junado/thermomix-tm31-power-board/datasheets/README.md

# Datasheets

Datasheets are mostly **linked, not mirrored**: they are copyrighted by their manufacturers. The exception is the
discontinued microcontroller, whose datasheet is **archived unmodified in [archive/](archive/NOTICE.md)** (with a
SHA-256 manifest) so the schematic stays usable if the last copies online disappear. Several links point to
distributor or datasheet-archive pages because the original manufacturer pages for these older parts have moved.
Links were collected in November 2026 (web searches; TI, ST and Nexperia links follow those manufacturers' standard
datasheet URLs). If one breaks, search for the part number.

| Ref | Part | Datasheet |
|---|---|---|
| IC1 | NEC/Renesas µPD78F0034(B), 78K0 8-bit MCU | **[Archived copy](archive/NEC_uPD78F0034_datasheet.pdf)** · [Elcodis (UPD78F0034A, same family)](https://elcodis.com/parts/5704542/UPD78F0034AGK-9ET.html). The pinout used here is from the NEC µPD78F0034 data sheet, p. 6 (64-pin QFP "GC"); port types from p. 11 |
| IC501, IC502 | Infineon (International Rectifier) IR2106S | [Findchips: IR2106S](https://www.findchips.com/detail/ir2106s/Infineon-Technologies-AG) |
| IC503 | 74HC123 / 74HCT123 dual retriggerable monostable | [Nexperia 74HC_HCT123](https://assets.nexperia.com/documents/data-sheet/74HC_HCT123.pdf) |
| IC610 | ST LM393 dual comparator | [ST LM393](https://www.st.com/resource/en/datasheet/lm393.pdf) |
| IC611, IC700 | TI TLC277 dual op-amp | [TI TLC277](https://www.ti.com/lit/ds/symlink/tlc277.pdf) |
| IC200 | TI TL431 shunt reference | [TI TL431](https://www.ti.com/lit/ds/symlink/tl431.pdf) |
| IC100 | Panasonic MIP2E3D (IPD flyback switcher) | [Panasonic MIP2E3DMTSCF](https://uploadcdn.oneyac.com/attachments/files/brand_pdf/panasonic/MIP2E3DMTSCF_E.pdf) (same die family; this board uses MIP2E3DMY) |
| CR700 | ST BTA24-600BW (replacement) / BTA12-600BW (230 V original) | [Findchips: BTA24-600BW](https://findchips.com/detail/BTA24-600BW/STMicroelectronics) · [BTA12-600BW at Conrad](https://www.conrad.fr/p/thyristor-scr-triac-stmicroelectronics-bta12-600bw-to-220ab-12-a-600-v-1-pcs-151539) |
| PC700 | MOC3063(M) zero-cross opto-triac | [onsemi MOC3063M (Octopart)](https://octopart.com/part/onsemi/MOC3063M) |
| PC501–PC503 | Lite-On LTV-816 | [RS: Lite-On LTV-816](https://uk.rs-online.com/web/p/optocoupler-ics/1689659) |
| Q500–Q505 | Infineon SGP04N60 (marking G04N60) | [SGP04N60 (Alldatasheet)](https://html.alldatasheet.com/html-pdf/93965/INFINEON/SGP04N60/2938/9/SGP04N60.html) |
| Small NPN / PNP | BC846 / BC856 family (SOT-23) | [Nexperia BC846 series](https://assets.nexperia.com/documents/data-sheet/BC846_SER.pdf) · [Nexperia BC856 series](https://assets.nexperia.com/documents/data-sheet/BC856_SER.pdf) |
| RY200, RY202 | TE/Schrack RTH34012WG (RT1 16 A, 12 V DC) | [RTH34012 specification](https://manualmachine.com/tyco/rth34012/27845218-specification) |
| RY201 | Song Chuan 899-1C-F-C 12 V DC | [899-1C-F-C-12VDC (Scribd)](https://www.scribd.com/document/621802395/899-1C-F-C-12VDC) · [Findchips: 899 series](https://findchips.com/detail/899-1c-f-s-12vdc/Song-Chuan-Precision-Company) |

Not found: HARTU 711078-51 current transformer, D1D8A flyback transformer (custom parts).
