junado/thermomix-tm31-power-board/docs/16-references.md

# 16 — References

## Repair forums (French, CommentReparer.com)

- [Réparer platine de puissance Thermomix TM31](https://www.commentreparer.com/19283/Robot-mixeur/reparer-platine-de-puissance-Thermomix-TM31):
  shorted BTA12-600BW triac → continuous heating / error 69; replacement procedure (drill the rivet, thermal paste,
  screw).
- [Thermomix TM 31 qui ne chauffe plus](https://www.commentreparer.com/84308/Robot-mixeur/Thermomix-TM-31-qui-ne-chauffe-plus):
  same no-heat, no-error symptom on a first-generation TM31; fixed by a used power board.
- [Thermomix Tm 31 qui ne chauffe plus](https://www.commentreparer.com/45891/Robot-mixeur/Thermomix-Tm-31-qui-ne-chauffe-plus)
- [Thermomix erreur 69 pas de chauffe](https://www.commentreparer.com/66512/Robot-mixeur/Thermomix-erreur-69-pas-de-chauffe):
  bowl pin numbering and the service-guide values.
- [Diagnostique Bol TM31 / valeurs résistance ?](https://www.commentreparer.com/53848/Robot-mixeur/Diagnostique-Bol-TM31-valeurs-resistance):
  includes a 120 V TM31 triac reading (~73 Ω in-circuit).
- [Thermomix TM31 (relay stuck / triac shorted)](https://www.commentreparer.com/37863/Robot-mixeur/Thermomix-TM31)
- [Thermomix TM31 ne fonctionne plus](https://www.commentreparer.com/33611/Robot-mixeur/Thermomix-TM31-ne-fonctionne-plus):
  MIP2E1DMY switcher, relays feeding the bulk capacitor (230 V board).
- [Panne TM31 plus aucune indication](https://www.commentreparer.com/80752/Robot-mixeur/Panne-TM31-plus-aucune-indication)
- [Comment réparer un thermomix tm 31](https://www.commentreparer.com/36592/Robot-mixeur/Comment-reparer-un-thermomix-tm-31):
  error 72 = power relay (Omron G5LA on that board).
- [Erreur 39 thermomix T31](https://www.commentreparer.com/48958/Robot-mixeur/Erreur-39-thermomix-T31)
- [Réparer un Thermomix TM31-1](https://www.commentreparer.com/85205/Robot-mixeur/Reparer-un-Thermomix-TM31-1)

## Service documentation

- [Procédure d'intervention technique sur le TM31 (PDF, French)](https://www.commentreparer.com/doc/21591/Doc-reparation-technique-pdf.pdf):
  common faults, bowl values, heating test, board revision compatibility table, error explanations.
- [Vorwerk support: TM31 system messages (error codes)](https://support-gb.vorwerk.com/hc/en-gb/articles/18202488537116-My-Thermomix-TM31-is-showing-a-system-message)
- [Vorwerk TM31 instruction manual (UK)](https://support.vorwerk.com/hc/article_attachments/360018291699/UK_Thermomix-tm31-user-manual.pdf)

## Other

- [netzwelt.de: end of TM31 support (German)](https://www.netzwelt.de/news/235081-achtung-diesen-thermomix-gibt-bald-keinen-support-mehr.html)
- [EmbDev.net: TM31 shuts off during start (power-board boot loop)](https://embdev.net/topic/570063)

Datasheets: see [../datasheets/README.md](../datasheets/README.md).
