junado/thermomix-tm31-power-board/datasheets/archive/MANIFEST.md

# Archive manifest

| File | Part | Document | Pages | Source | Added | SHA-256 |
|---|---|---|---|---|---|---|
| [NEC_uPD78F0034_datasheet.pdf](NEC_uPD78F0034_datasheet.pdf) | IC1, NEC µPD78F0034(B) 78K0 8-bit flash MCU | NEC data sheet, µPD78F0034 / 78F0034B (PDF created 2000-12-17) | 26 | Copy supplied by the board owner (public datasheet download) | 2026-11-03 | `30c4f615ae8eee96108fa626ede6035724c40eb1b846c4c8780f177ac3665092` |

Pages used in this project: p. 6 (64-pin QFP "GC" pinout) and p. 11 (port types; P30–P33 are N-channel open-drain).

Check a file with `sha256sum <file>` (Linux), `shasum -a 256 <file>` (macOS) or
`Get-FileHash <file>` (PowerShell).
