junado/thermomix-tm31-power-board/images/diagrams/block-diagram.png

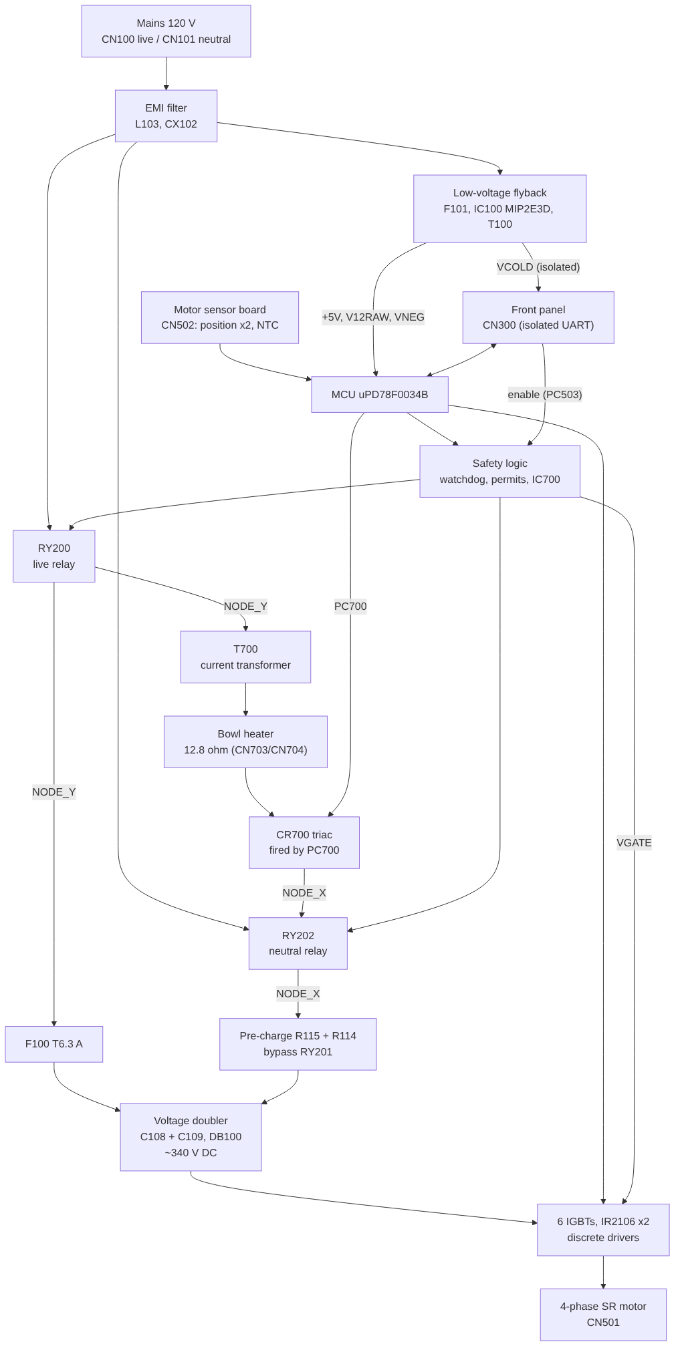
images/diagrams/block-diagram.png
