junado/thermomix-tm31-power-board/images/diagrams/safety-logic.png

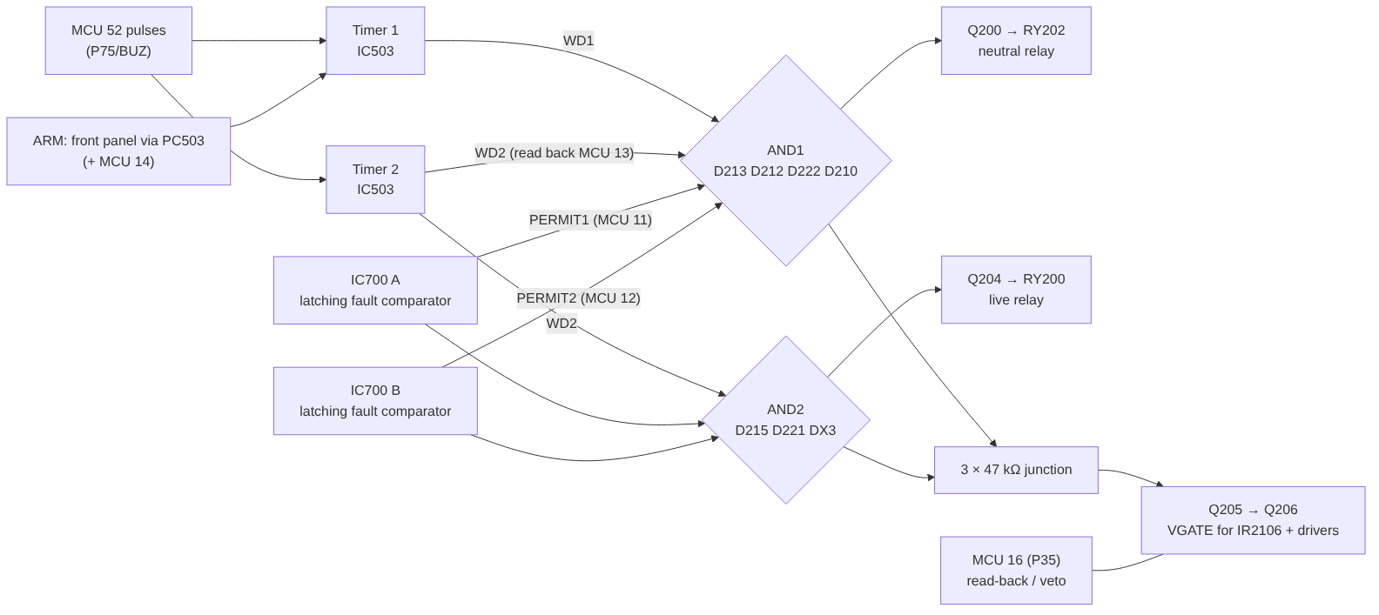
images/diagrams/safety-logic.png
