junado/thermomix-tm31-power-board/photos/01-in-machine/board-in-machine-wide.jpg

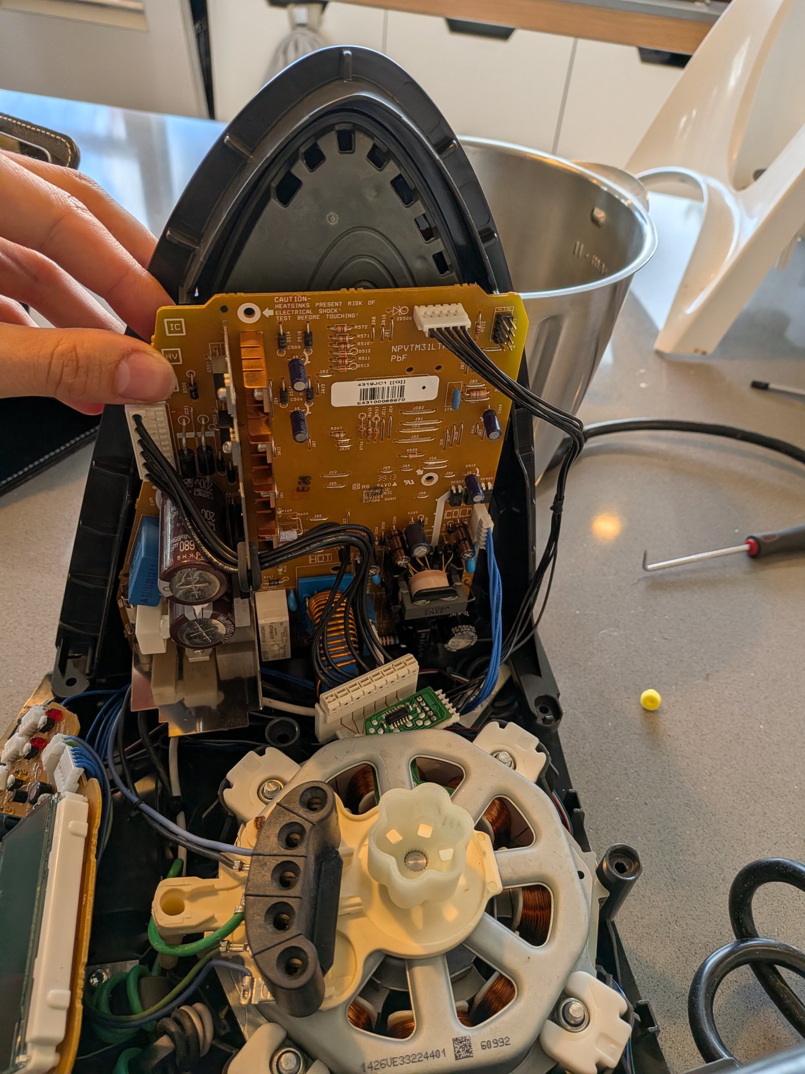
photos/01-in-machine/board-in-machine-wide.jpg
