junado/thermomix-tm31-power-board/photos/01-in-machine/board-top-edge-cn502-cn503.jpg

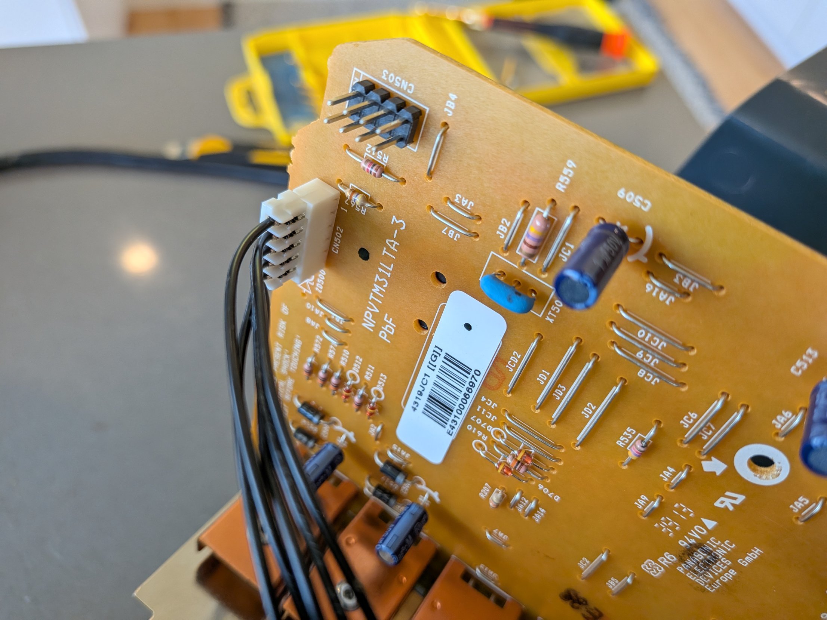
photos/01-in-machine/board-top-edge-cn502-cn503.jpg
