junado/thermomix-tm31-power-board/photos/02-triac/cr700-triac-marking-closeup.jpg

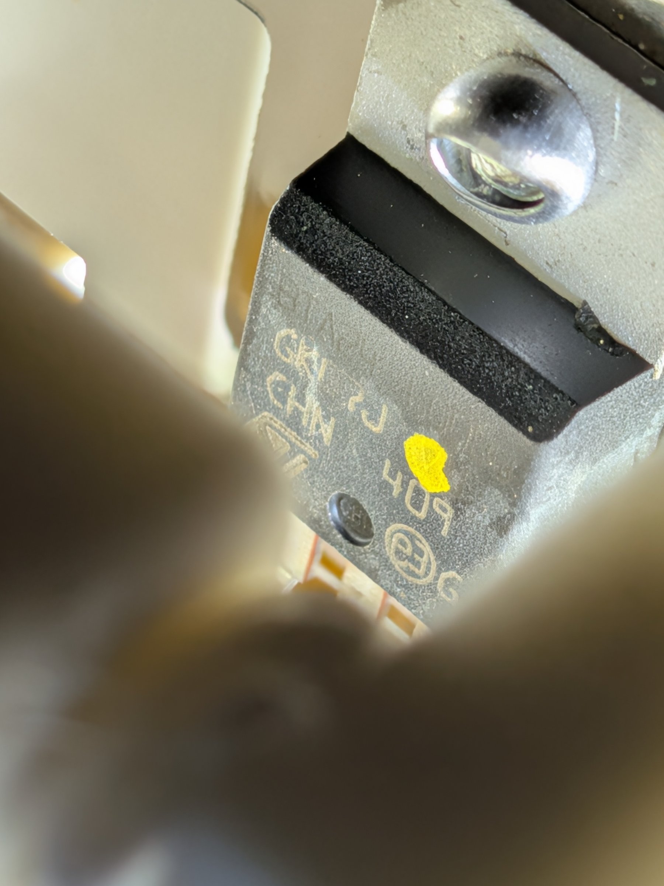
photos/02-triac/cr700-triac-marking-closeup.jpg
