junado/thermomix-tm31-power-board/photos/02-triac/cr700-triac-original-marking.jpg

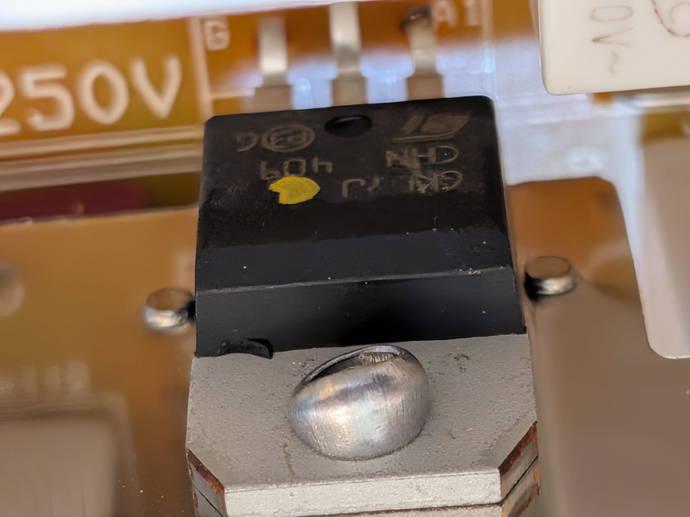
photos/02-triac/cr700-triac-original-marking.jpg
