junado/thermomix-tm31-power-board/photos/03-component-side/bulk-caps-and-heatsink.jpg

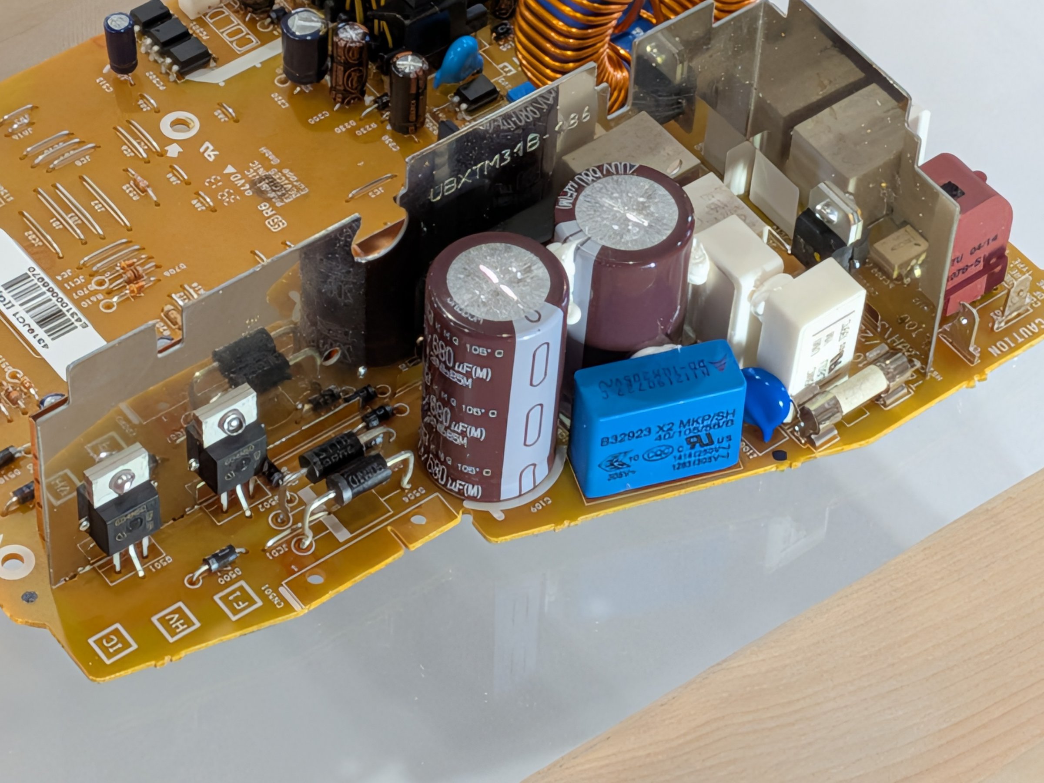
photos/03-component-side/bulk-caps-and-heatsink.jpg
