junado/thermomix-tm31-power-board/photos/03-component-side/component-side-backlit.jpg

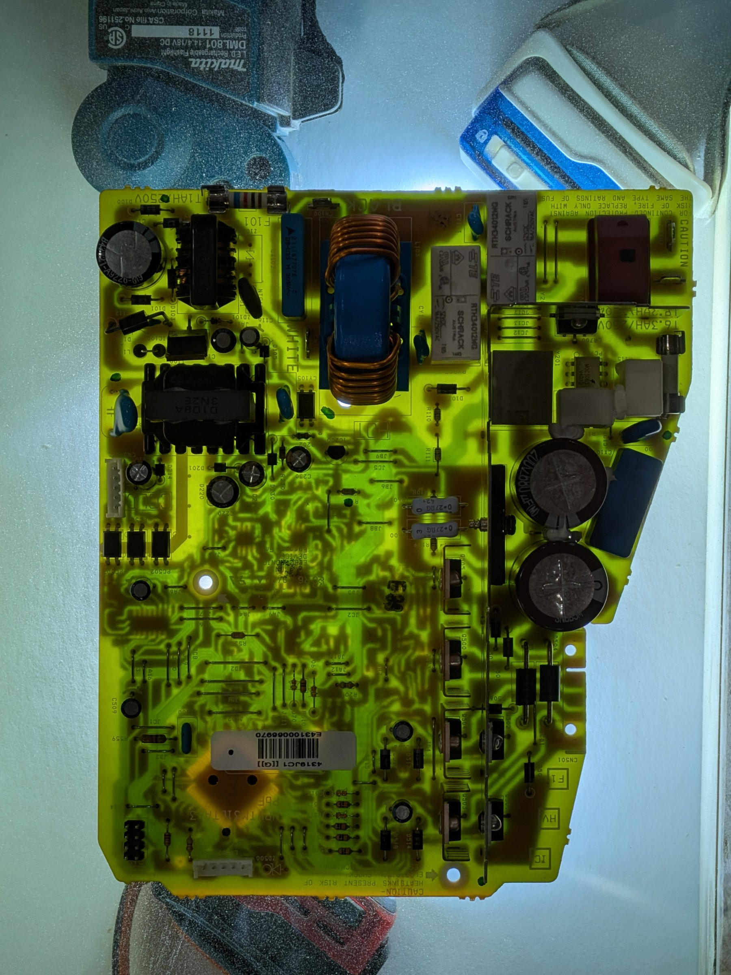
photos/03-component-side/component-side-backlit.jpg
