junado/thermomix-tm31-power-board/photos/03-component-side/component-side-full.jpg

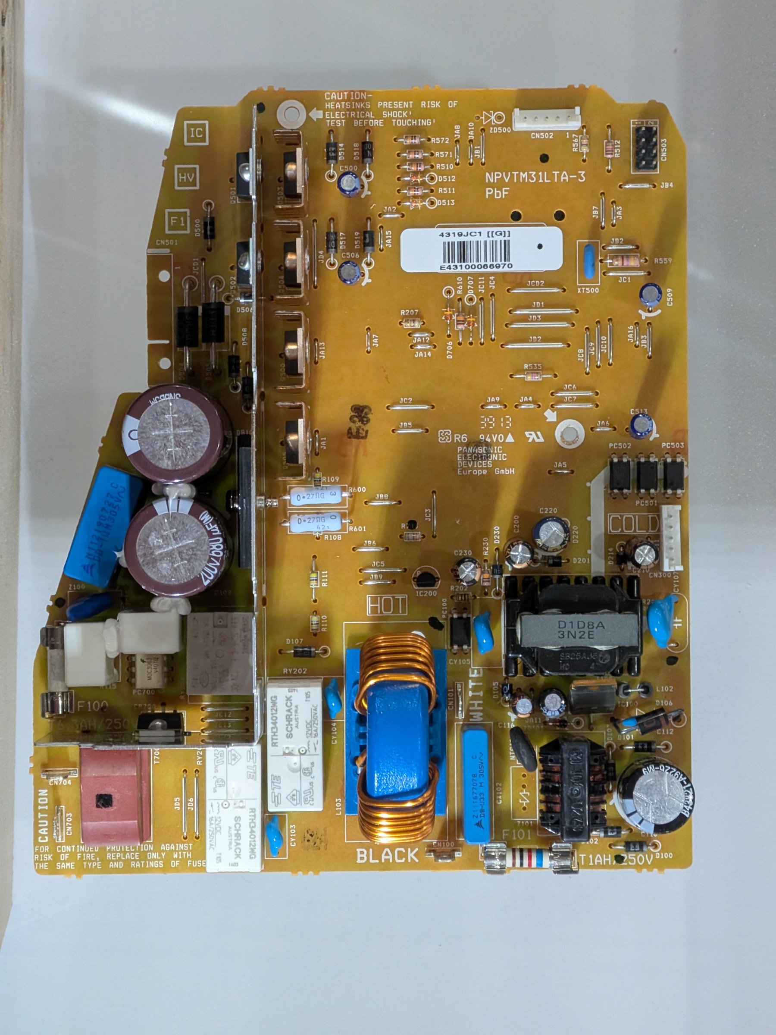
photos/03-component-side/component-side-full.jpg
