junado/thermomix-tm31-power-board/photos/03-component-side/relays-and-filter.jpg

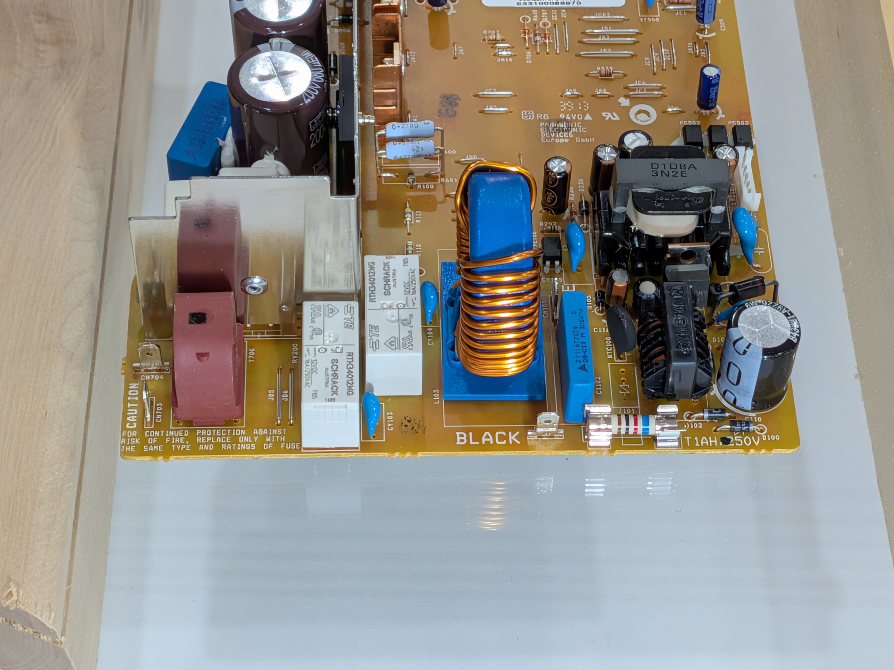
photos/03-component-side/relays-and-filter.jpg
