junado/thermomix-tm31-power-board/images/annotated/solder-side-quadrant-A-cold-side-and-supply.jpg

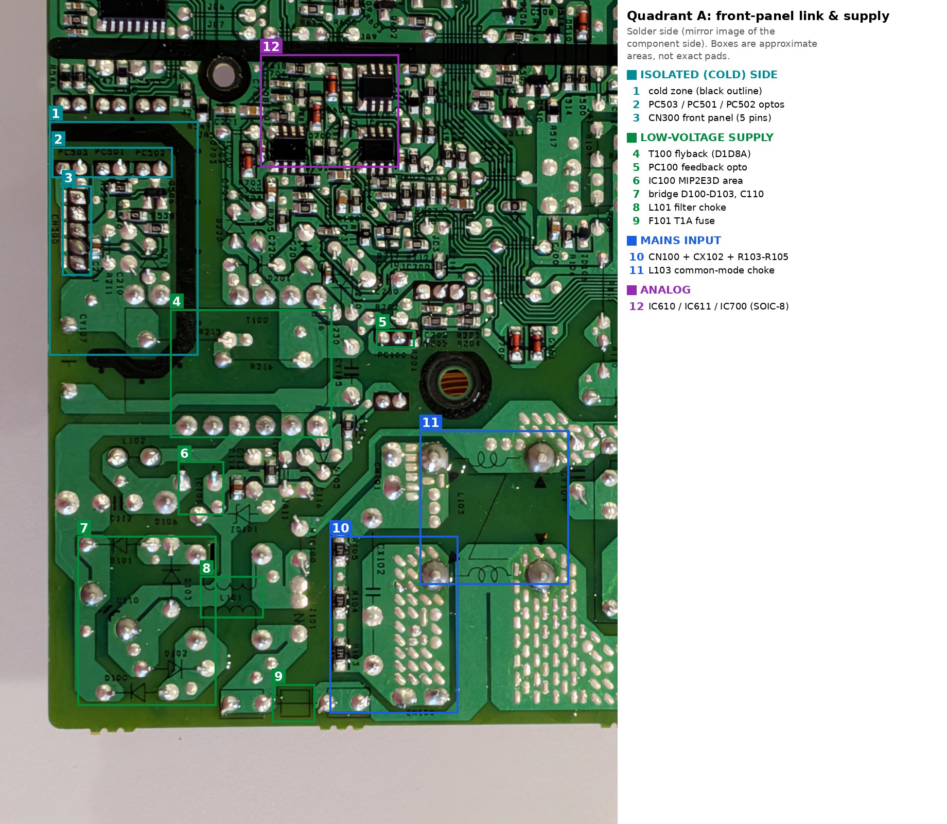
images/annotated/solder-side-quadrant-A-cold-side-and-supply.jpg
