junado/thermomix-tm31-power-board/images/annotated/solder-side-quadrant-B-mcu.jpg

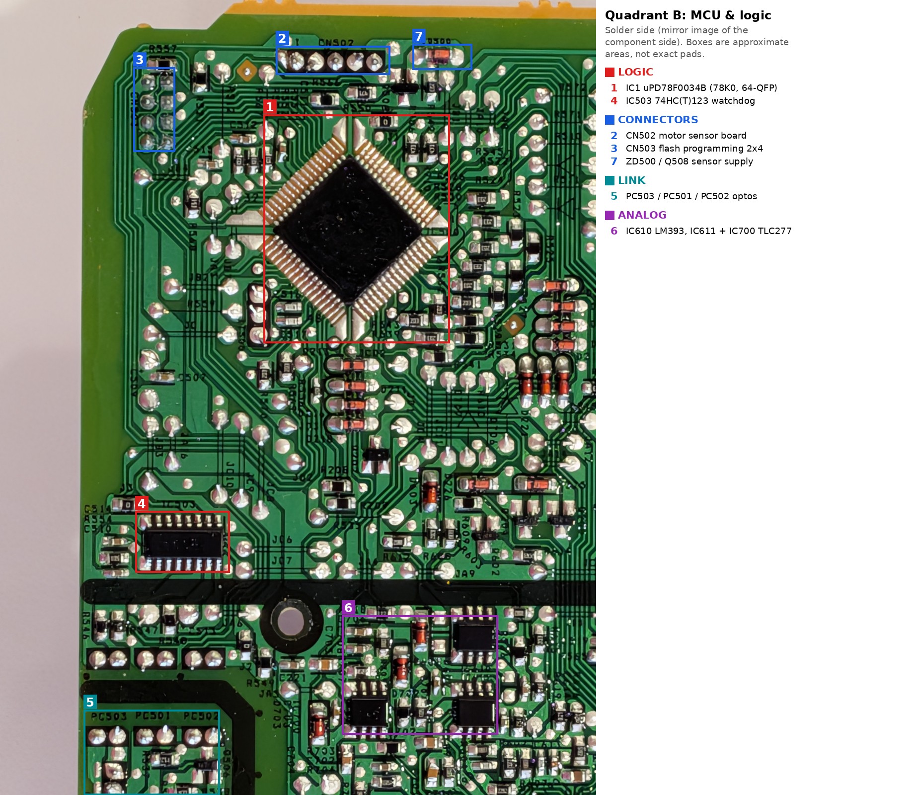
images/annotated/solder-side-quadrant-B-mcu.jpg
