junado/thermomix-tm31-power-board/images/annotated/solder-side-quadrant-C-motor-drive.jpg

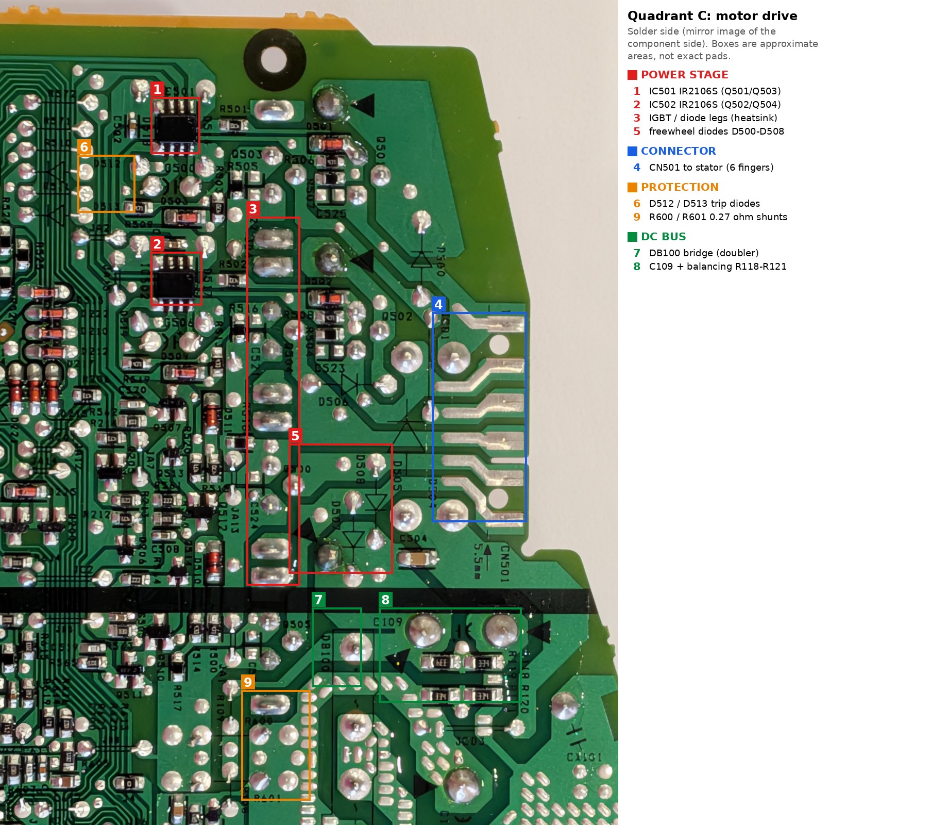
images/annotated/solder-side-quadrant-C-motor-drive.jpg
