junado/thermomix-tm31-power-board/images/annotated/solder-side-quadrant-D-heater-and-power.jpg

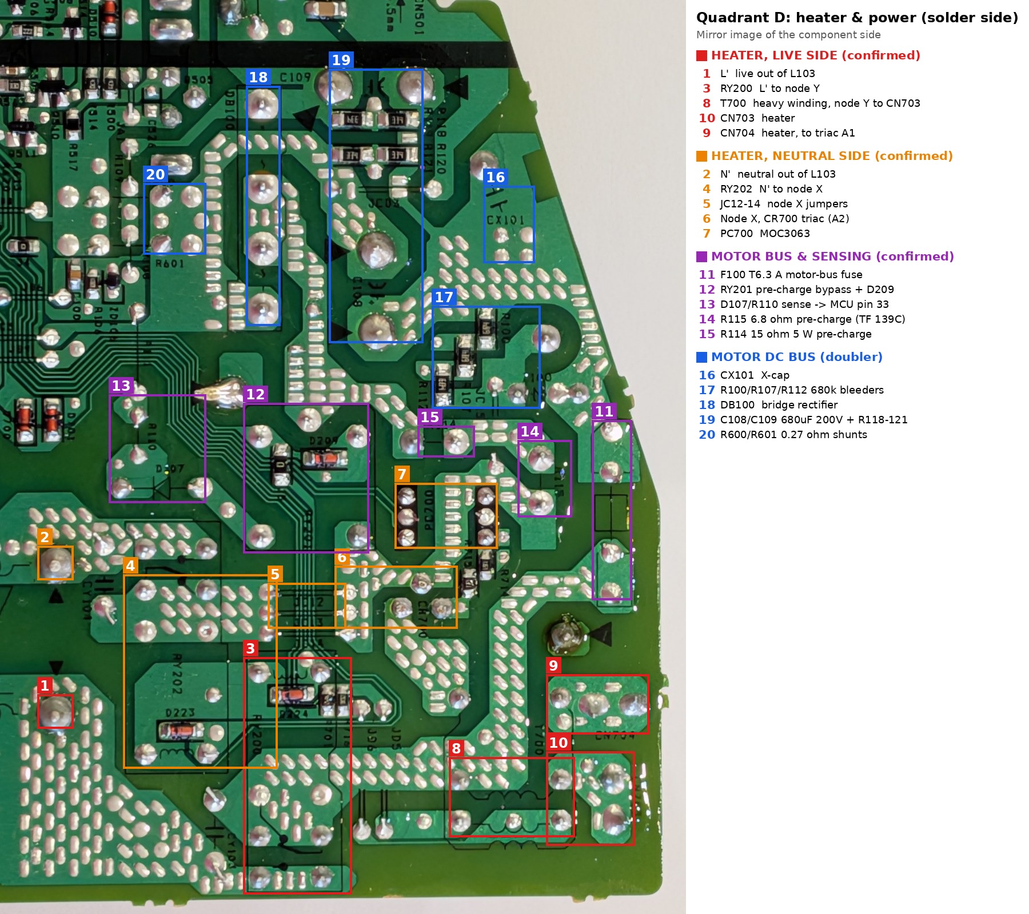
images/annotated/solder-side-quadrant-D-heater-and-power.jpg
