junado/thermomix-tm31-power-board/images/diagrams/machine-wiring.png

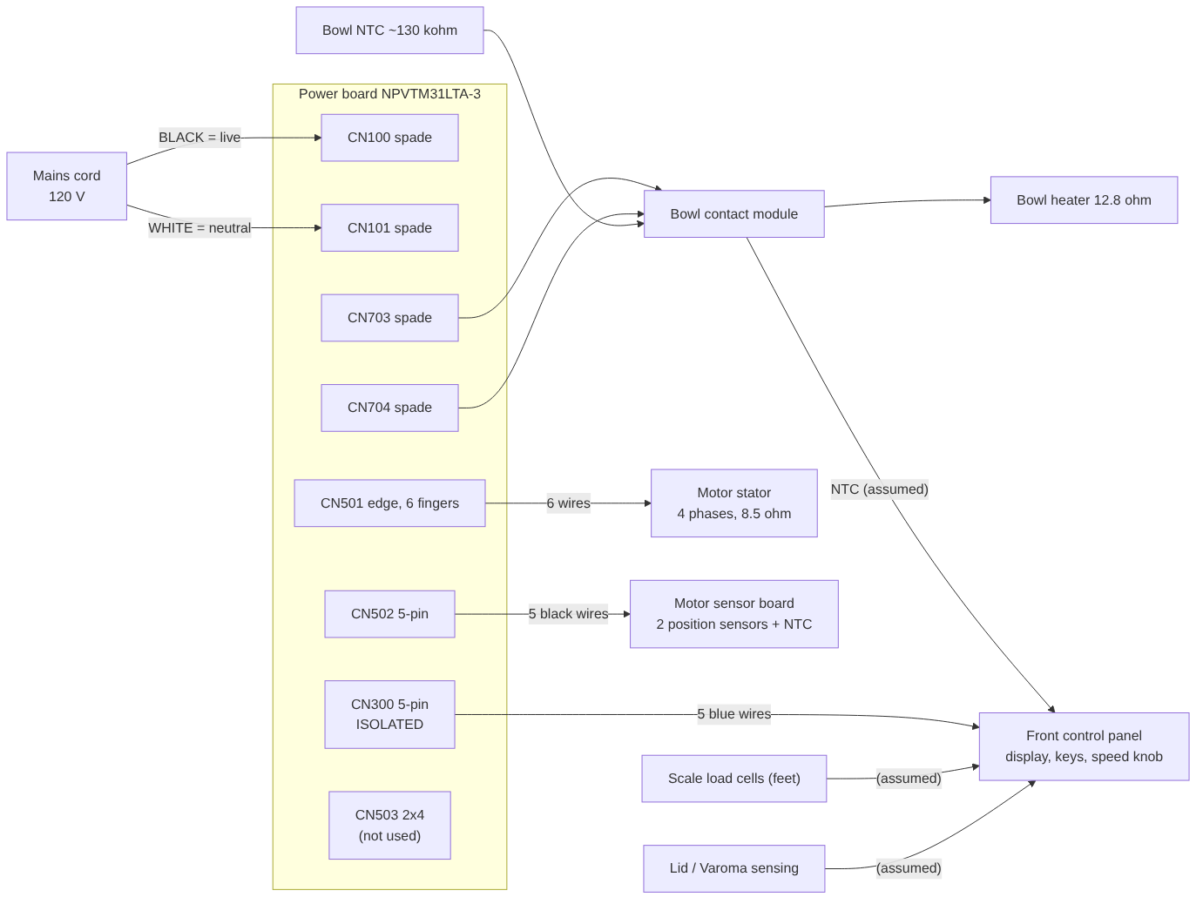
images/diagrams/machine-wiring.png
