junado/thermomix-tm31-power-board/photos/04-solder-side/mcu-closeup.jpg

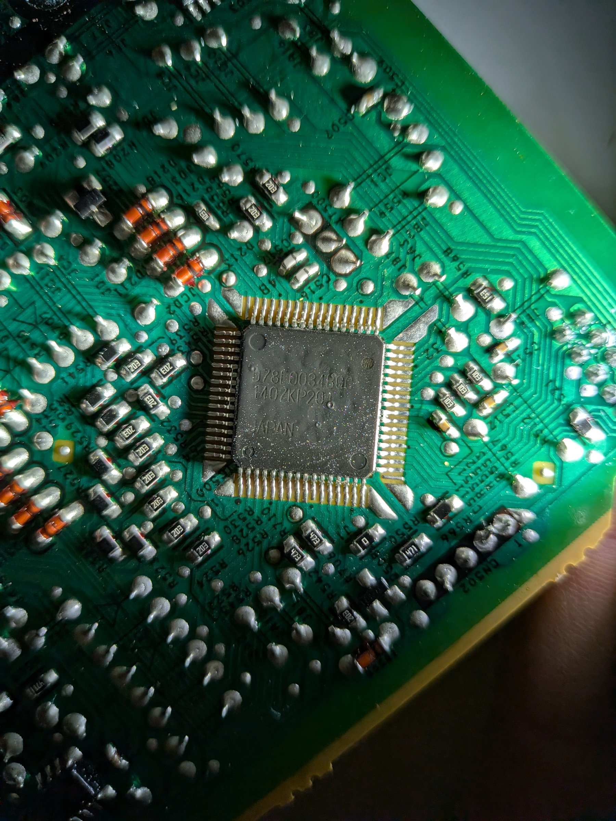
photos/04-solder-side/mcu-closeup.jpg
