junado/thermomix-tm31-power-board/photos/04-solder-side/quadrant-A-cold-side-and-supply.jpg

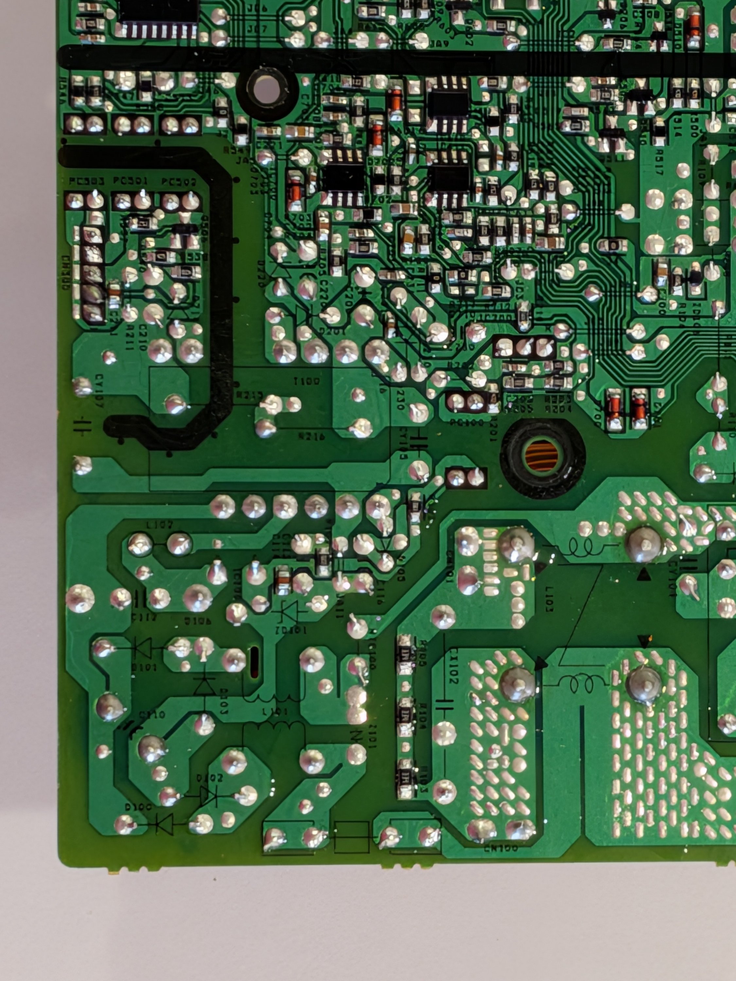
photos/04-solder-side/quadrant-A-cold-side-and-supply.jpg
