junado/thermomix-tm31-power-board/photos/04-solder-side/quadrant-B-mcu.jpg

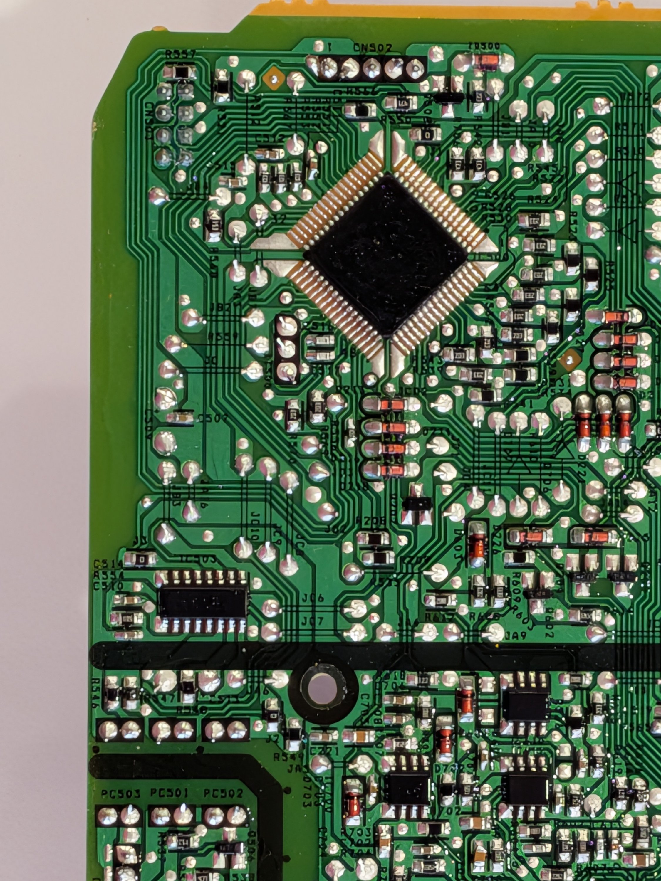
photos/04-solder-side/quadrant-B-mcu.jpg
