junado/thermomix-tm31-power-board/photos/04-solder-side/quadrant-C-motor-drive.jpg

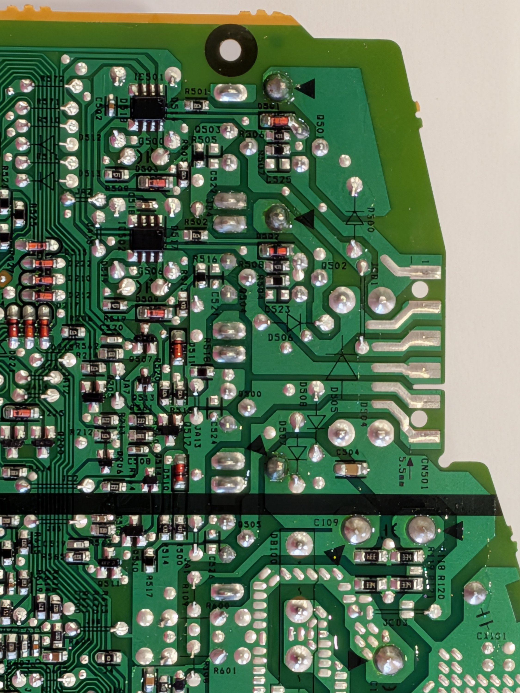
photos/04-solder-side/quadrant-C-motor-drive.jpg
