junado/thermomix-tm31-power-board/photos/04-solder-side/quadrant-D-heater-and-power.jpg

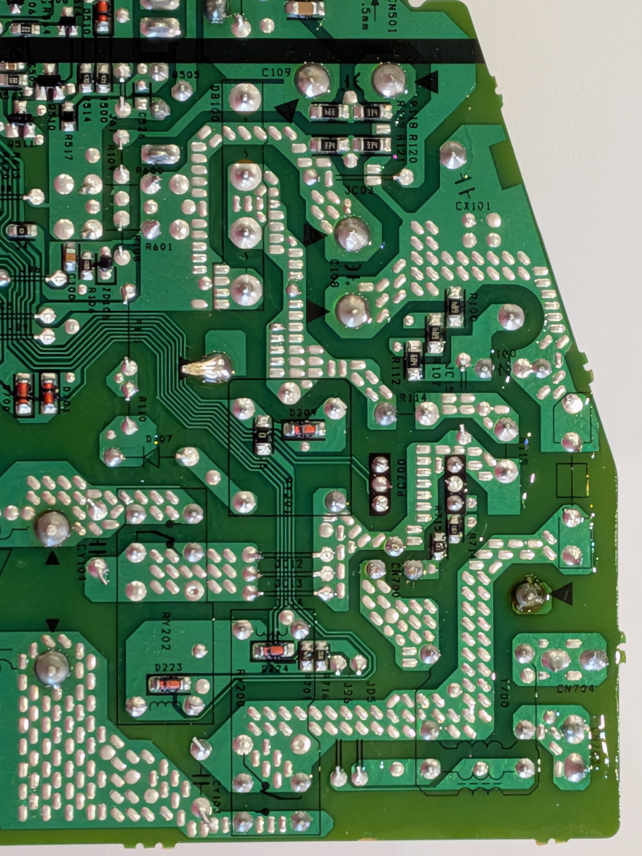
photos/04-solder-side/quadrant-D-heater-and-power.jpg
