junado/thermomix-tm31-power-board/photos/04-solder-side/solder-side-full.jpg

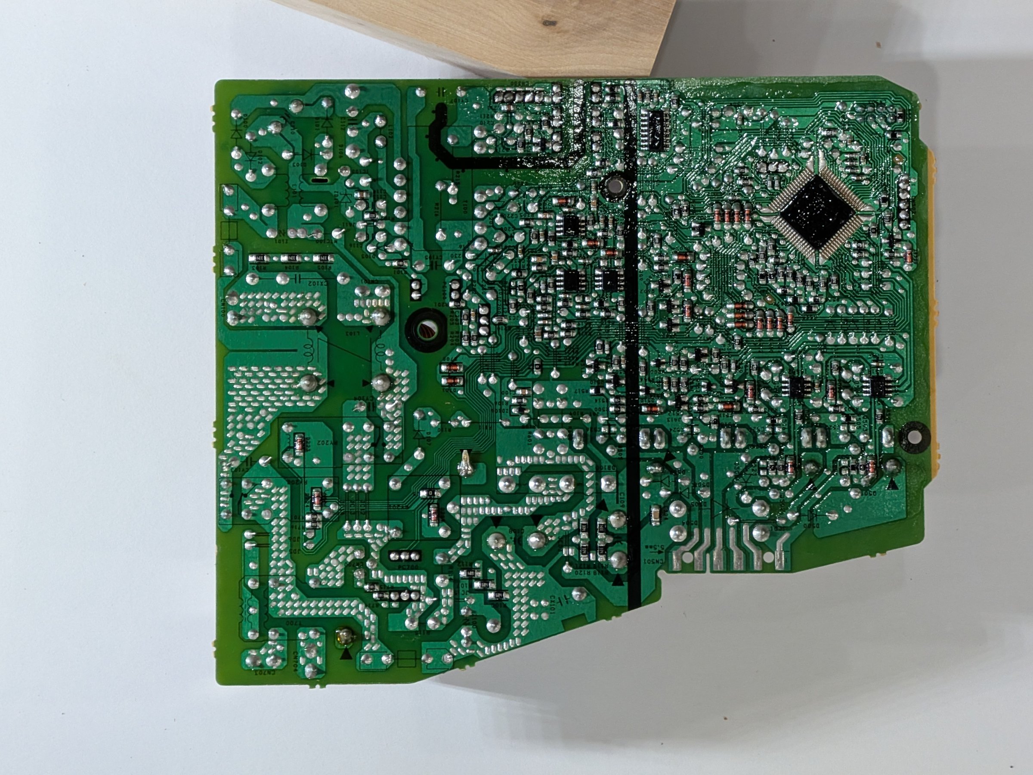
photos/04-solder-side/solder-side-full.jpg
