junado/thermomix-tm31-power-board/hardware/TM31_power_board_schematic.pdf

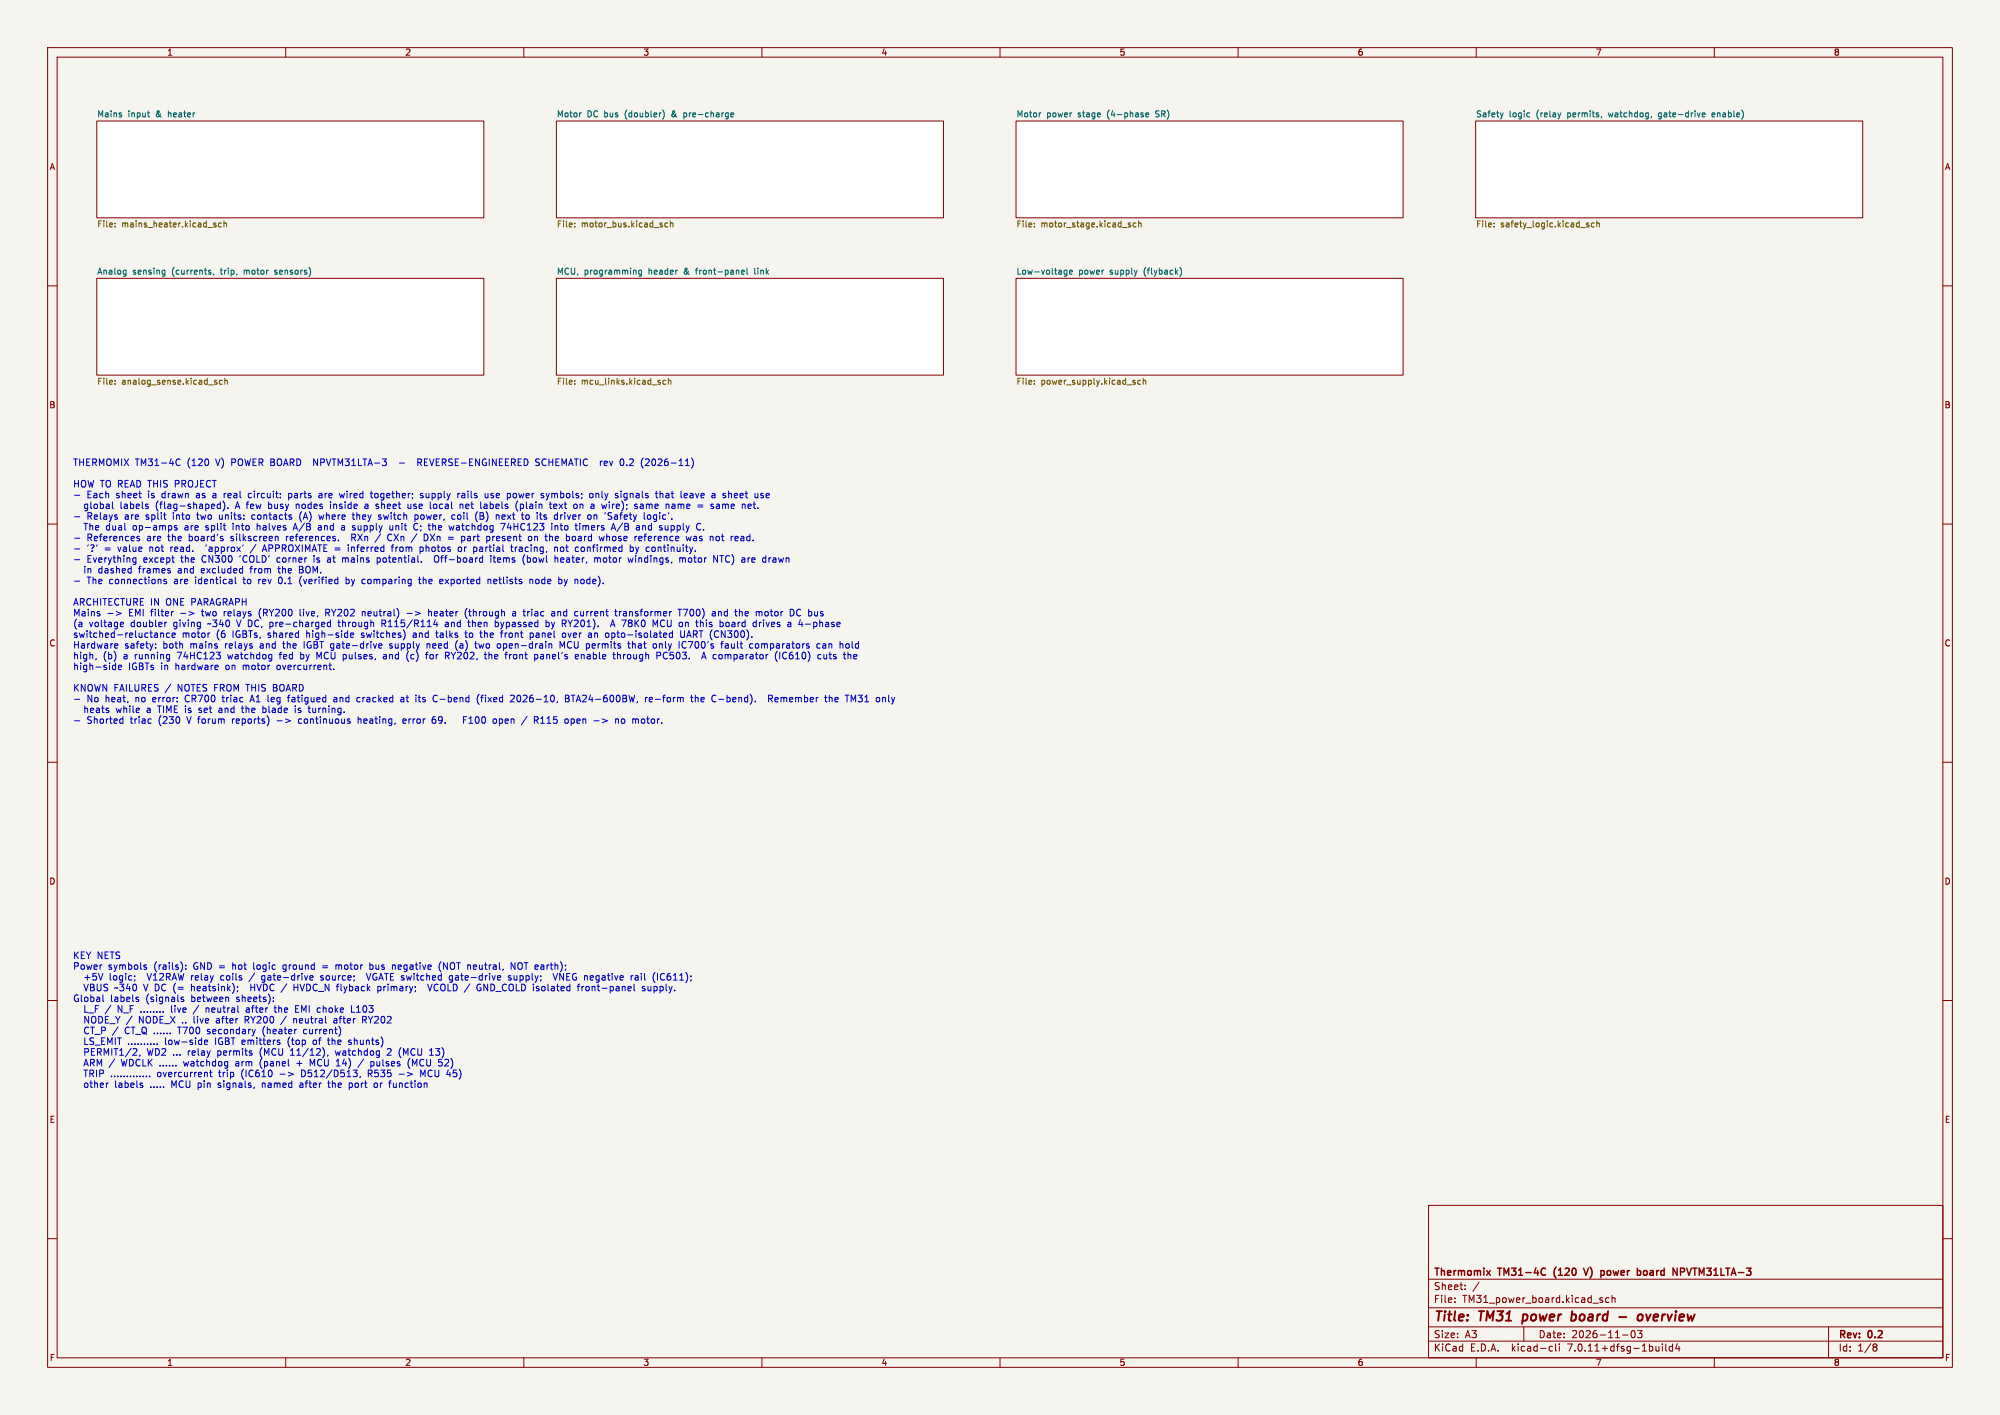
[picture p24: page 1]

Id: 1/8 Title: TM31 power board - overview

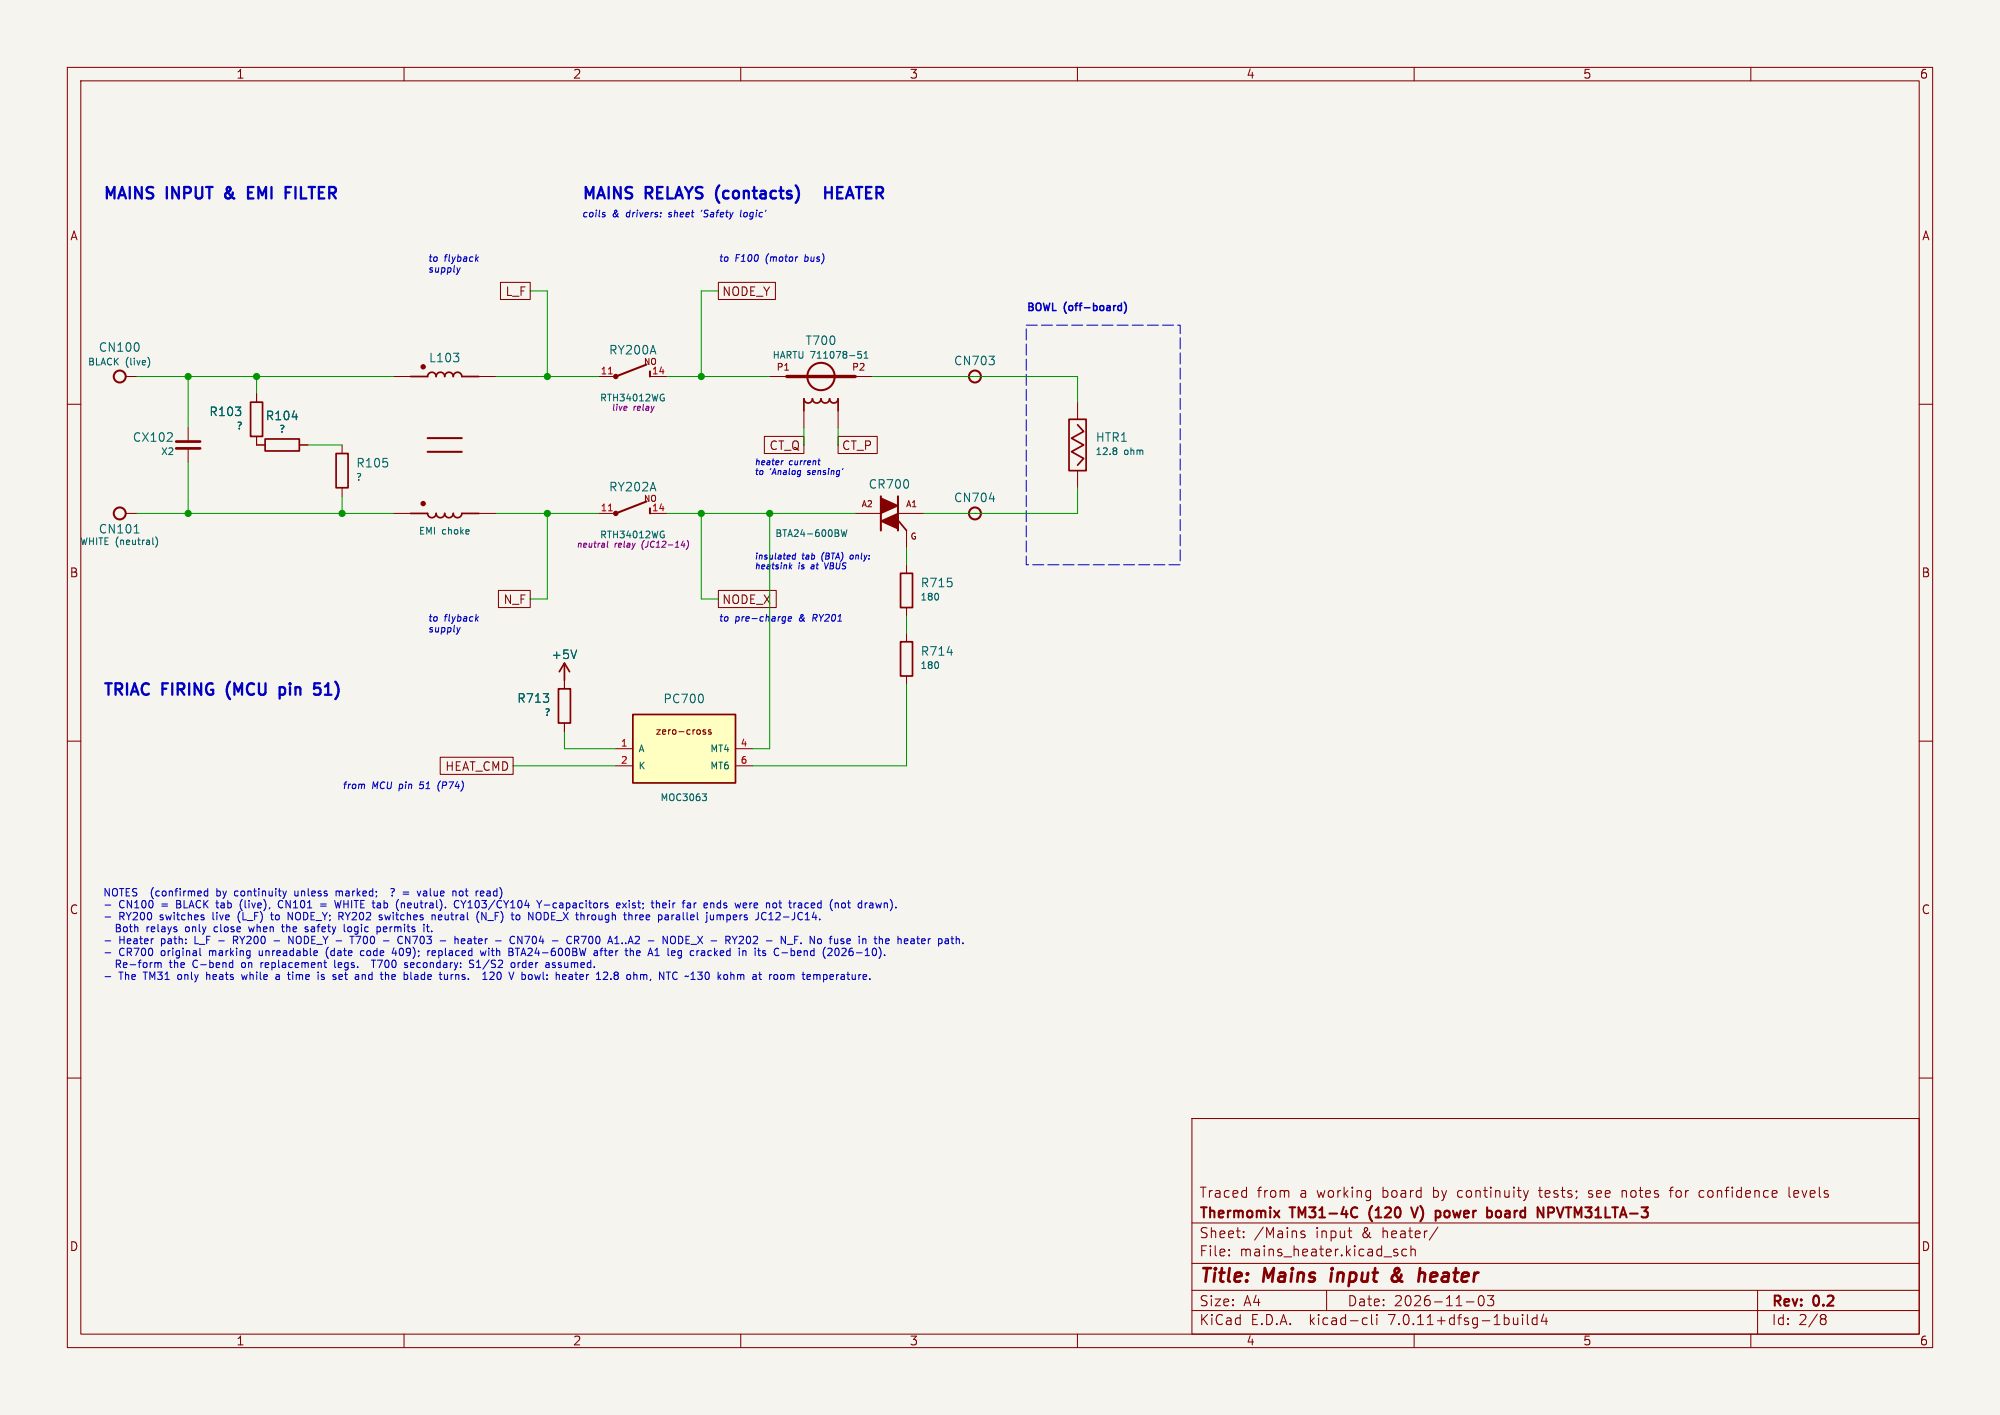
[picture p25: page 2]

MAINS INPUT & EMI FILTER

to 'Analog sensing' MAINS RELAYS (contacts)

to F100 (motor bus) TRIAC FIRING (MCU pin 51)

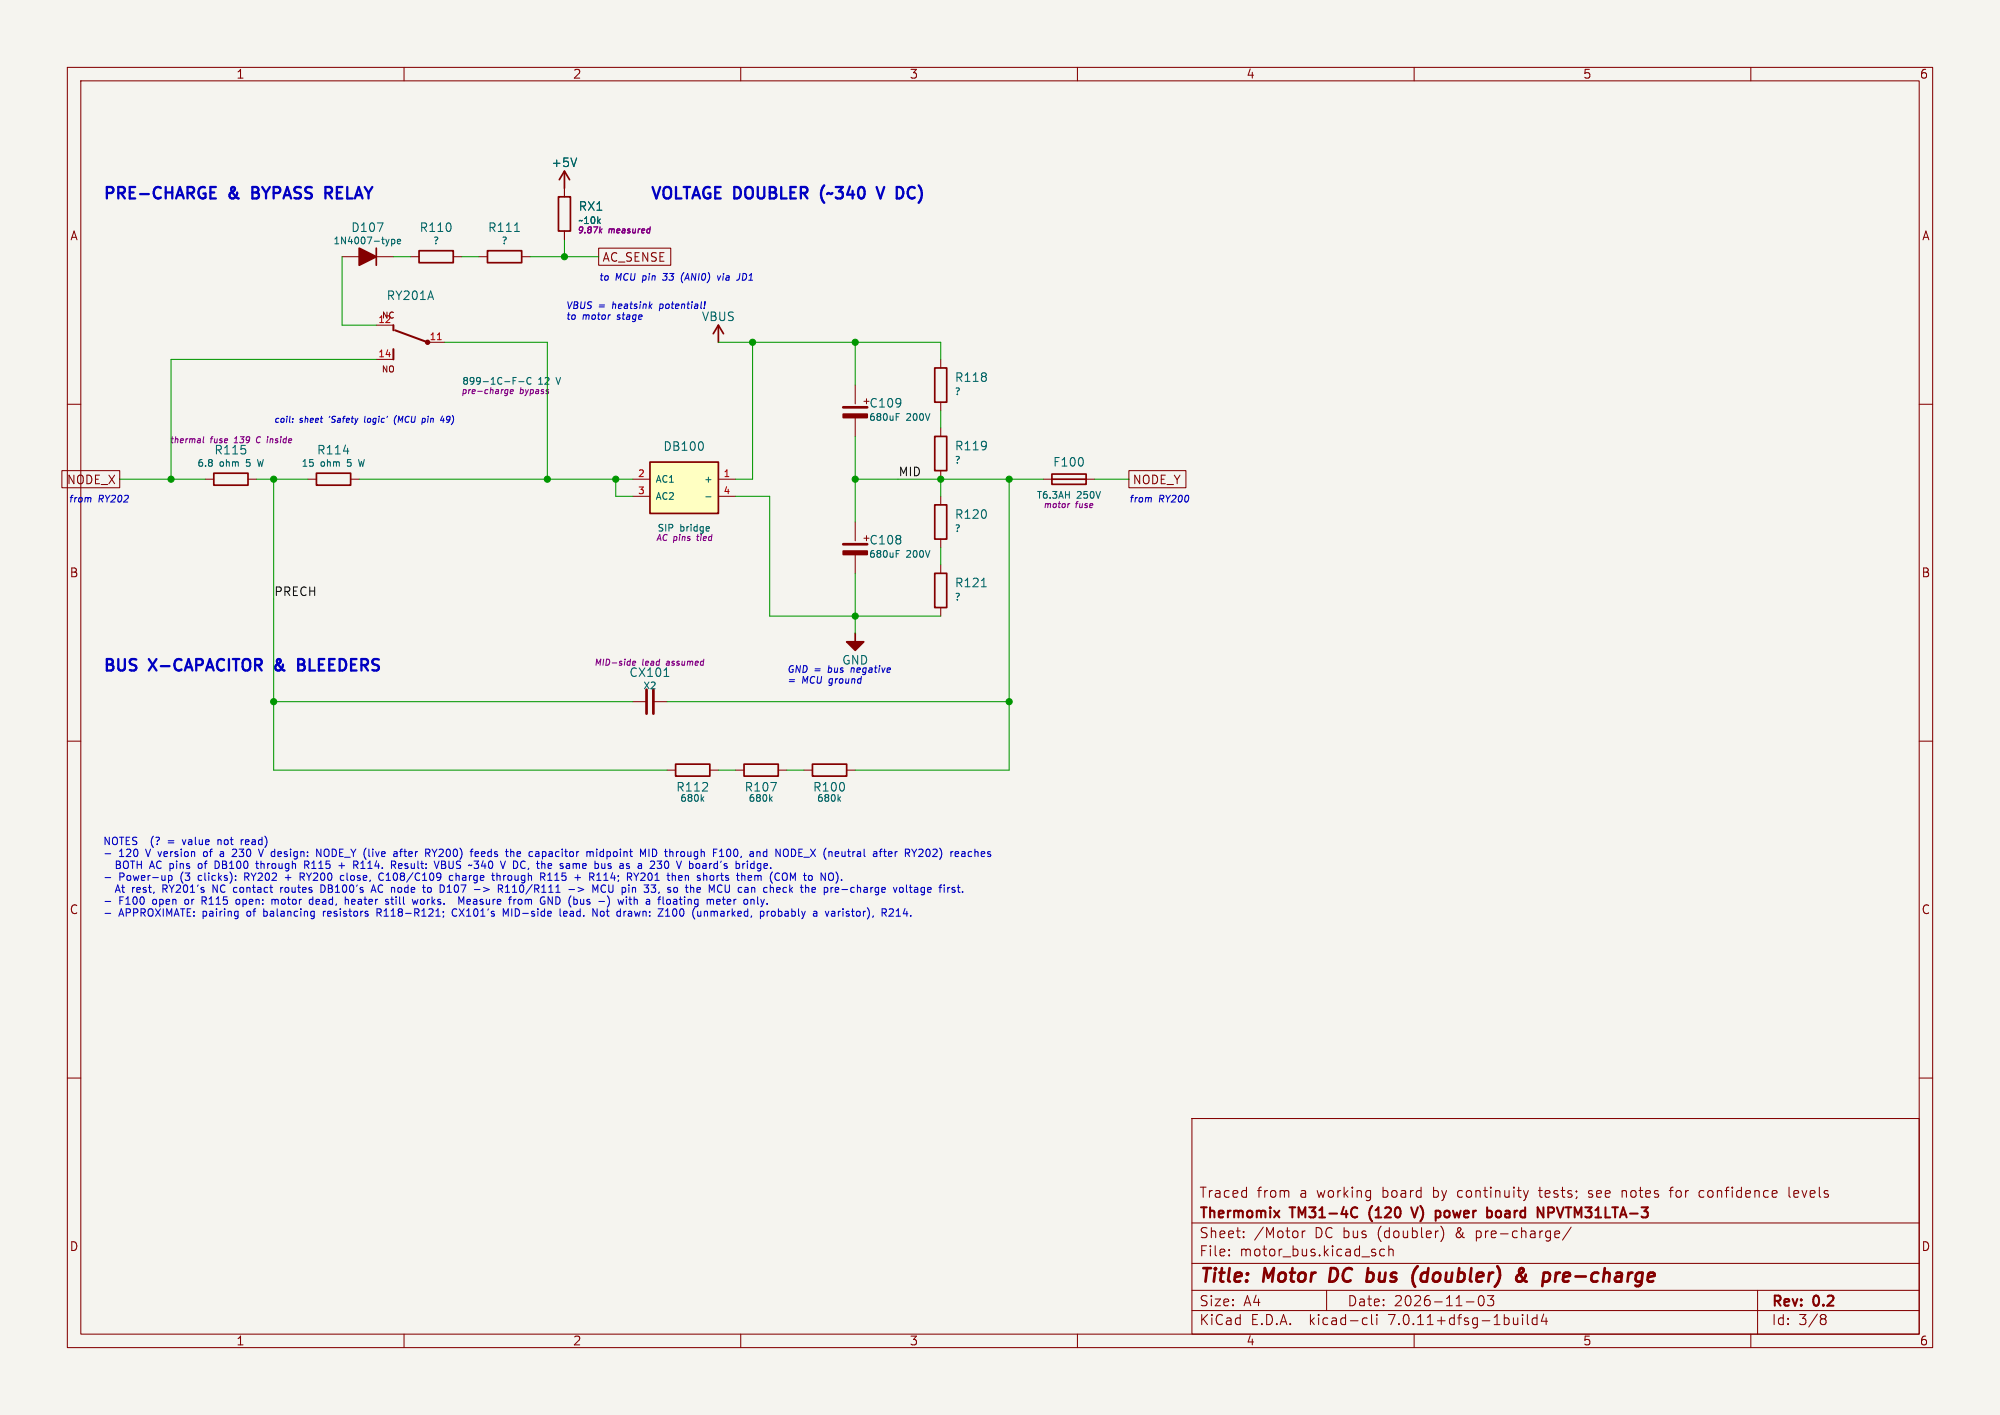
[picture p26: page 3]

from RY200 GND = bus negative = MCU ground PRE-CHARGE & BYPASS RELAY

coil: sheet 'Safety logic' (MCU pin 49)

from RY202 NOTES (? = value not read)

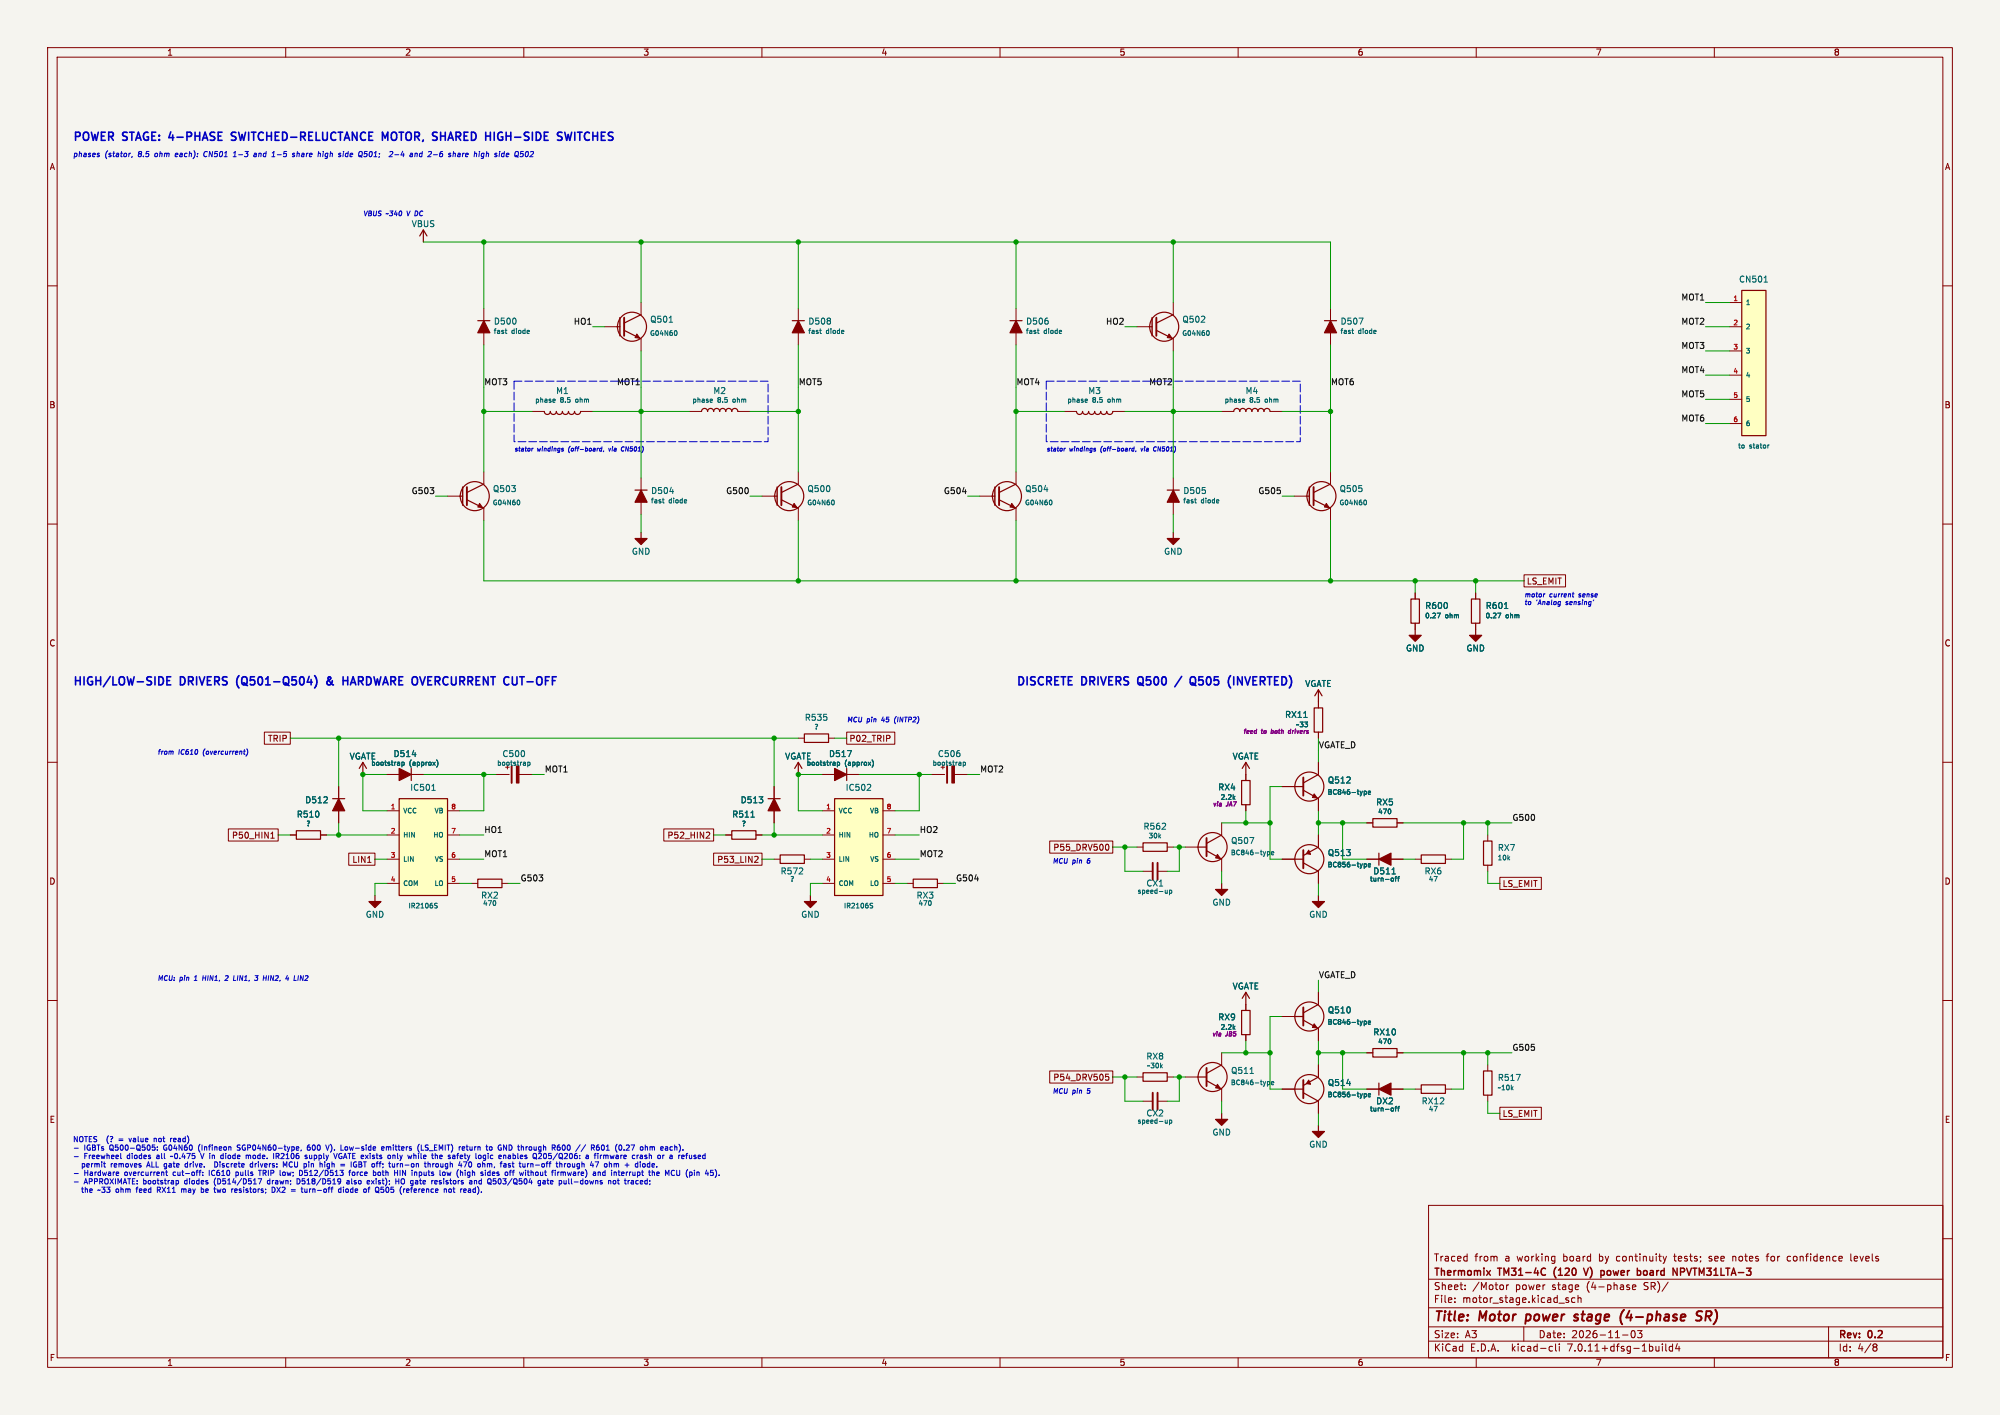
[picture p27: page 4]

feed to both drivers D505

NOTES (? = value not read)

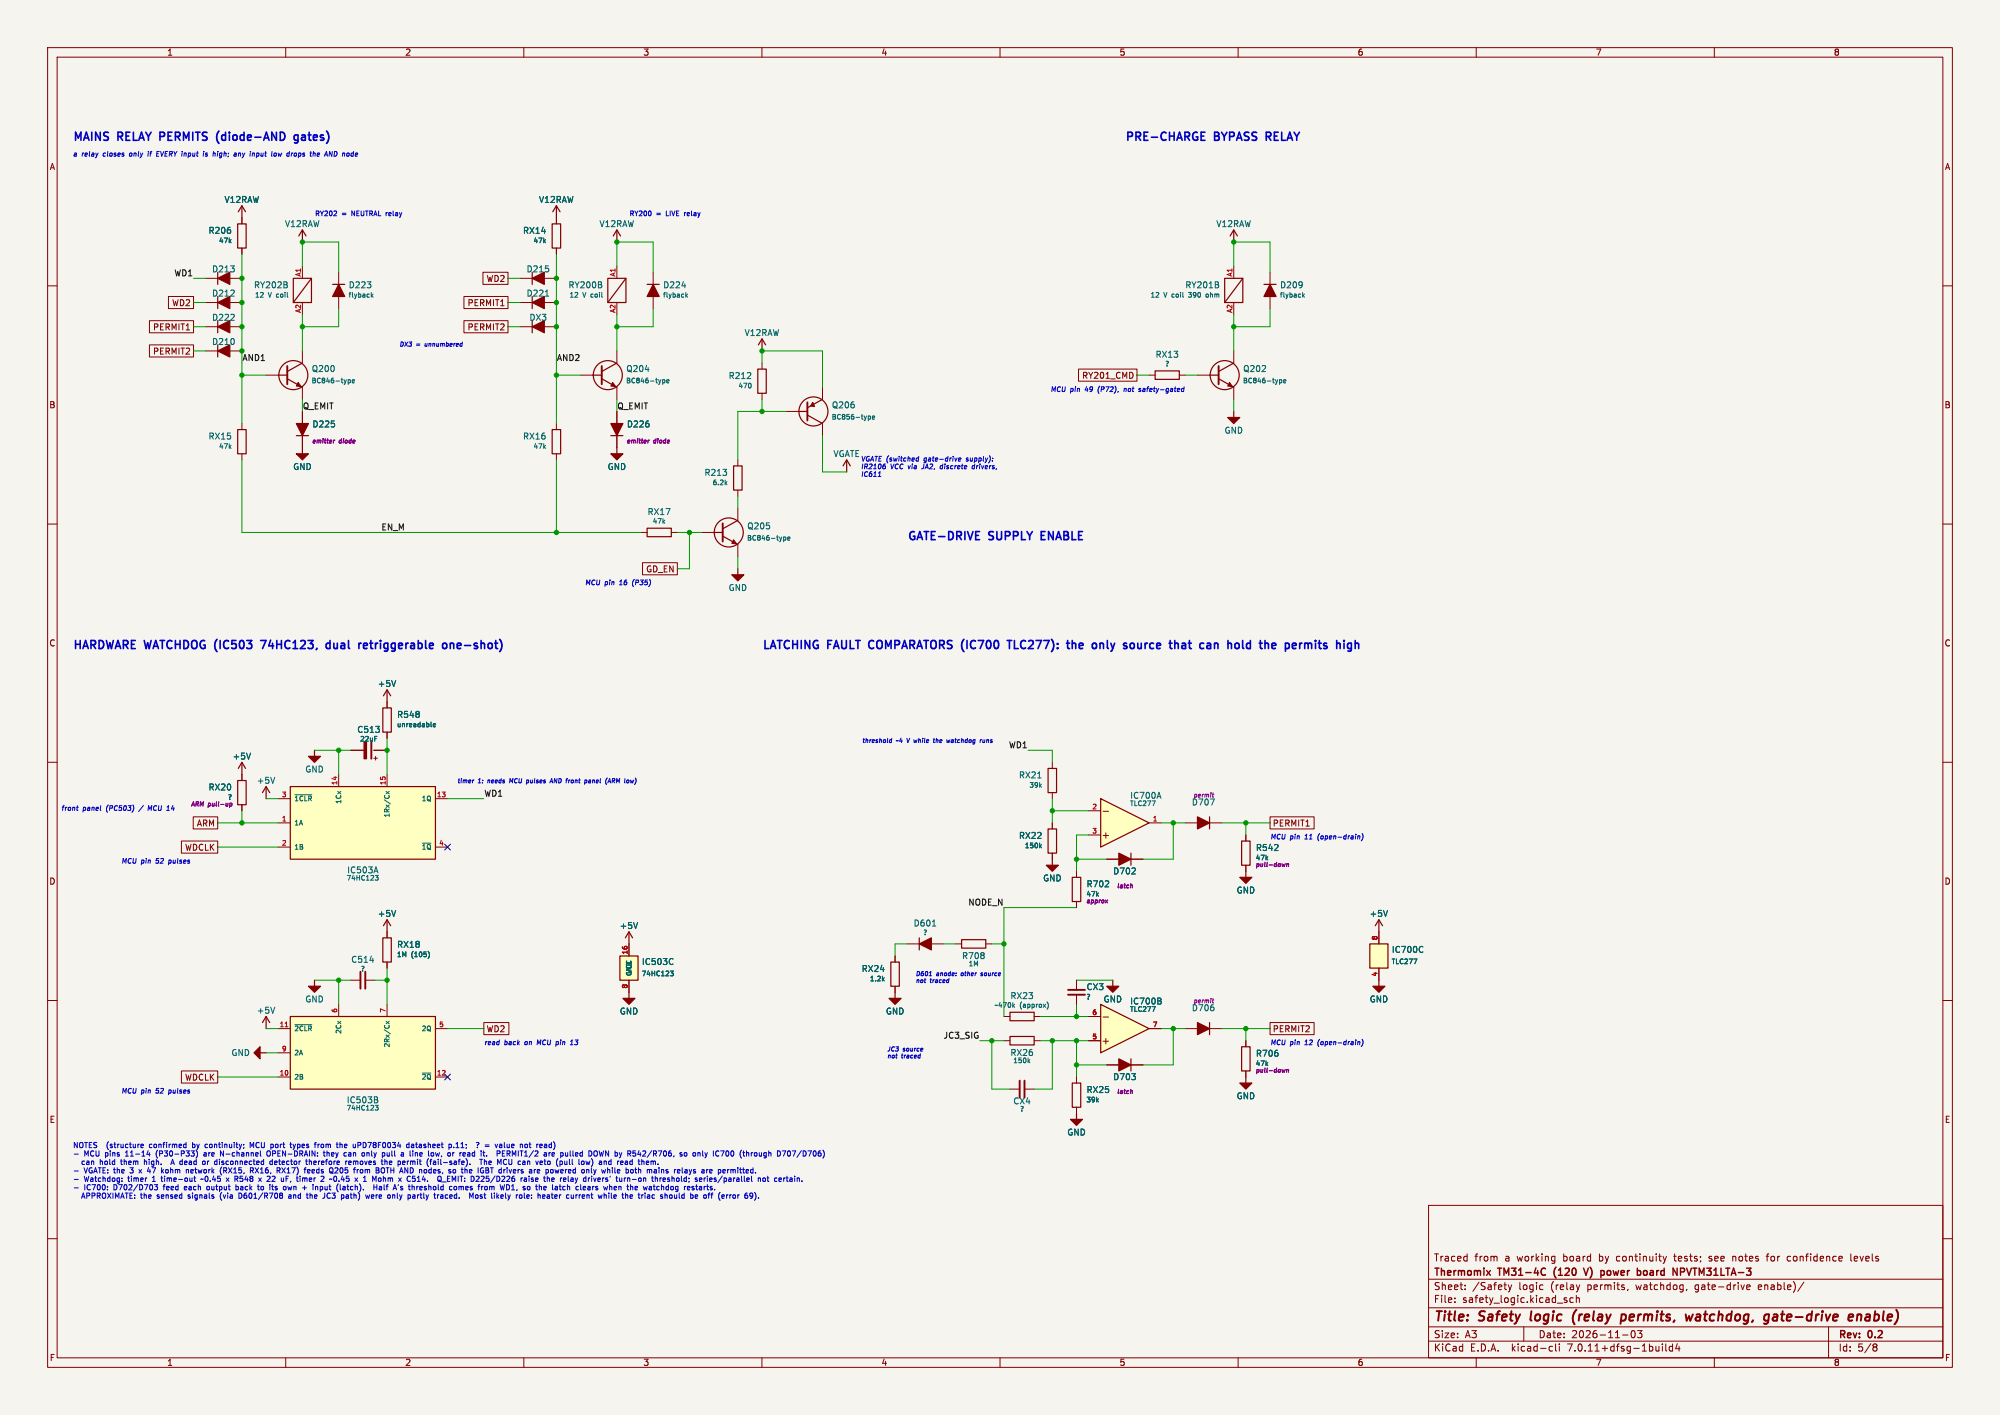
[picture p28: page 5]

a relay closes only if EVERY input is high; any input low drops the AND node

V12RAW
BC846-type GND GND
MCU pin 49 (P72), not safety-gated

not traced GATE-DRIVE SUPPLY ENABLE

timer 1: needs MCU pulses AND front panel (ARM low)

not tracedD601 anode: other source
1.2k GND

read back on MCU pin 13

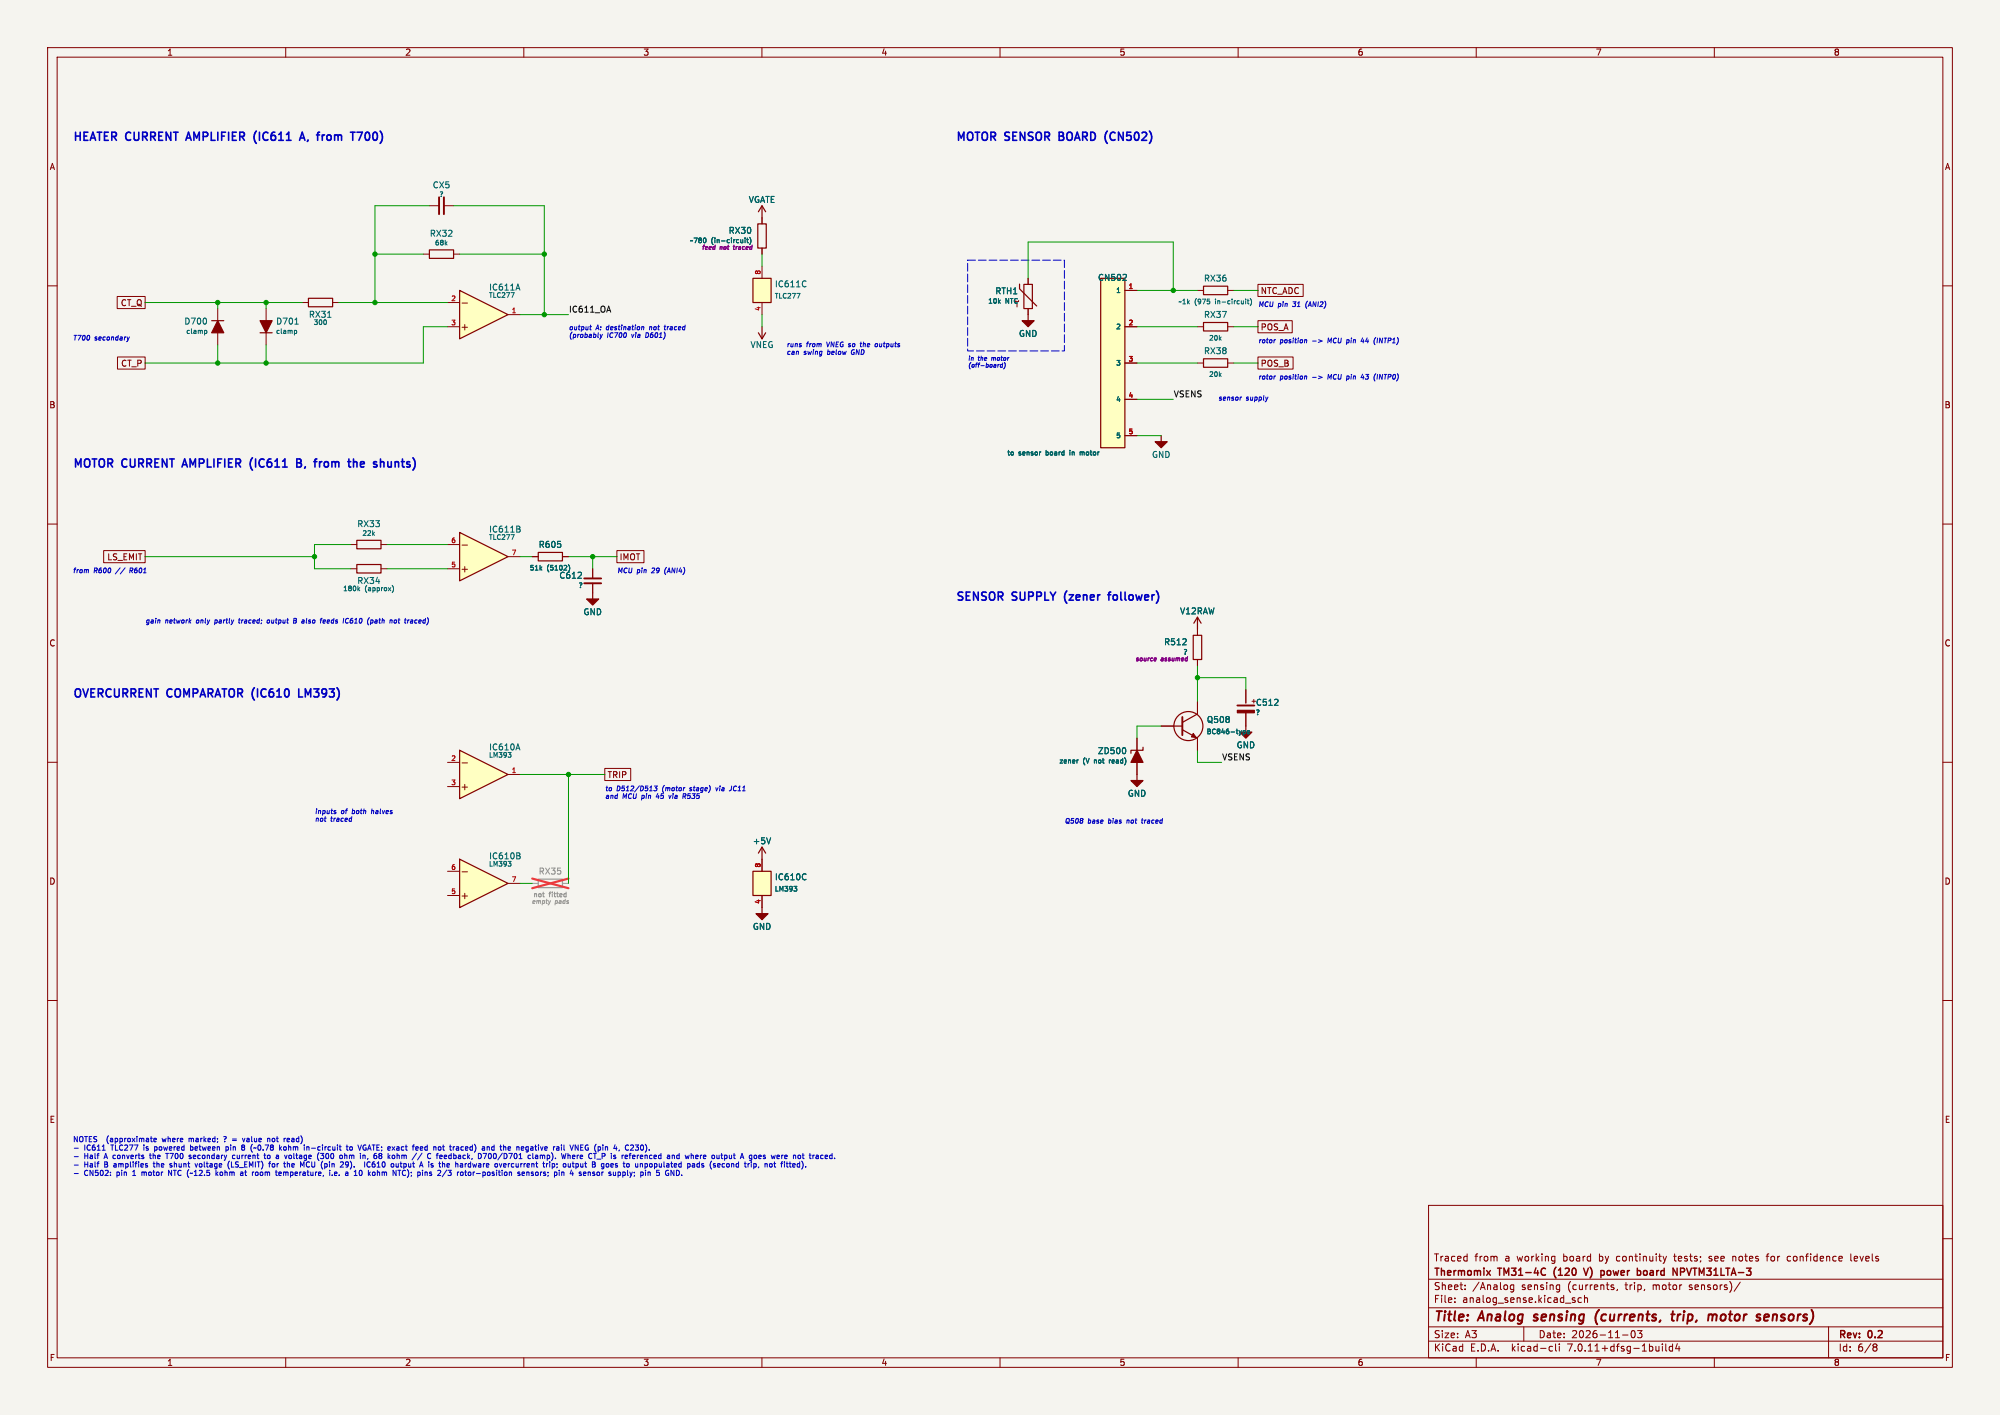
[picture p29: page 6]

MCU pin 31 (ANI2) Q508 base bias not traced

SENSOR SUPPLY (zener follower) T700 secondary

runs from VNEG so the outputs
can swing below GND

to sensor board in motor GND

MOTOR CURRENT AMPLIFIER (IC611 B, from the shunts)

zener (V not read)GND

and MCU pin 45 via R535

inputs of both halves not traced

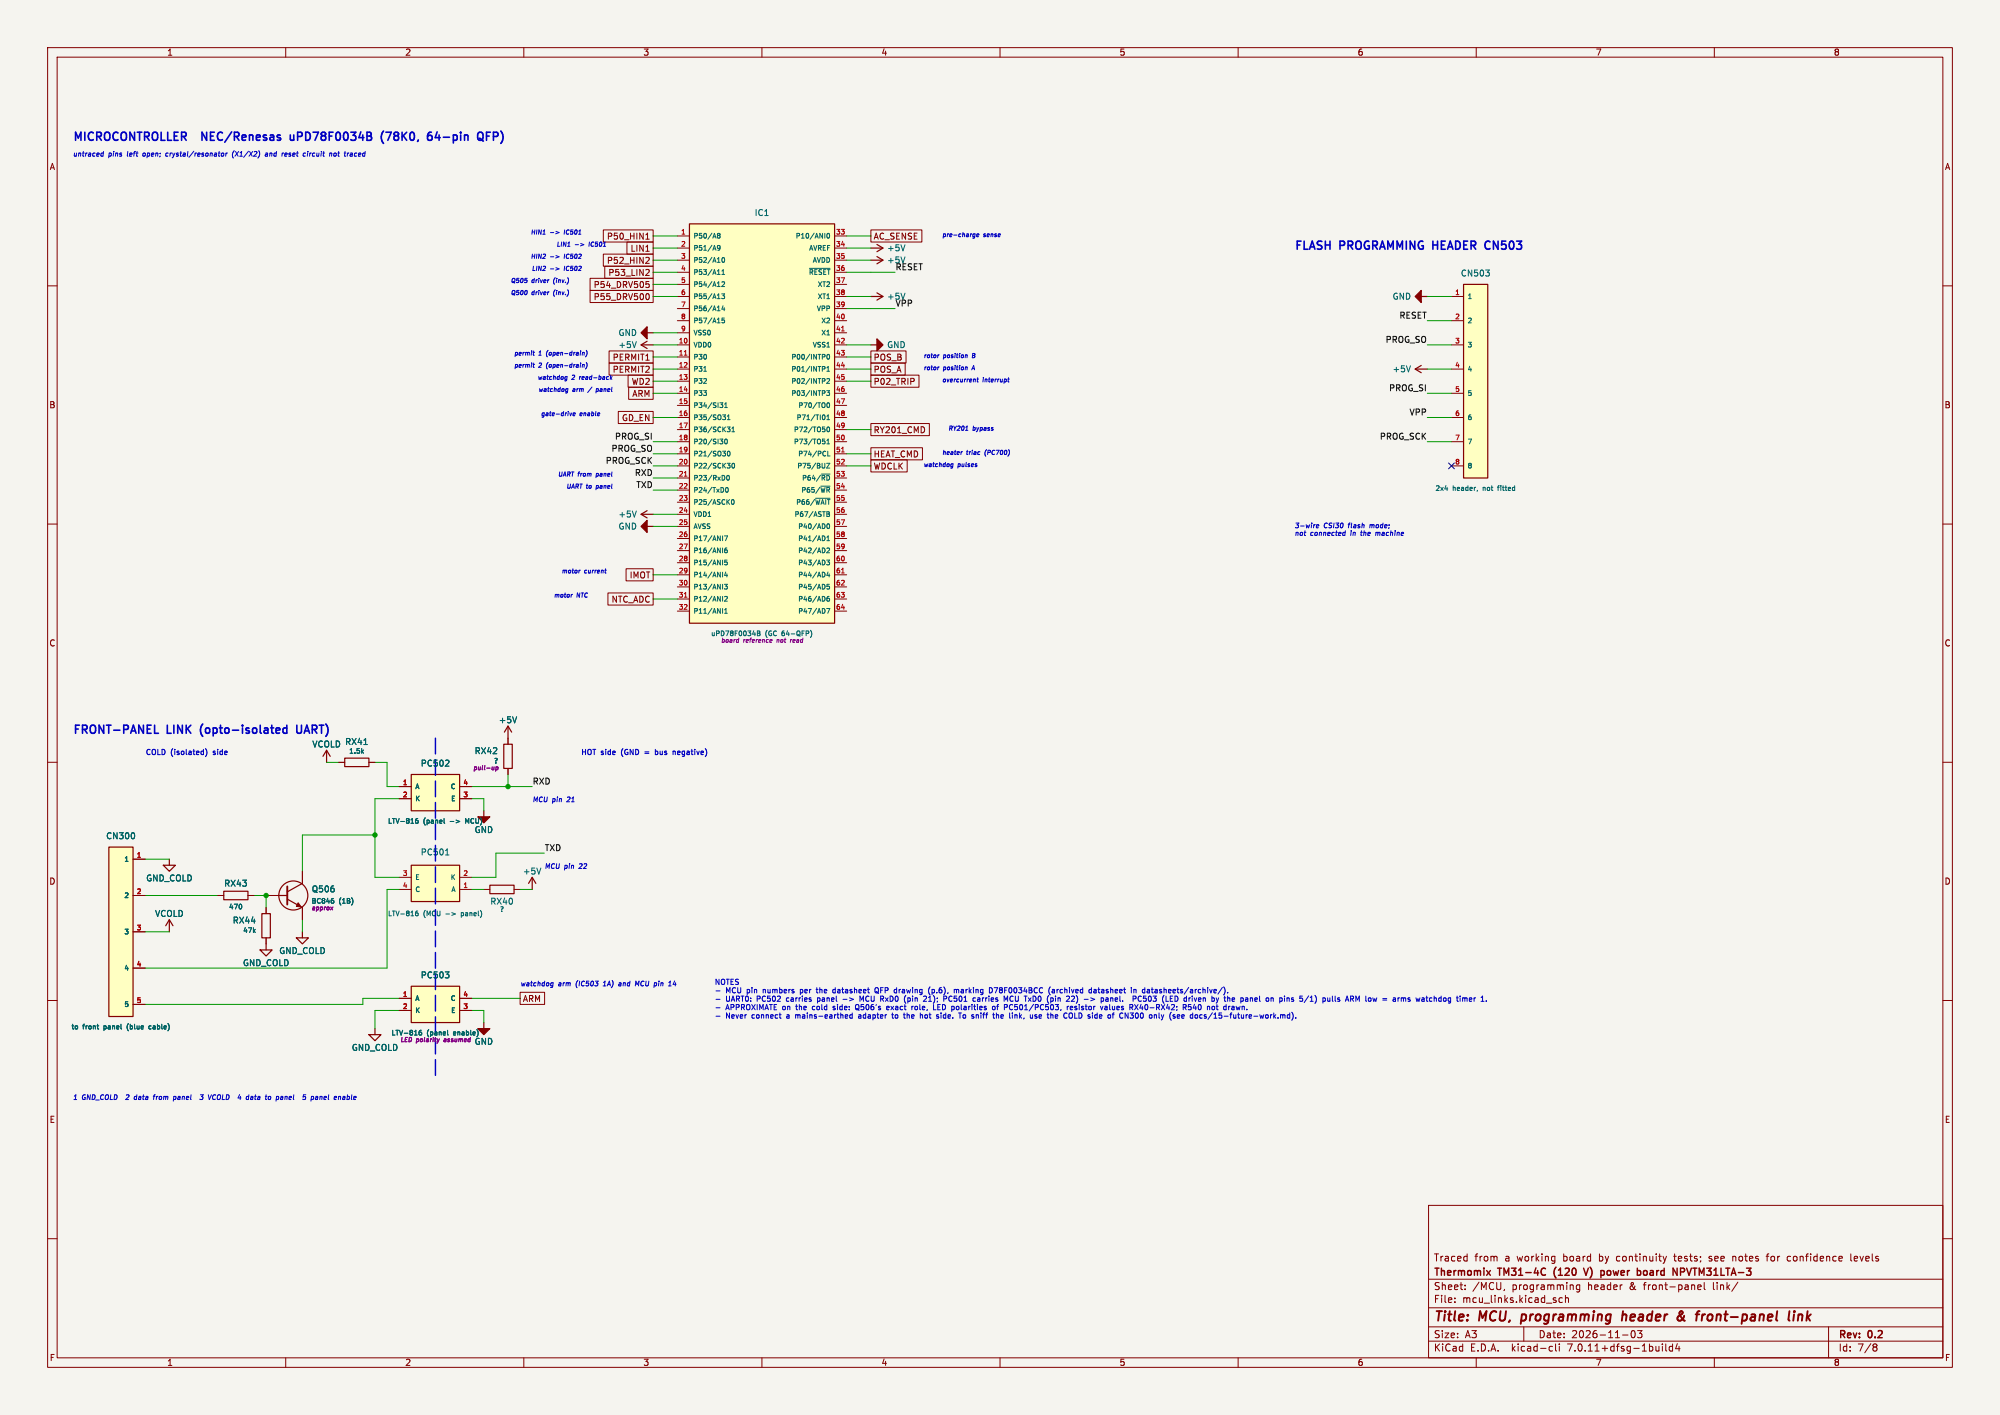
[picture p30: page 7]

RY201 bypass heater triac (PC700) Q500 driver (inv.) RX41

MCU pin 21 HOT side (GND = bus negative)

to front panel (blue cable) 1

to front panel (blue cable) GND_COLD

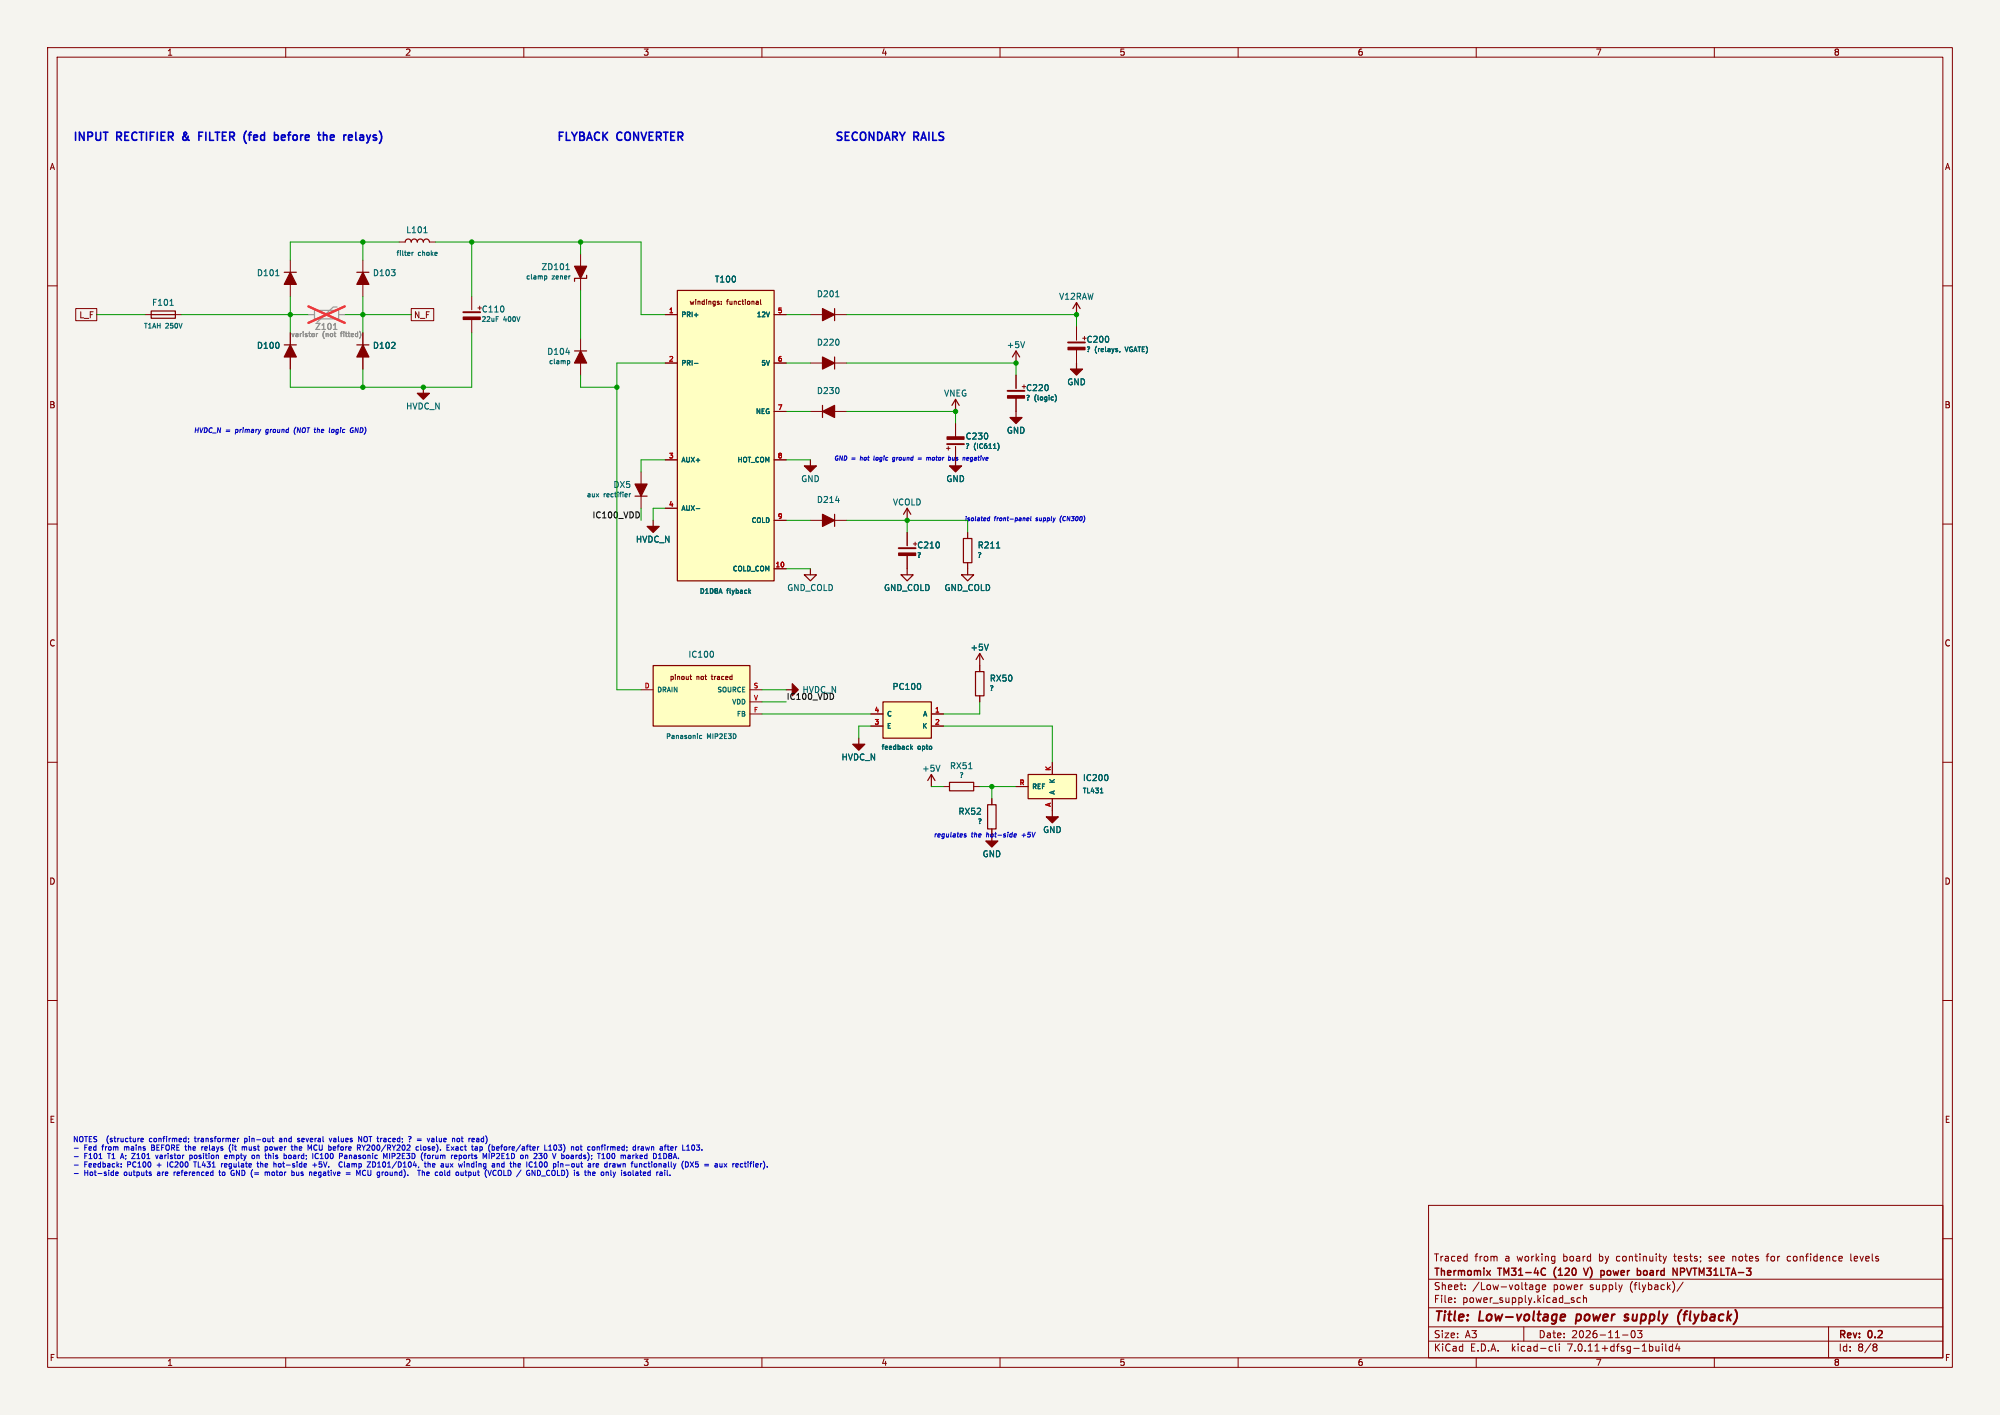
[picture p31: page 8]

HVDC_N = primary ground (NOT the logic GND)

GND = hot logic ground = motor bus negative

pinout not traced DRAIN D
