junado/thermomix-tm31-power-board/hardware/kicad/analog_sense.kicad_sch

## KiCad design hardware/kicad/analog_sense.kicad_sch (2026-11-04)

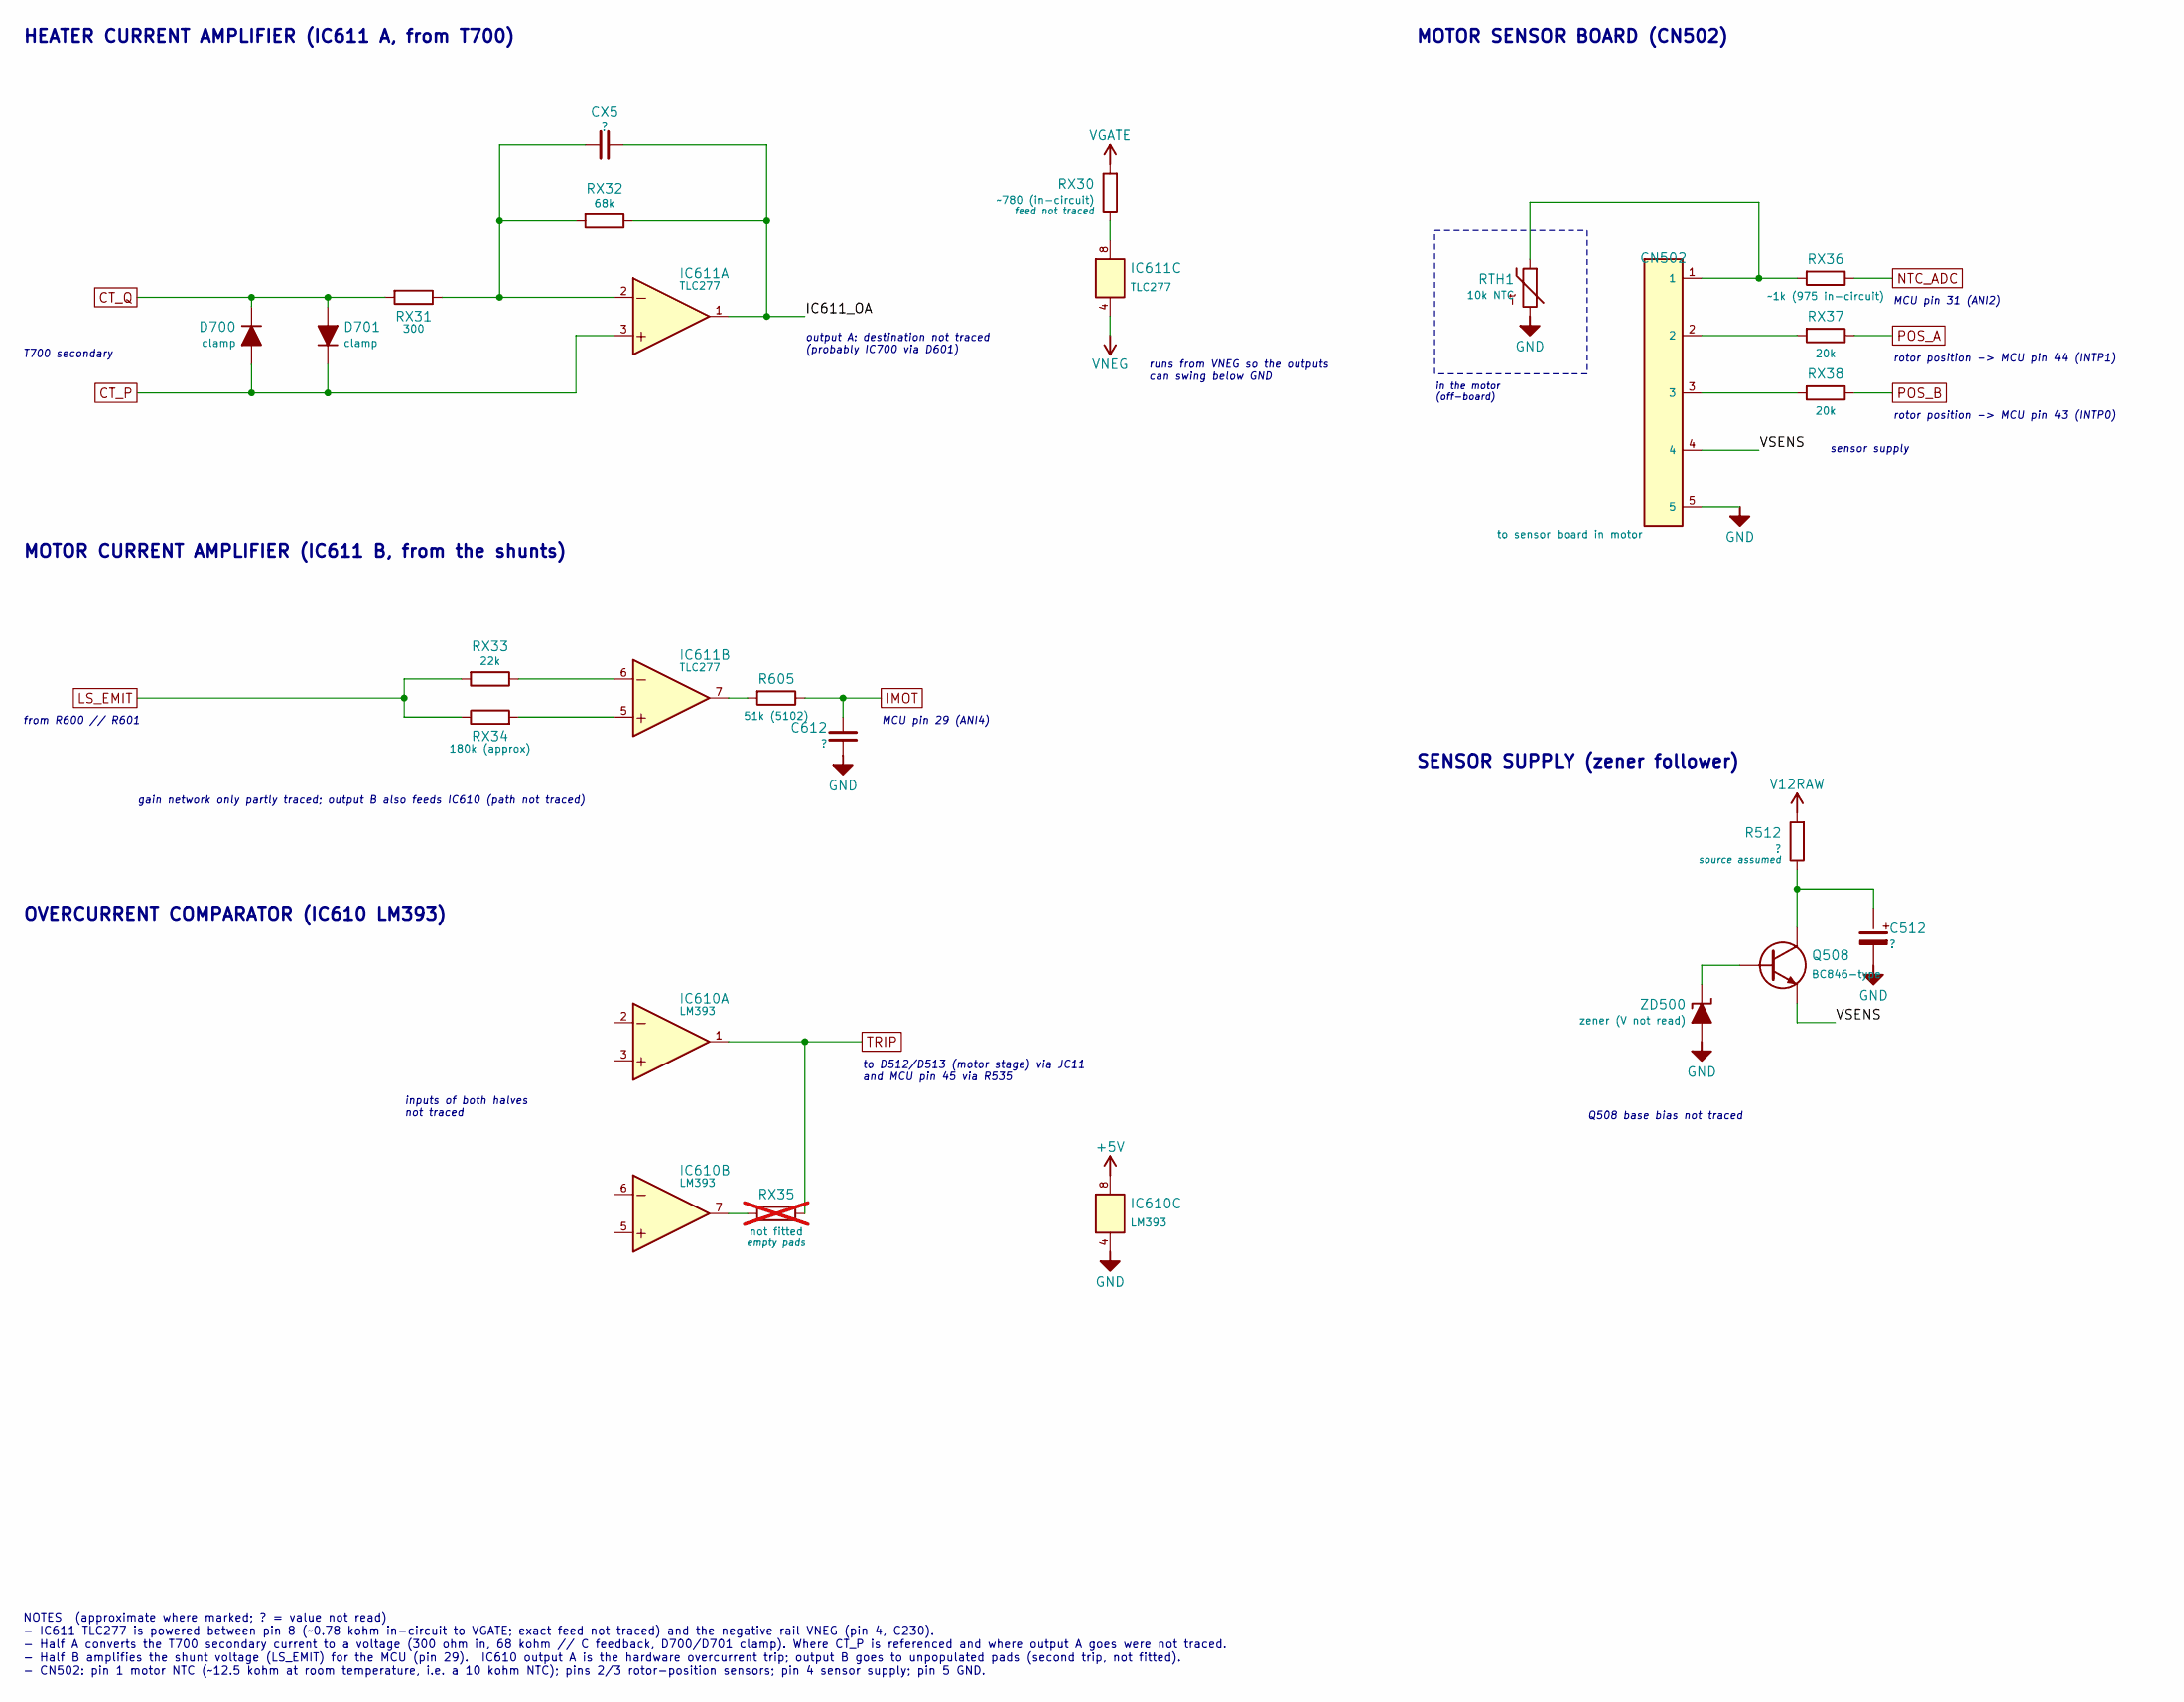
[picture p32: schematic analog_sense.kicad_sch]

Parts:
C512, C612: ?
CN502: to sensor board in motor
CX5: ?
D700, D701: clamp
IC610: LM393
IC611: TLC277
Q508: BC846-type
R512: ?
R605: 51k (5102)
RTH1: 10k NTC
RX30: ~780 (in-circuit)
RX31: 300
RX32: 68k
RX33: 22k
RX34: 180k (approx)
RX35: not fitted; not fitted
RX36: ~1k (975 in-circuit)
RX37, RX38: 20k
ZD500: zener (V not read)

Connections:
+5V: IC610.8 (V+)
CT_P: D700.2 (A), D701.1 (K), IC611.3 (+)
CT_Q: D700.1 (K), D701.2 (A), RX31.1
GND: C512.2 (-), C612.2, CN502.5, IC610.4 (V-), RTH1.2, ZD500.2 (A)
IC611_OA: CX5.2, IC611.1, RX32.2
IMOT: C612.1, R605.2
LS_EMIT: RX33.1, RX34.2
NTC_ADC: RX36.2
unnamed: C512.1 (+), Q508.3 (C), R512.2
unnamed: CN502.1, RTH1.1, RX36.1
unnamed: CN502.2, RX37.1
unnamed: CN502.3, RX38.1
unnamed: CX5.1, IC611.2 (-), RX31.2, RX32.1
unnamed: IC610.7, RX35.1
unnamed: IC611.5 (+), RX34.1
unnamed: IC611.6 (-), RX33.2
unnamed: IC611.7, R605.1
unnamed: IC611.8 (V+), RX30.2
unnamed: Q508.1 (B), ZD500.1 (K)
POS_A: RX37.2
POS_B: RX38.2
TRIP: IC610.1, RX35.2
V12RAW: R512.1
VGATE: RX30.1
VNEG: IC611.4 (V-)
VSENS: CN502.4, Q508.2 (E)

Notes on the sheet:
HEATER CURRENT AMPLIFIER (IC611 A, from T700)
T700 secondary
output A: destination not traced (probably IC700 via D601)
runs from VNEG so the outputs can swing below GND
MOTOR CURRENT AMPLIFIER (IC611 B, from the shunts)
from R600 // R601
MCU pin 29 (ANI4)
gain network only partly traced; output B also feeds IC610 (path not traced)
OVERCURRENT COMPARATOR (IC610 LM393)
to D512/D513 (motor stage) via JC11 and MCU pin 45 via R535
inputs of both halves not traced
MOTOR SENSOR BOARD (CN502)
MCU pin 31 (ANI2)
in the motor (off-board)
rotor position -> MCU pin 44 (INTP1)
rotor position -> MCU pin 43 (INTP0)
sensor supply
SENSOR SUPPLY (zener follower)
Q508 base bias not traced
NOTES (approximate where marked; ? = value not read) - IC611 TLC277 is powered between pin 8 (~0.78 kohm in-circuit to VGATE; exact feed not traced) and the negative rail VNEG (pin 4, C230). - Half A converts the T700 secondary current to a voltage (300 ohm in, 68 kohm // C feedback, D700/D701 clam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
