junado/thermomix-tm31-power-board/hardware/kicad/mains_heater.kicad_sch

## KiCad design hardware/kicad/mains_heater.kicad_sch (2026-11-04)

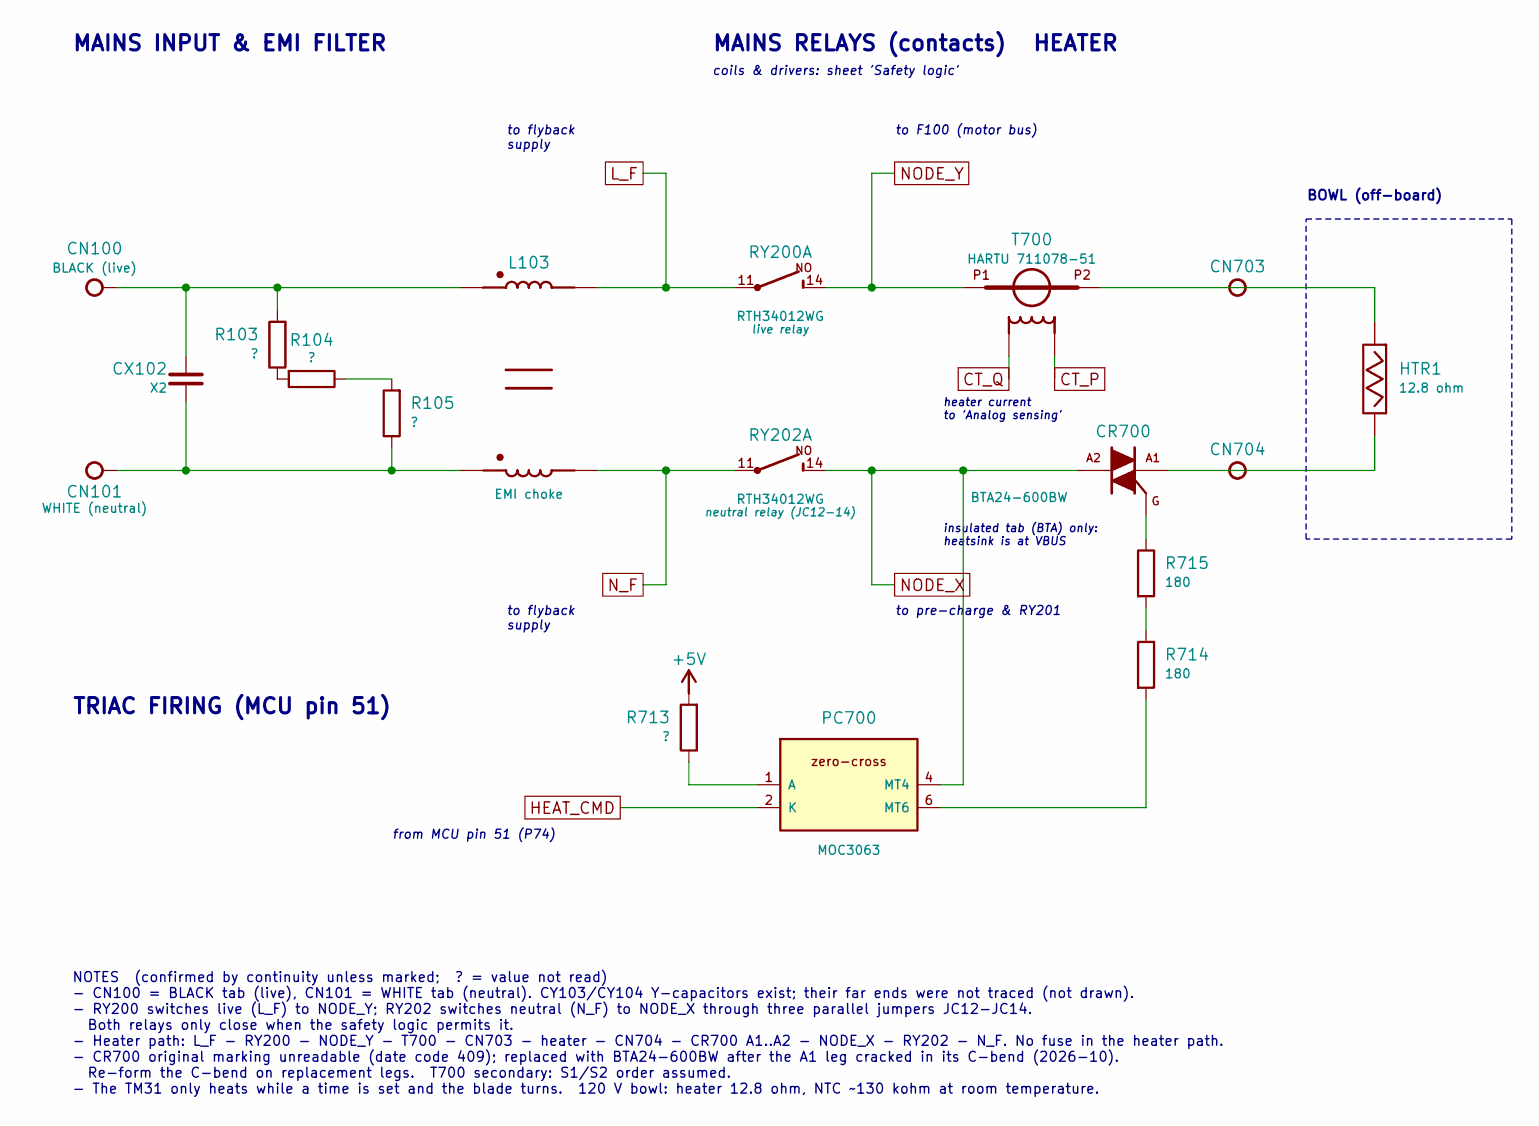
[picture p33: schematic mains_heater.kicad_sch]

Parts:
CN100: BLACK (live)
CN101: WHITE (neutral)
CN703, CN704: (no value)
CR700: BTA24-600BW
CX102: X2
HTR1: 12.8 ohm
L103: EMI choke
PC700: MOC3063
R103, R104, R105, R713: ?
R714, R715: 180
RY200, RY202: RTH34012WG
T700: HARTU 711078-51

Connections:
+5V: R713.1
CT_P: T700.4 (S2)
CT_Q: T700.3 (S1)
HEAT_CMD: PC700.2 (K)
L_F: L103.2 (L_OUT), RY200.11 (COM)
NODE_X: CR700.2 (A2), PC700.4 (MT4), RY202.14 (NO)
NODE_Y: RY200.14 (NO), T700.1
N_F: L103.4 (N_OUT), RY202.11 (COM)
unnamed: CN100.1, CX102.1, L103.1 (L_IN), R103.1
unnamed: CN101.1, CX102.2, L103.3 (N_IN), R105.2
unnamed: CN703.1, HTR1.1, T700.2
unnamed: CN704.1, CR700.1 (A1), HTR1.2
unnamed: CR700.3 (G), R715.2
unnamed: PC700.1 (A), R713.2
unnamed: PC700.6 (MT6), R714.1
unnamed: R103.2, R104.1
unnamed: R104.2, R105.1
unnamed: R714.2, R715.1

Notes on the sheet:
MAINS INPUT & EMI FILTER
MAINS RELAYS (contacts)
coils & drivers: sheet 'Safety logic'
HEATER
to flyback supply
to F100 (motor bus)
heater current to 'Analog sensing'
BOWL (off-board)
insulated tab (BTA) only: heatsink is at VBUS
to pre-charge & RY201
TRIAC FIRING (MCU pin 51)
from MCU pin 51 (P74)
NOTES (confirmed by continuity unless marked; ? = value not read) - CN100 = BLACK tab (live), CN101 = WHITE tab (neutral). CY103/CY104 Y-capacitors exist; their far ends were not traced (not drawn). - RY200 switches live (L_F) to NODE_Y; RY202 switches neutral (N_F) to NODE_X through three parallel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
