junado/thermomix-tm31-power-board/hardware/kicad/mcu_links.kicad_sch

## KiCad design hardware/kicad/mcu_links.kicad_sch (2026-11-04)

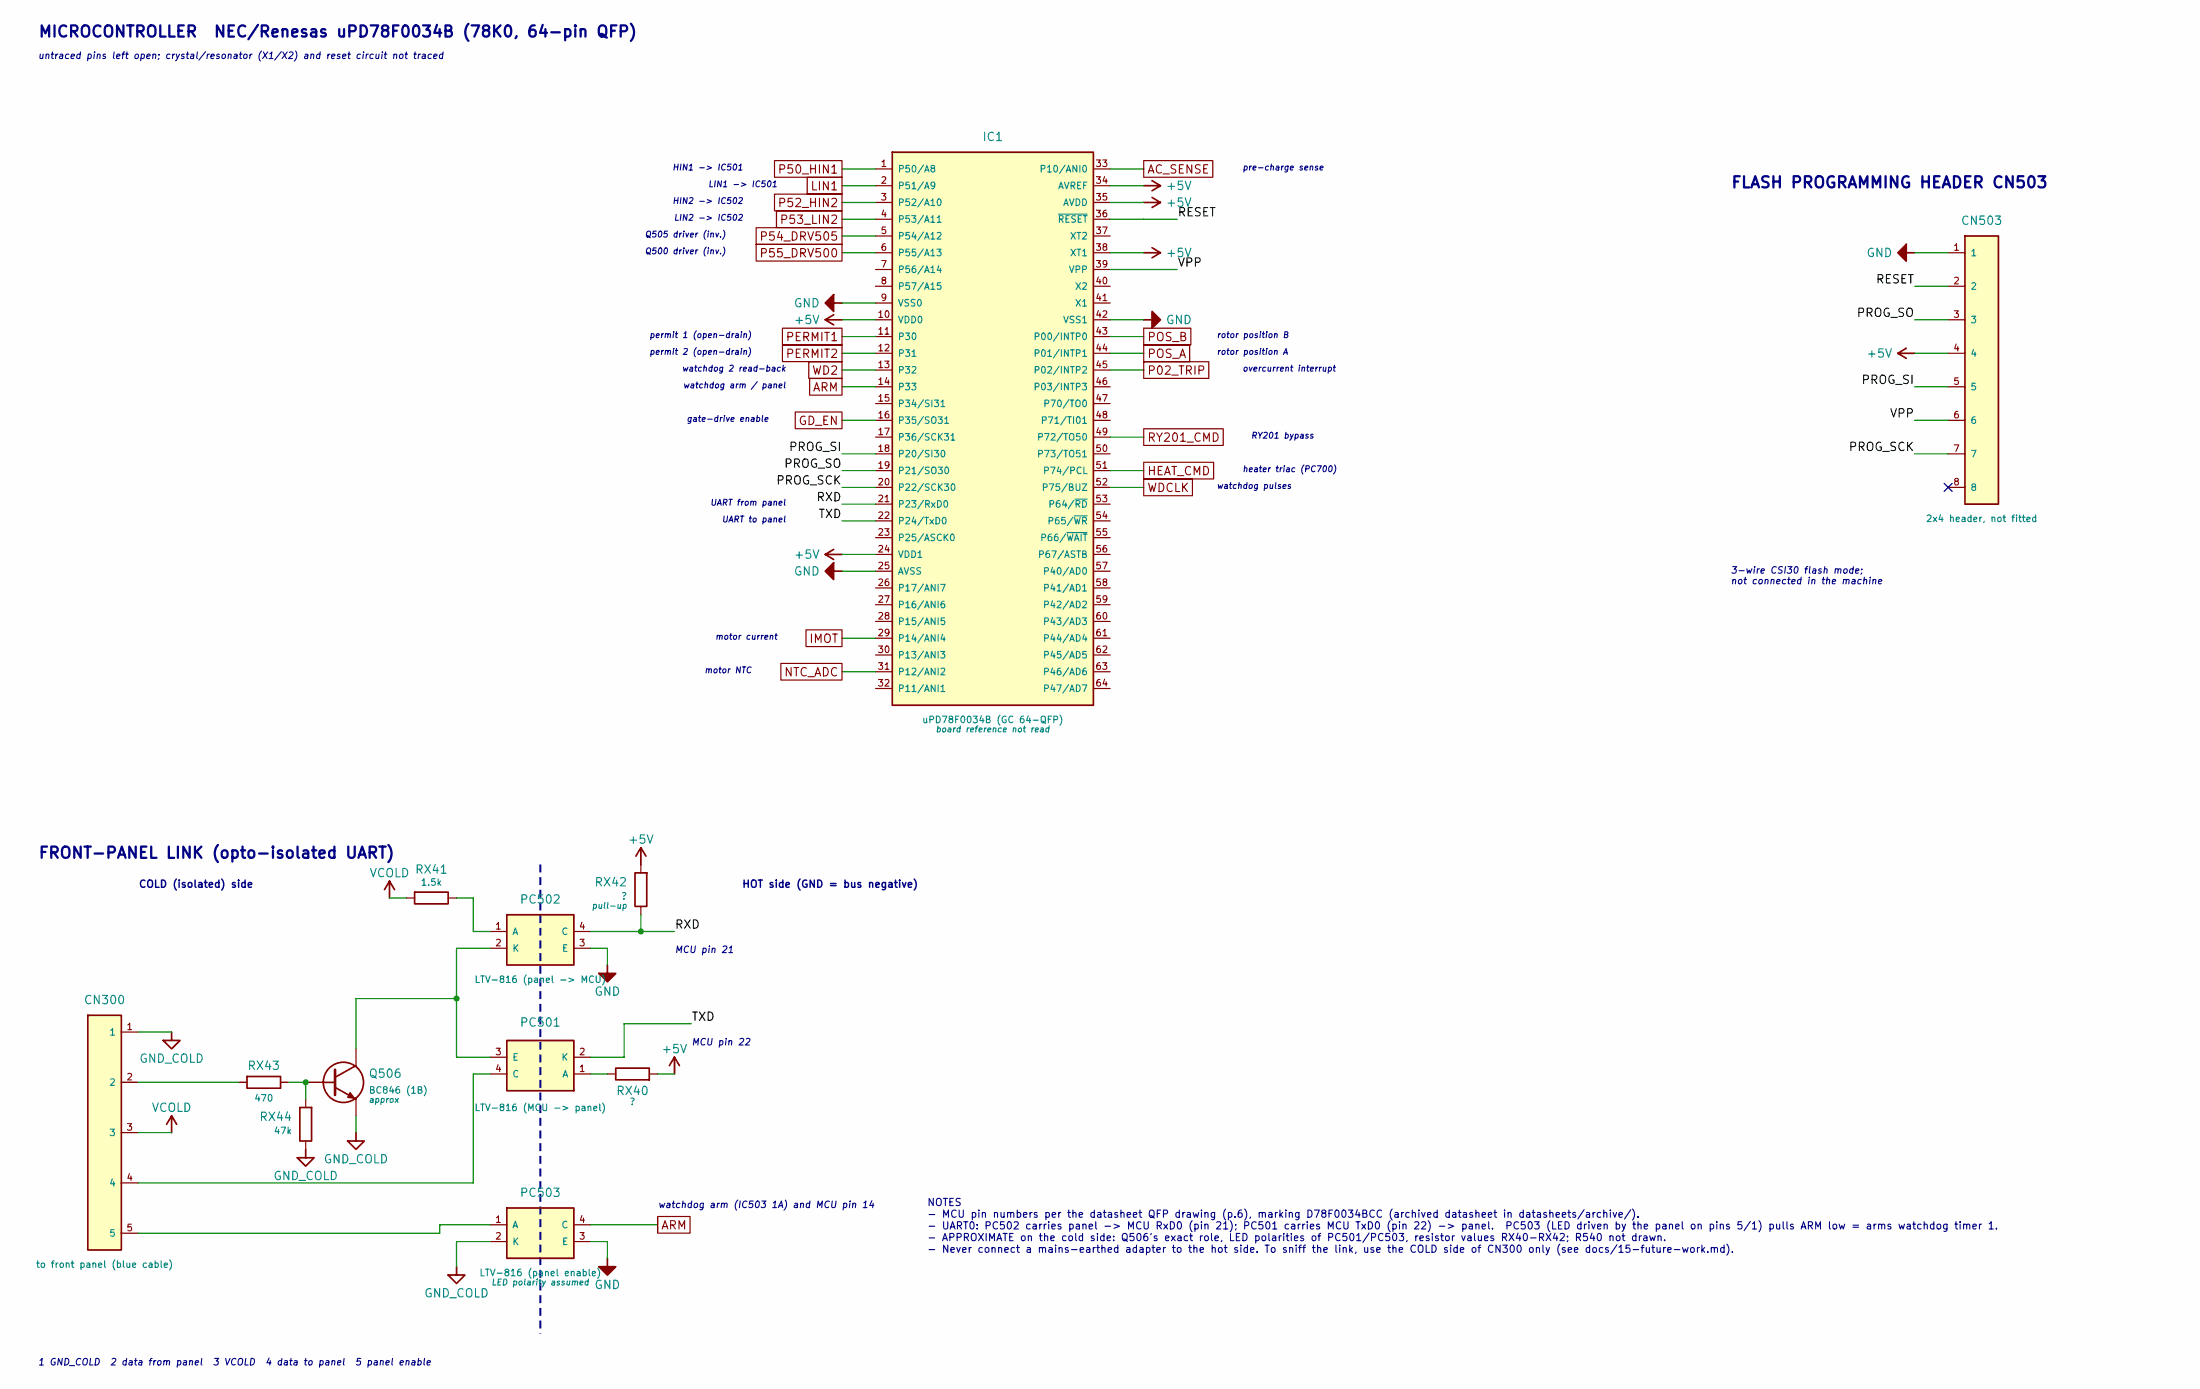
[picture p34: schematic mcu_links.kicad_sch]

Parts:
CN300: to front panel (blue cable)
CN503: 2x4 header, not fitted
IC1: uPD78F0034B (GC 64-QFP)
PC501: LTV-816 (MCU -> panel)
PC502: LTV-816 (panel -> MCU)
PC503: LTV-816 (panel enable)
Q506: BC846 (1B)
RX40, RX42: ?
RX41: 1.5k
RX43: 470
RX44: 47k

Connections:
+5V: CN503.4, IC1.10 (VDD0), IC1.24 (VDD1), IC1.34 (AVREF), IC1.35 (AVDD), IC1.38 (XT1), RX40.1, RX42.1
AC_SENSE: IC1.33 (P10/ANI0)
ARM: IC1.14 (P33), PC503.4 (C)
GD_EN: IC1.16 (P35/SO31)
GND: CN503.1, IC1.9 (VSS0), IC1.25 (AVSS), IC1.42 (VSS1), PC502.3 (E), PC503.3 (E)
GND_COLD: CN300.1, PC503.2 (K), Q506.2 (E), RX44.2
HEAT_CMD: IC1.51 (P74/PCL)
IMOT: IC1.29 (P14/ANI4)
LIN1: IC1.2 (P51/A9)
NTC_ADC: IC1.31 (P12/ANI2)
unnamed: CN300.2, RX43.1
unnamed: CN300.4, PC501.4 (C)
unnamed: CN300.5, PC503.1 (A)
unnamed: PC501.1 (A), RX40.2
unnamed: PC501.3 (E), PC502.2 (K), Q506.3 (C)
unnamed: PC502.1 (A), RX41.2
unnamed: Q506.1 (B), RX43.2, RX44.1
P02_TRIP: IC1.45 (P02/INTP2)
P50_HIN1: IC1.1 (P50/A8)
P52_HIN2: IC1.3 (P52/A10)
P53_LIN2: IC1.4 (P53/A11)
P54_DRV505: IC1.5 (P54/A12)
P55_DRV500: IC1.6 (P55/A13)
PERMIT1: IC1.11 (P30)
PERMIT2: IC1.12 (P31)
POS_A: IC1.44 (P01/INTP1)
POS_B: IC1.43 (P00/INTP0)
PROG_SCK: CN503.7, IC1.20 (P22/SCK30)
PROG_SI: CN503.5, IC1.18 (P20/SI30)
PROG_SO: CN503.3, IC1.19 (P21/SO30)
RESET: CN503.2, IC1.36 (~RESET)
RXD: IC1.21 (P23/RxD0), PC502.4 (C), RX42.2
RY201_CMD: IC1.49 (P72/TO50)
TXD: IC1.22 (P24/TxD0), PC501.2 (K)
VCOLD: CN300.3, RX41.1
VPP: CN503.6, IC1.39 (VPP)
WD2: IC1.13 (P32)
WDCLK: IC1.52 (P75/BUZ)

Notes on the sheet:
MICROCONTROLLER NEC/Renesas uPD78F0034B (78K0, 64-pin QFP)
HIN1 -> IC501
LIN1 -> IC501
HIN2 -> IC502
LIN2 -> IC502
Q505 driver (inv.)
Q500 driver (inv.)
permit 1 (open-drain)
permit 2 (open-drain)
watchdog 2 read-back
watchdog arm / panel
gate-drive enable
UART from panel
UART to panel
motor current
motor NTC
pre-charge sense
rotor position B
rotor position A
overcurrent interrupt
RY201 bypass
heater triac (PC700)
watchdog pulses
untraced pins left open; crystal/resonator (X1/X2) and reset circuit not traced
FLASH PROGRAMMING HEADER CN503
3-wire CSI30 flash mode; not connected in the machine
FRONT-PANEL LINK (opto-isolated UART)
COLD (isolated) side
HOT side (GND = bus negative)
1 GND_COLD 2 data from panel 3 VCOLD 4 data to panel 5 panel enable
MCU pin 21
MCU pin 22
watchdog arm (IC503 1A) and MCU pin 14
NOTES - MCU pin numbers per the datasheet QFP drawing (p.6), marking D78F0034BCC (archived datasheet in datasheets/archive/). - UART0: PC502 carries panel -> MCU RxD0 (pin 21); PC501 carries MCU TxD0 (pin 22) -> panel. PC503 (LED driven by the panel on pins 5/1) pulls ARM low = arms watchdog timer 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
