junado/thermomix-tm31-power-board/hardware/kicad/motor_bus.kicad_sch

## KiCad design hardware/kicad/motor_bus.kicad_sch (2026-11-04)

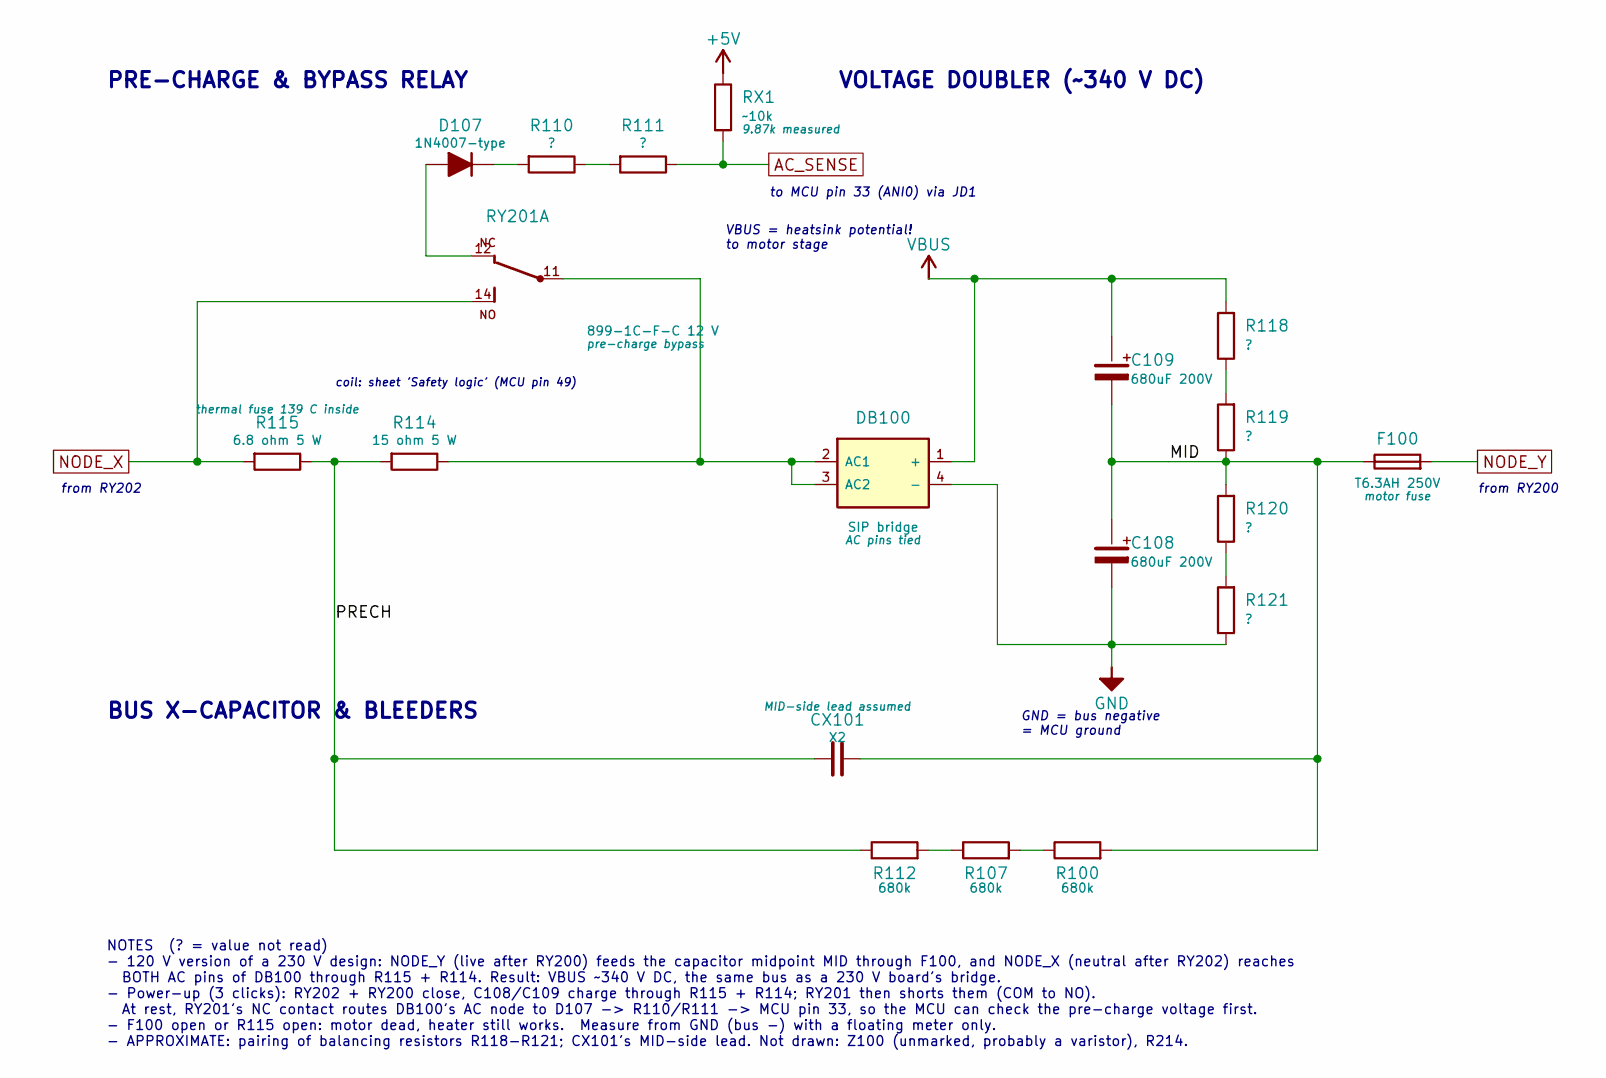
[picture p35: schematic motor_bus.kicad_sch]

Parts:
C108, C109: 680uF 200V
CX101: X2
D107: 1N4007-type
DB100: SIP bridge
F100: T6.3AH 250V
R100, R107, R112: 680k
R110, R111, R118, R119, R120, R121: ?
R114: 15 ohm 5 W
R115: 6.8 ohm 5 W
RX1: ~10k
RY201: 899-1C-F-C 12 V

Connections:
+5V: RX1.2
AC_SENSE: R111.2, RX1.1
GND: C108.2 (-), DB100.4 (-), R121.2
MID: C108.1 (+), C109.2 (-), CX101.1, F100.2, R100.1, R119.2, R120.1
NODE_X: R115.1, RY201.14 (NO)
NODE_Y: F100.1
unnamed: D107.1 (K), R110.1
unnamed: D107.2 (A), RY201.12 (NC)
unnamed: DB100.2 (AC1), DB100.3 (AC2), R114.2, RY201.11 (COM)
unnamed: R100.2, R107.1
unnamed: R107.2, R112.1
unnamed: R110.2, R111.1
unnamed: R118.2, R119.1
unnamed: R120.2, R121.1
PRECH: CX101.2, R112.2, R114.1, R115.2
VBUS: C109.1 (+), DB100.1 (+), R118.1

Notes on the sheet:
PRE-CHARGE & BYPASS RELAY
VOLTAGE DOUBLER (~340 V DC)
from RY202
coil: sheet 'Safety logic' (MCU pin 49)
to MCU pin 33 (ANI0) via JD1
VBUS = heatsink potential! to motor stage
GND = bus negative = MCU ground
from RY200
BUS X-CAPACITOR & BLEEDERS
NOTES (? = value not read) - 120 V version of a 230 V design: NODE_Y (live after RY200) feeds the capacitor midpoint MID through F100, and NODE_X (neutral after RY202) reaches BOTH AC pins of DB100 through R115 + R114. Result: VBUS ~340 V DC, the same bus as a 230 V board's bridge. - Power-up (3 cl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
