junado/thermomix-tm31-power-board/hardware/kicad/motor_stage.kicad_sch

## KiCad design hardware/kicad/motor_stage.kicad_sch (2026-11-04)

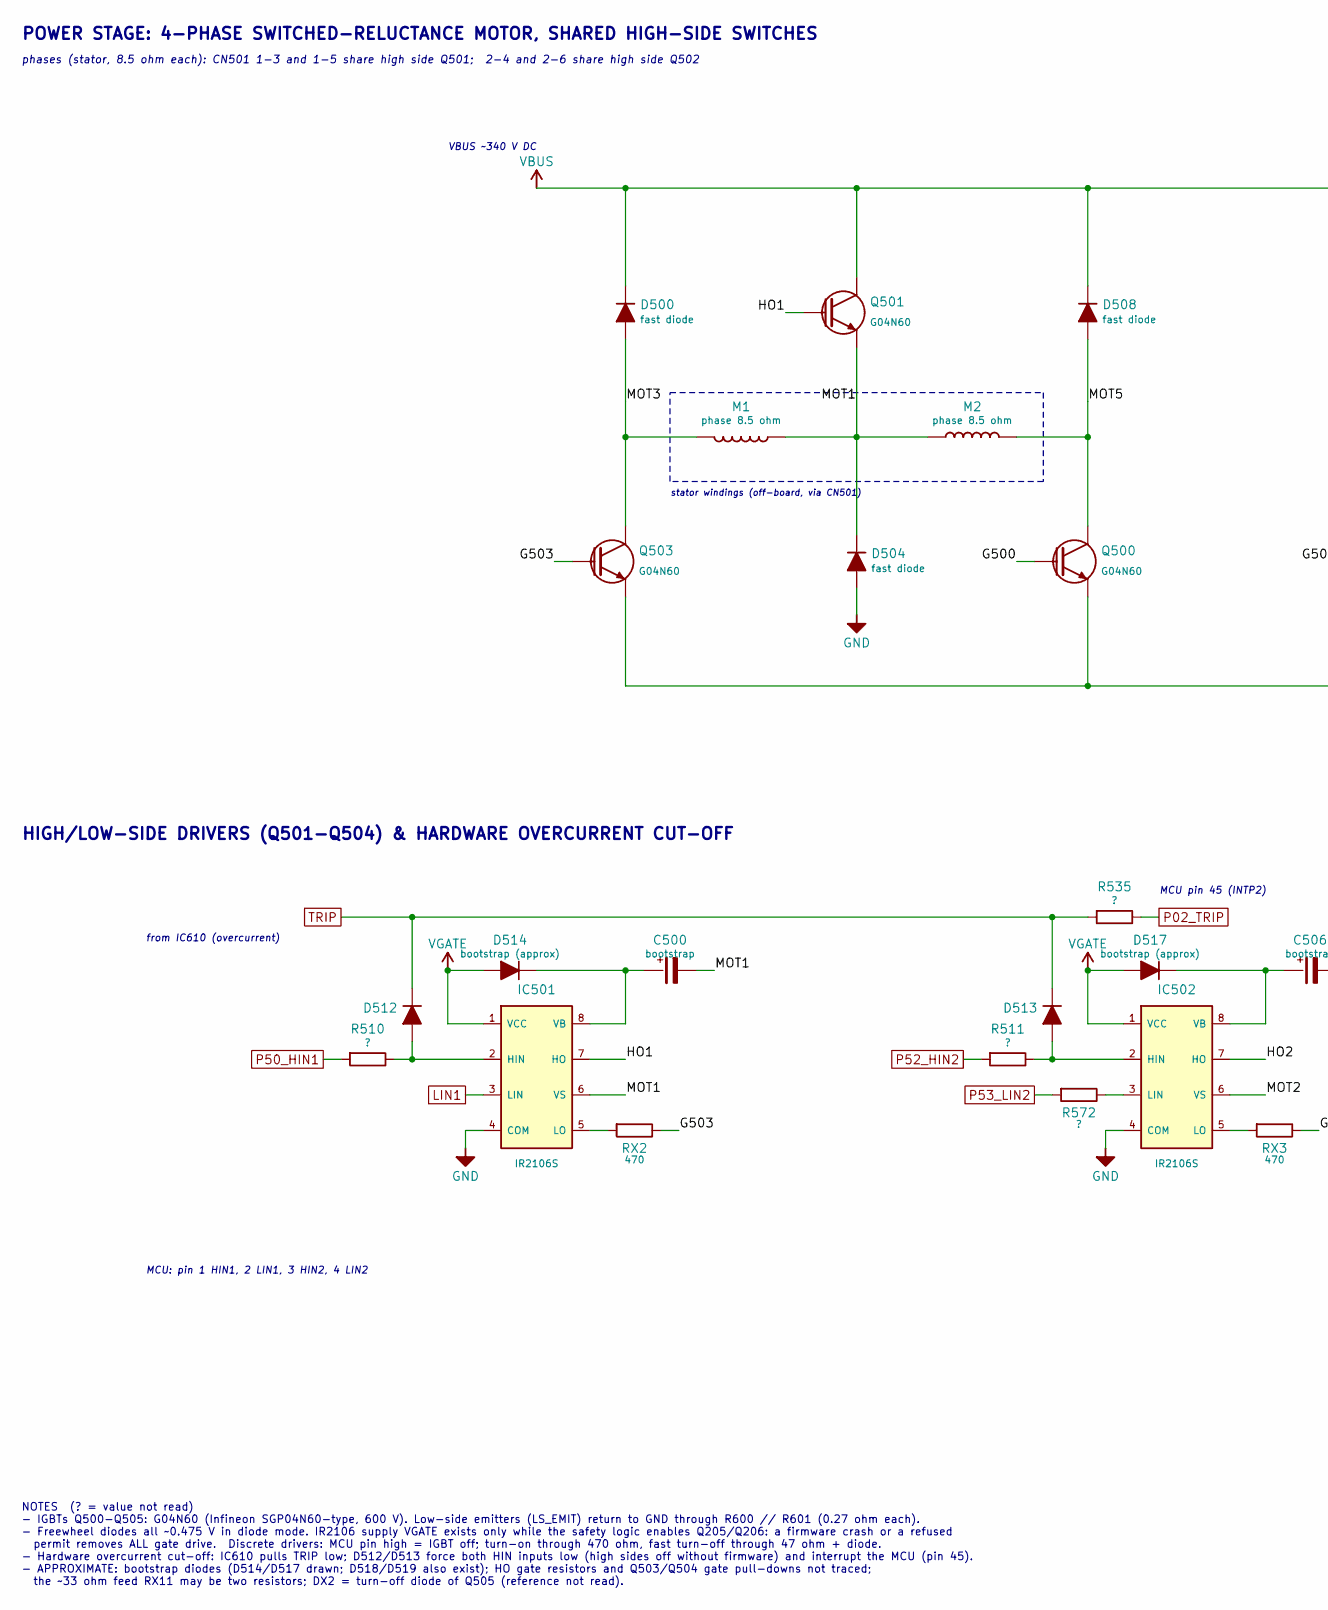
[picture p36: schematic motor_stage.kicad_sch, part in row 1, column 1]

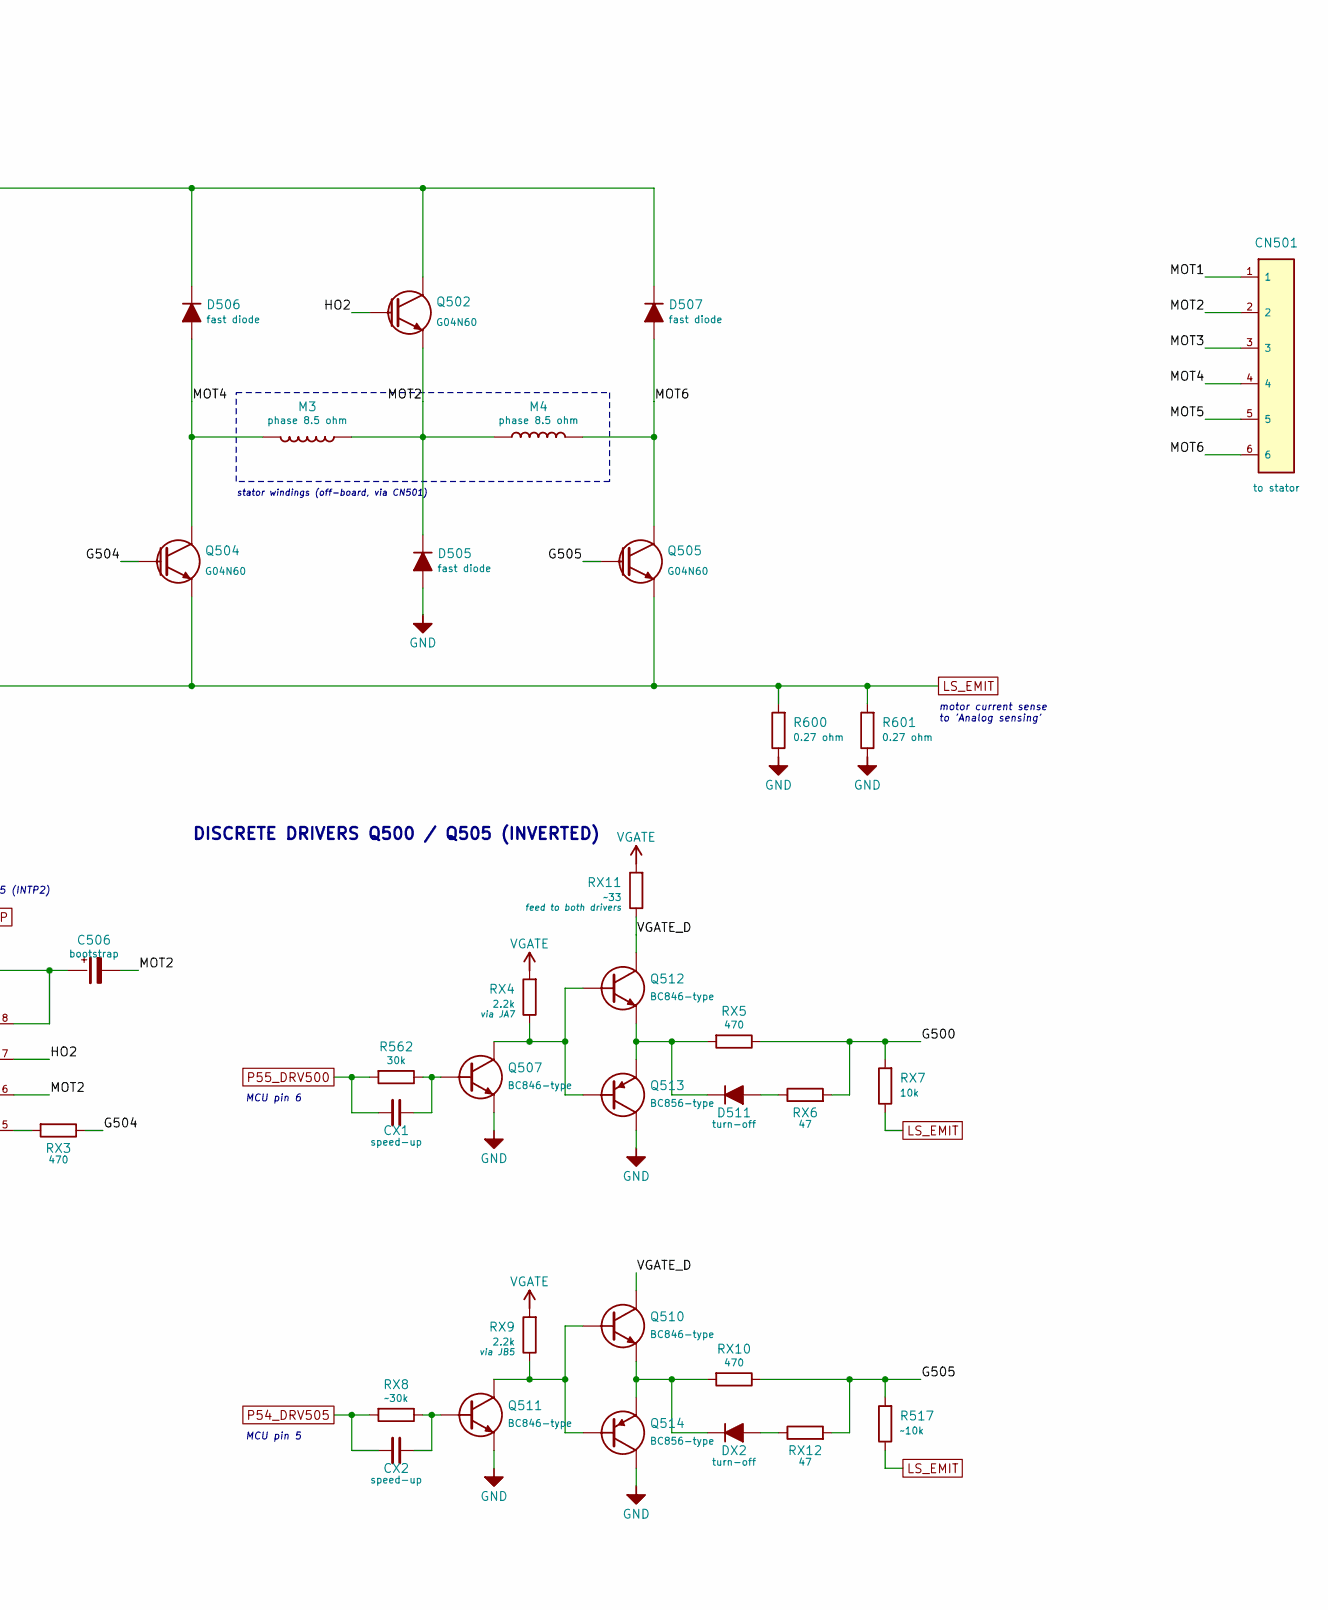
[picture p37: schematic motor_stage.kicad_sch, part in row 1, column 2]

Parts:
C500, C506: bootstrap
CN501: to stator
CX1, CX2: speed-up
D500, D504, D505, D506, D507, D508: fast diode
D511: turn-off
D512, D513: (no value)
D514, D517: bootstrap (approx)
DX2: turn-off
IC501, IC502: IR2106S
M1, M2, M3, M4: phase 8.5 ohm
Q500, Q501, Q502, Q503, Q504, Q505: G04N60
Q507, Q510, Q511, Q512: BC846-type
Q513, Q514: BC856-type
R510, R511, R535, R572: ?
R517: ~10k
R562: 30k
R600, R601: 0.27 ohm
RX2, RX3, RX5, RX10: 470
RX4, RX9: 2.2k
RX6, RX12: 47
RX7: 10k
RX8: ~30k
RX11: ~33

Connections:
G500: Q500.1 (G), RX5.2, RX6.1, RX7.1
G503: Q503.1 (G), RX2.2
G504: Q504.1 (G), RX3.2
G505: Q505.1 (G), R517.1, RX10.2, RX12.1
GND: D504.2 (A), D505.2 (A), IC501.4 (COM), IC502.4 (COM), Q507.2 (E), Q511.2 (E), Q513.3 (C), Q514.3 (C), R600.2, R601.2
HO1: IC501.7 (HO), Q501.1 (G)
HO2: IC502.7 (HO), Q502.1 (G)
LIN1: IC501.3 (LIN)
LS_EMIT: Q500.3 (E), Q503.3 (E), Q504.3 (E), Q505.3 (E), R517.2, R600.1, R601.1, RX7.2
MOT1: C500.2 (-), CN501.1, D504.1 (K), IC501.6 (VS), M1.1, M2.1, Q501.3 (E)
MOT2: C506.2 (-), CN501.2, D505.1 (K), IC502.6 (VS), M3.1, M4.1, Q502.3 (E)
MOT3: CN501.3, D500.2 (A), M1.2, Q503.2 (C)
MOT4: CN501.4, D506.2 (A), M3.2, Q504.2 (C)
MOT5: CN501.5, D508.2 (A), M2.2, Q500.2 (C)
MOT6: CN501.6, D507.2 (A), M4.2, Q505.2 (C)
unnamed: C500.1 (+), D514.1 (K), IC501.8 (VB)
unnamed: C506.1 (+), D517.1 (K), IC502.8 (VB)
unnamed: CX1.2, Q507.1 (B), R562.2
unnamed: CX2.2, Q511.1 (B), RX8.2
unnamed: D511.1 (K), Q512.2 (E), Q513.2 (E), RX5.1
unnamed: D511.2 (A), RX6.2
unnamed: D512.2 (A), IC501.2 (HIN), R510.2
unnamed: D513.2 (A), IC502.2 (HIN), R511.2
unnamed: DX2.1 (K), Q510.2 (E), Q514.2 (E), RX10.1
unnamed: DX2.2 (A), RX12.2
unnamed: IC501.5 (LO), RX2.1
unnamed: IC502.3 (LIN), R572.2
unnamed: IC502.5 (LO), RX3.1
unnamed: Q507.3 (C), Q512.1 (B), Q513.1 (B), RX4.2
unnamed: Q510.1 (B), Q511.3 (C), Q514.1 (B), RX9.2
P02_TRIP: R535.2
P50_HIN1: R510.1
P52_HIN2: R511.1
P53_LIN2: R572.1
P54_DRV505: CX2.1, RX8.1
P55_DRV500: CX1.1, R562.1
TRIP: D512.1 (K), D513.1 (K), R535.1
VBUS: D500.1 (K), D506.1 (K), D507.1 (K), D508.1 (K), Q501.2 (C), Q502.2 (C)
VGATE: D514.2 (A), D517.2 (A), IC501.1 (VCC), IC502.1 (VCC), RX4.1, RX9.1, RX11.1
VGATE_D: Q510.3 (C), Q512.3 (C), RX11.2

Notes on the sheet:
POWER STAGE: 4-PHASE SWITCHED-RELUCTANCE MOTOR, SHARED HIGH-SIDE SWITCHES
phases (stator, 8.5 ohm each): CN501 1-3 and 1-5 share high side Q501; 2-4 and 2-6 share high side Q502
VBUS ~340 V DC
stator windings (off-board, via CN501)
motor current sense to 'Analog sensing'
HIGH/LOW-SIDE DRIVERS (Q501-Q504) & HARDWARE OVERCURRENT CUT-OFF
from IC610 (overcurrent)
MCU pin 45 (INTP2)
MCU: pin 1 HIN1, 2 LIN1, 3 HIN2, 4 LIN2
DISCRETE DRIVERS Q500 / Q505 (INVERTED)
MCU pin 6
MCU pin 5
NOTES (? = value not read) - IGBTs Q500-Q505: G04N60 (Infineon SGP04N60-type, 600 V). Low-side emitters (LS_EMIT) return to GND through R600 // R601 (0.27 ohm each). - Freewheel diodes all ~0.475 V in diode mode. IR2106 supply VGATE exists only while the safety logic enables Q205/Q206: a firmware c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
