junado/thermomix-tm31-power-board/hardware/kicad/power_supply.kicad_sch

## KiCad design hardware/kicad/power_supply.kicad_sch (2026-11-04)

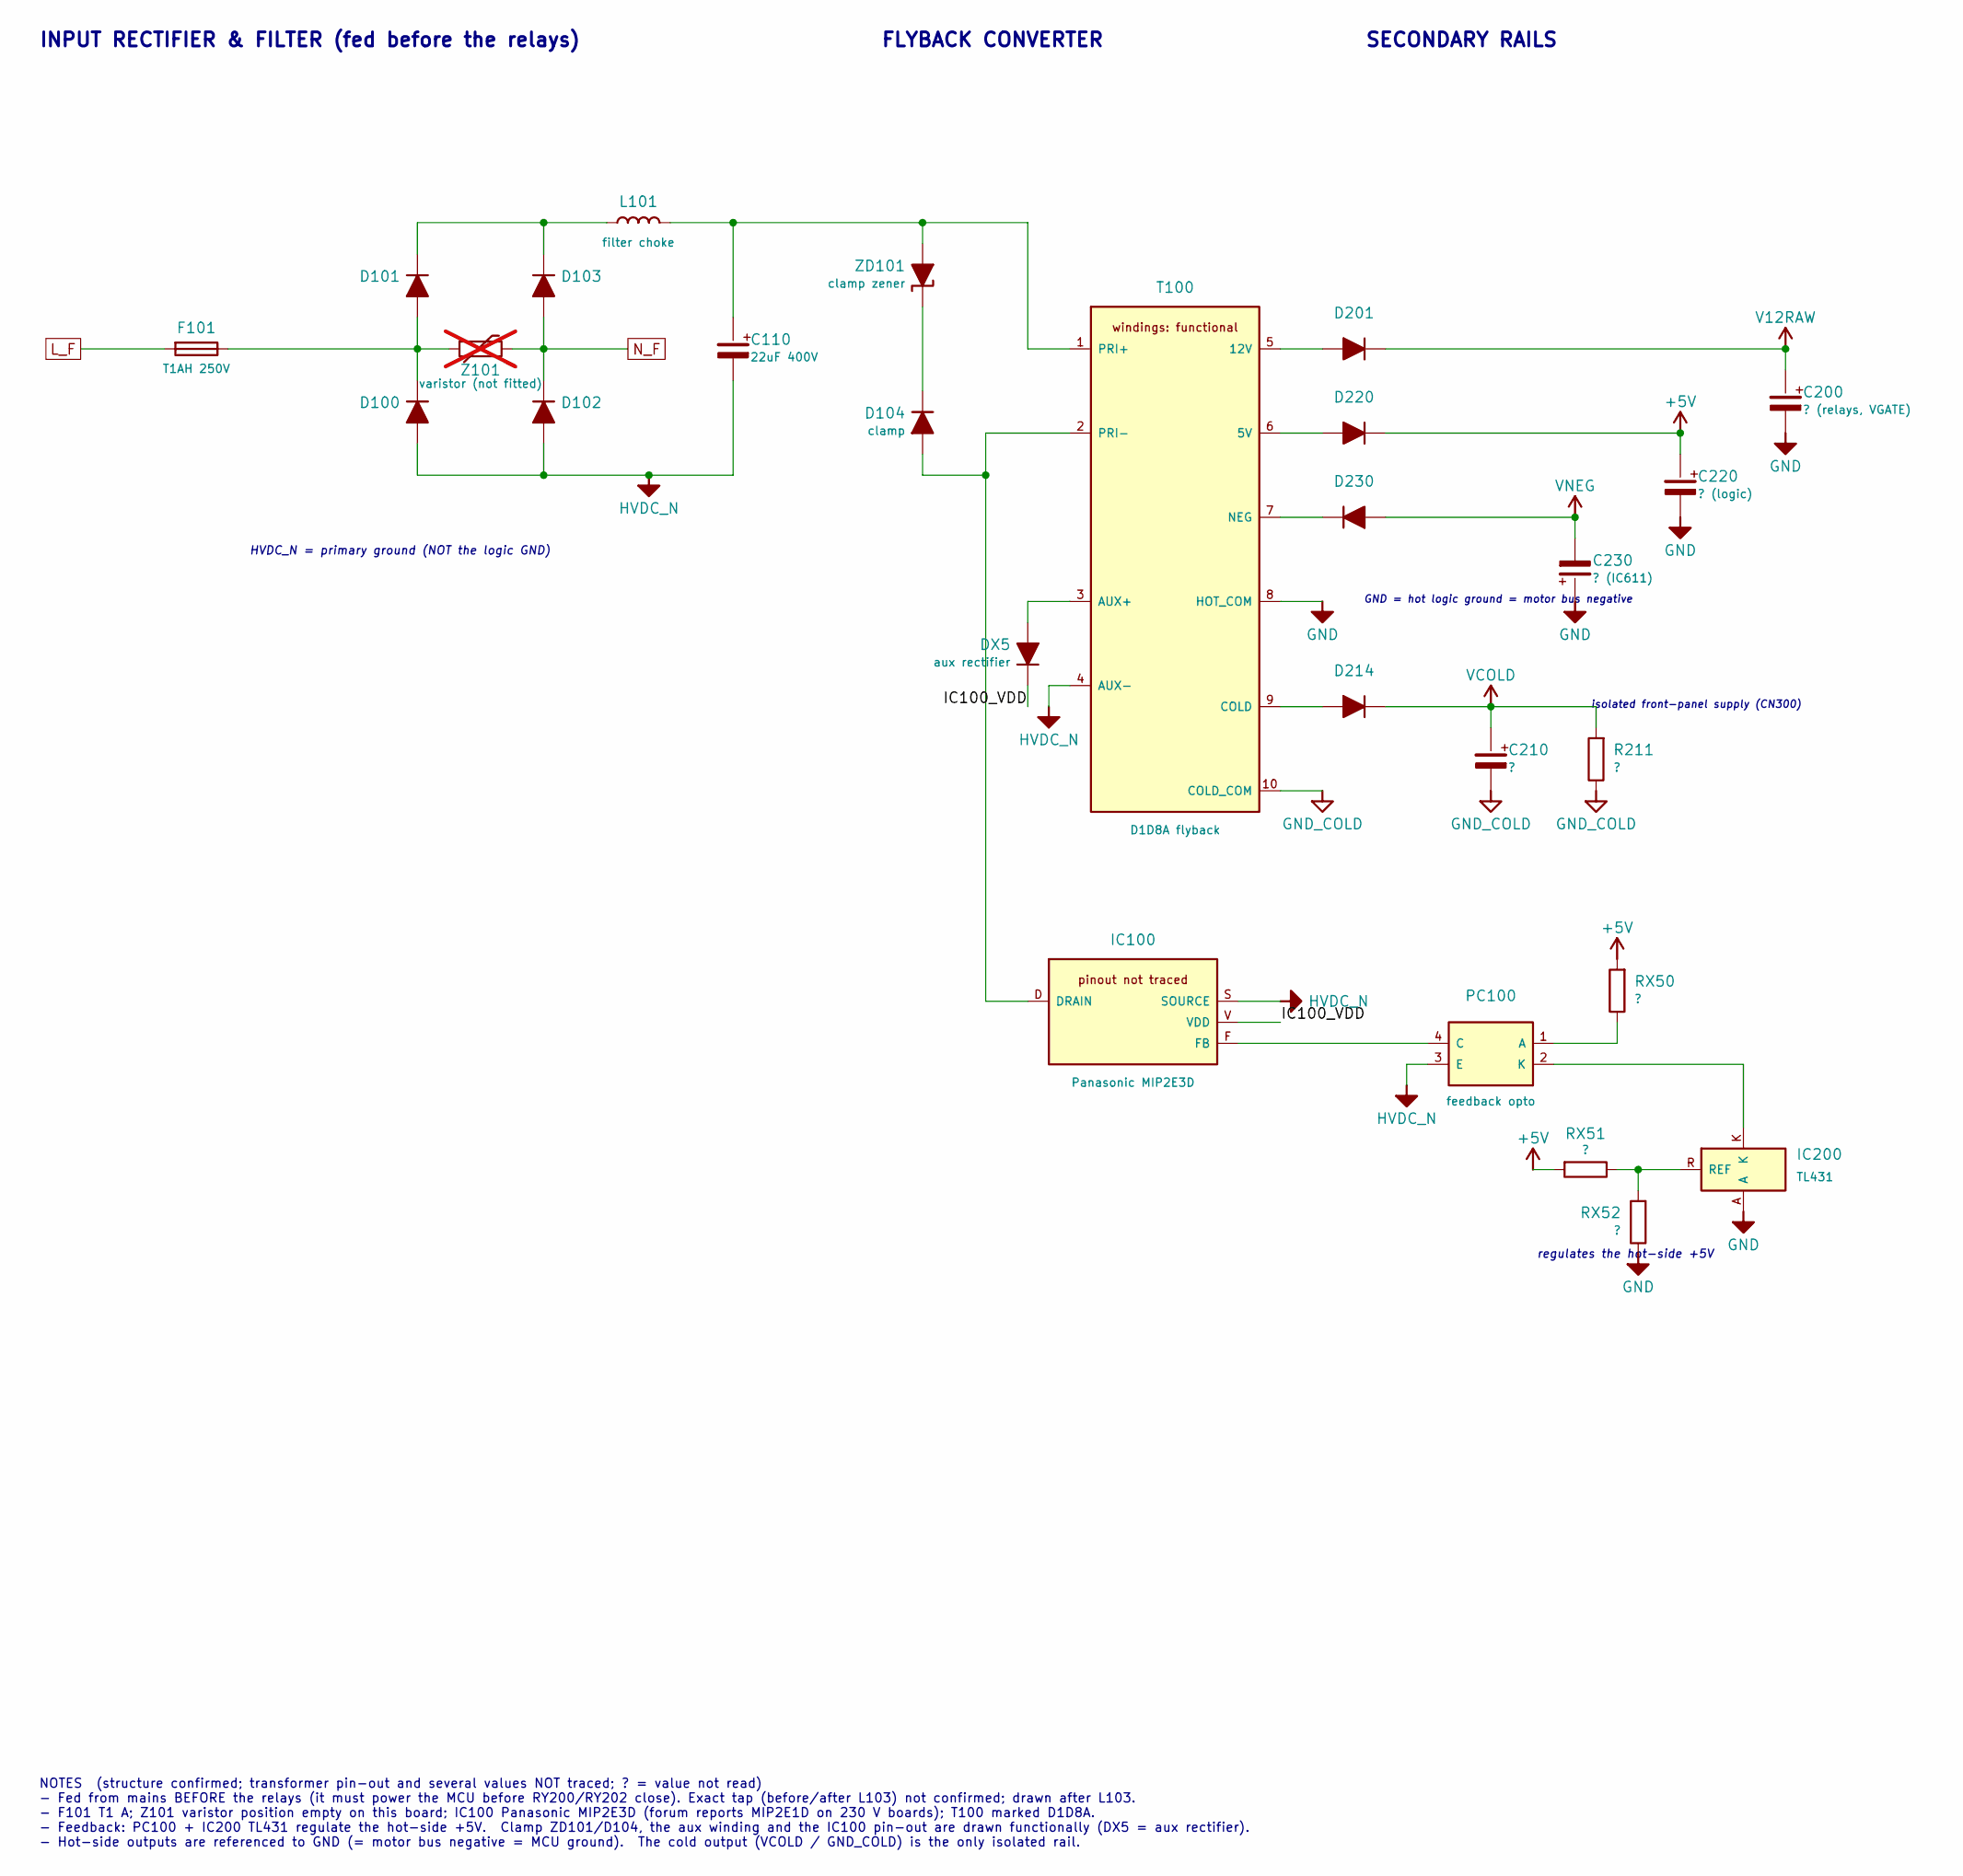
[picture p38: schematic power_supply.kicad_sch]

Parts:
C110: 22uF 400V
C200: ? (relays, VGATE)
C210: ?
C220: ? (logic)
C230: ? (IC611)
D100, D101, D102, D103, D201, D214, D220, D230: (no value)
D104: clamp
DX5: aux rectifier
F101: T1AH 250V
IC100: Panasonic MIP2E3D
IC200: TL431
L101: filter choke
PC100: feedback opto
R211: ?
RX50, RX51, RX52: ?
T100: D1D8A flyback
Z101: varistor (not fitted); not fitted
ZD101: clamp zener

Connections:
+5V: C220.1 (+), D220.1 (K), RX50.1, RX51.1
GND: C200.2 (-), C220.2 (-), C230.1 (+), IC200.A, RX52.2, T100.8 (HOT_COM)
GND_COLD: C210.2 (-), R211.2, T100.10 (COLD_COM)
HVDC_N: C110.2 (-), D100.2 (A), D102.2 (A), IC100.S (SOURCE), PC100.3 (E), T100.4 (AUX-)
IC100_VDD: DX5.1 (K), IC100.V (VDD)
L_F: F101.1
N_F: D102.1 (K), D103.2 (A), Z101.2
unnamed: C110.1 (+), L101.2, T100.1 (PRI+), ZD101.2 (A)
unnamed: D100.1 (K), D101.2 (A), F101.2, Z101.1
unnamed: D101.1 (K), D103.1 (K), L101.1
unnamed: D104.1 (K), ZD101.1 (K)
unnamed: D104.2 (A), IC100.D (DRAIN), T100.2 (PRI-)
unnamed: D201.2 (A), T100.5 (12V)
unnamed: D214.2 (A), T100.9 (COLD)
unnamed: D220.2 (A), T100.6 (5V)
unnamed: D230.1 (K), T100.7 (NEG)
unnamed: DX5.2 (A), T100.3 (AUX+)
unnamed: IC100.F (FB), PC100.4 (C)
unnamed: IC200.K, PC100.2 (K)
unnamed: IC200.R (REF), RX51.2, RX52.1
unnamed: PC100.1 (A), RX50.2
V12RAW: C200.1 (+), D201.1 (K)
VCOLD: C210.1 (+), D214.1 (K), R211.1
VNEG: C230.2 (-), D230.2 (A)

Notes on the sheet:
INPUT RECTIFIER & FILTER (fed before the relays)
HVDC_N = primary ground (NOT the logic GND)
FLYBACK CONVERTER
regulates the hot-side +5V
SECONDARY RAILS
GND = hot logic ground = motor bus negative
isolated front-panel supply (CN300)
NOTES (structure confirmed; transformer pin-out and several values NOT traced; ? = value not read) - Fed from mains BEFORE the relays (it must power the MCU before RY200/RY202 close). Exact tap (before/after L103) not confirmed; drawn after L103. - F101 T1 A; Z101 varistor position empty on this bo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
