junado/thermomix-tm31-power-board/hardware/kicad/safety_logic.kicad_sch

## KiCad design hardware/kicad/safety_logic.kicad_sch (2026-11-04)

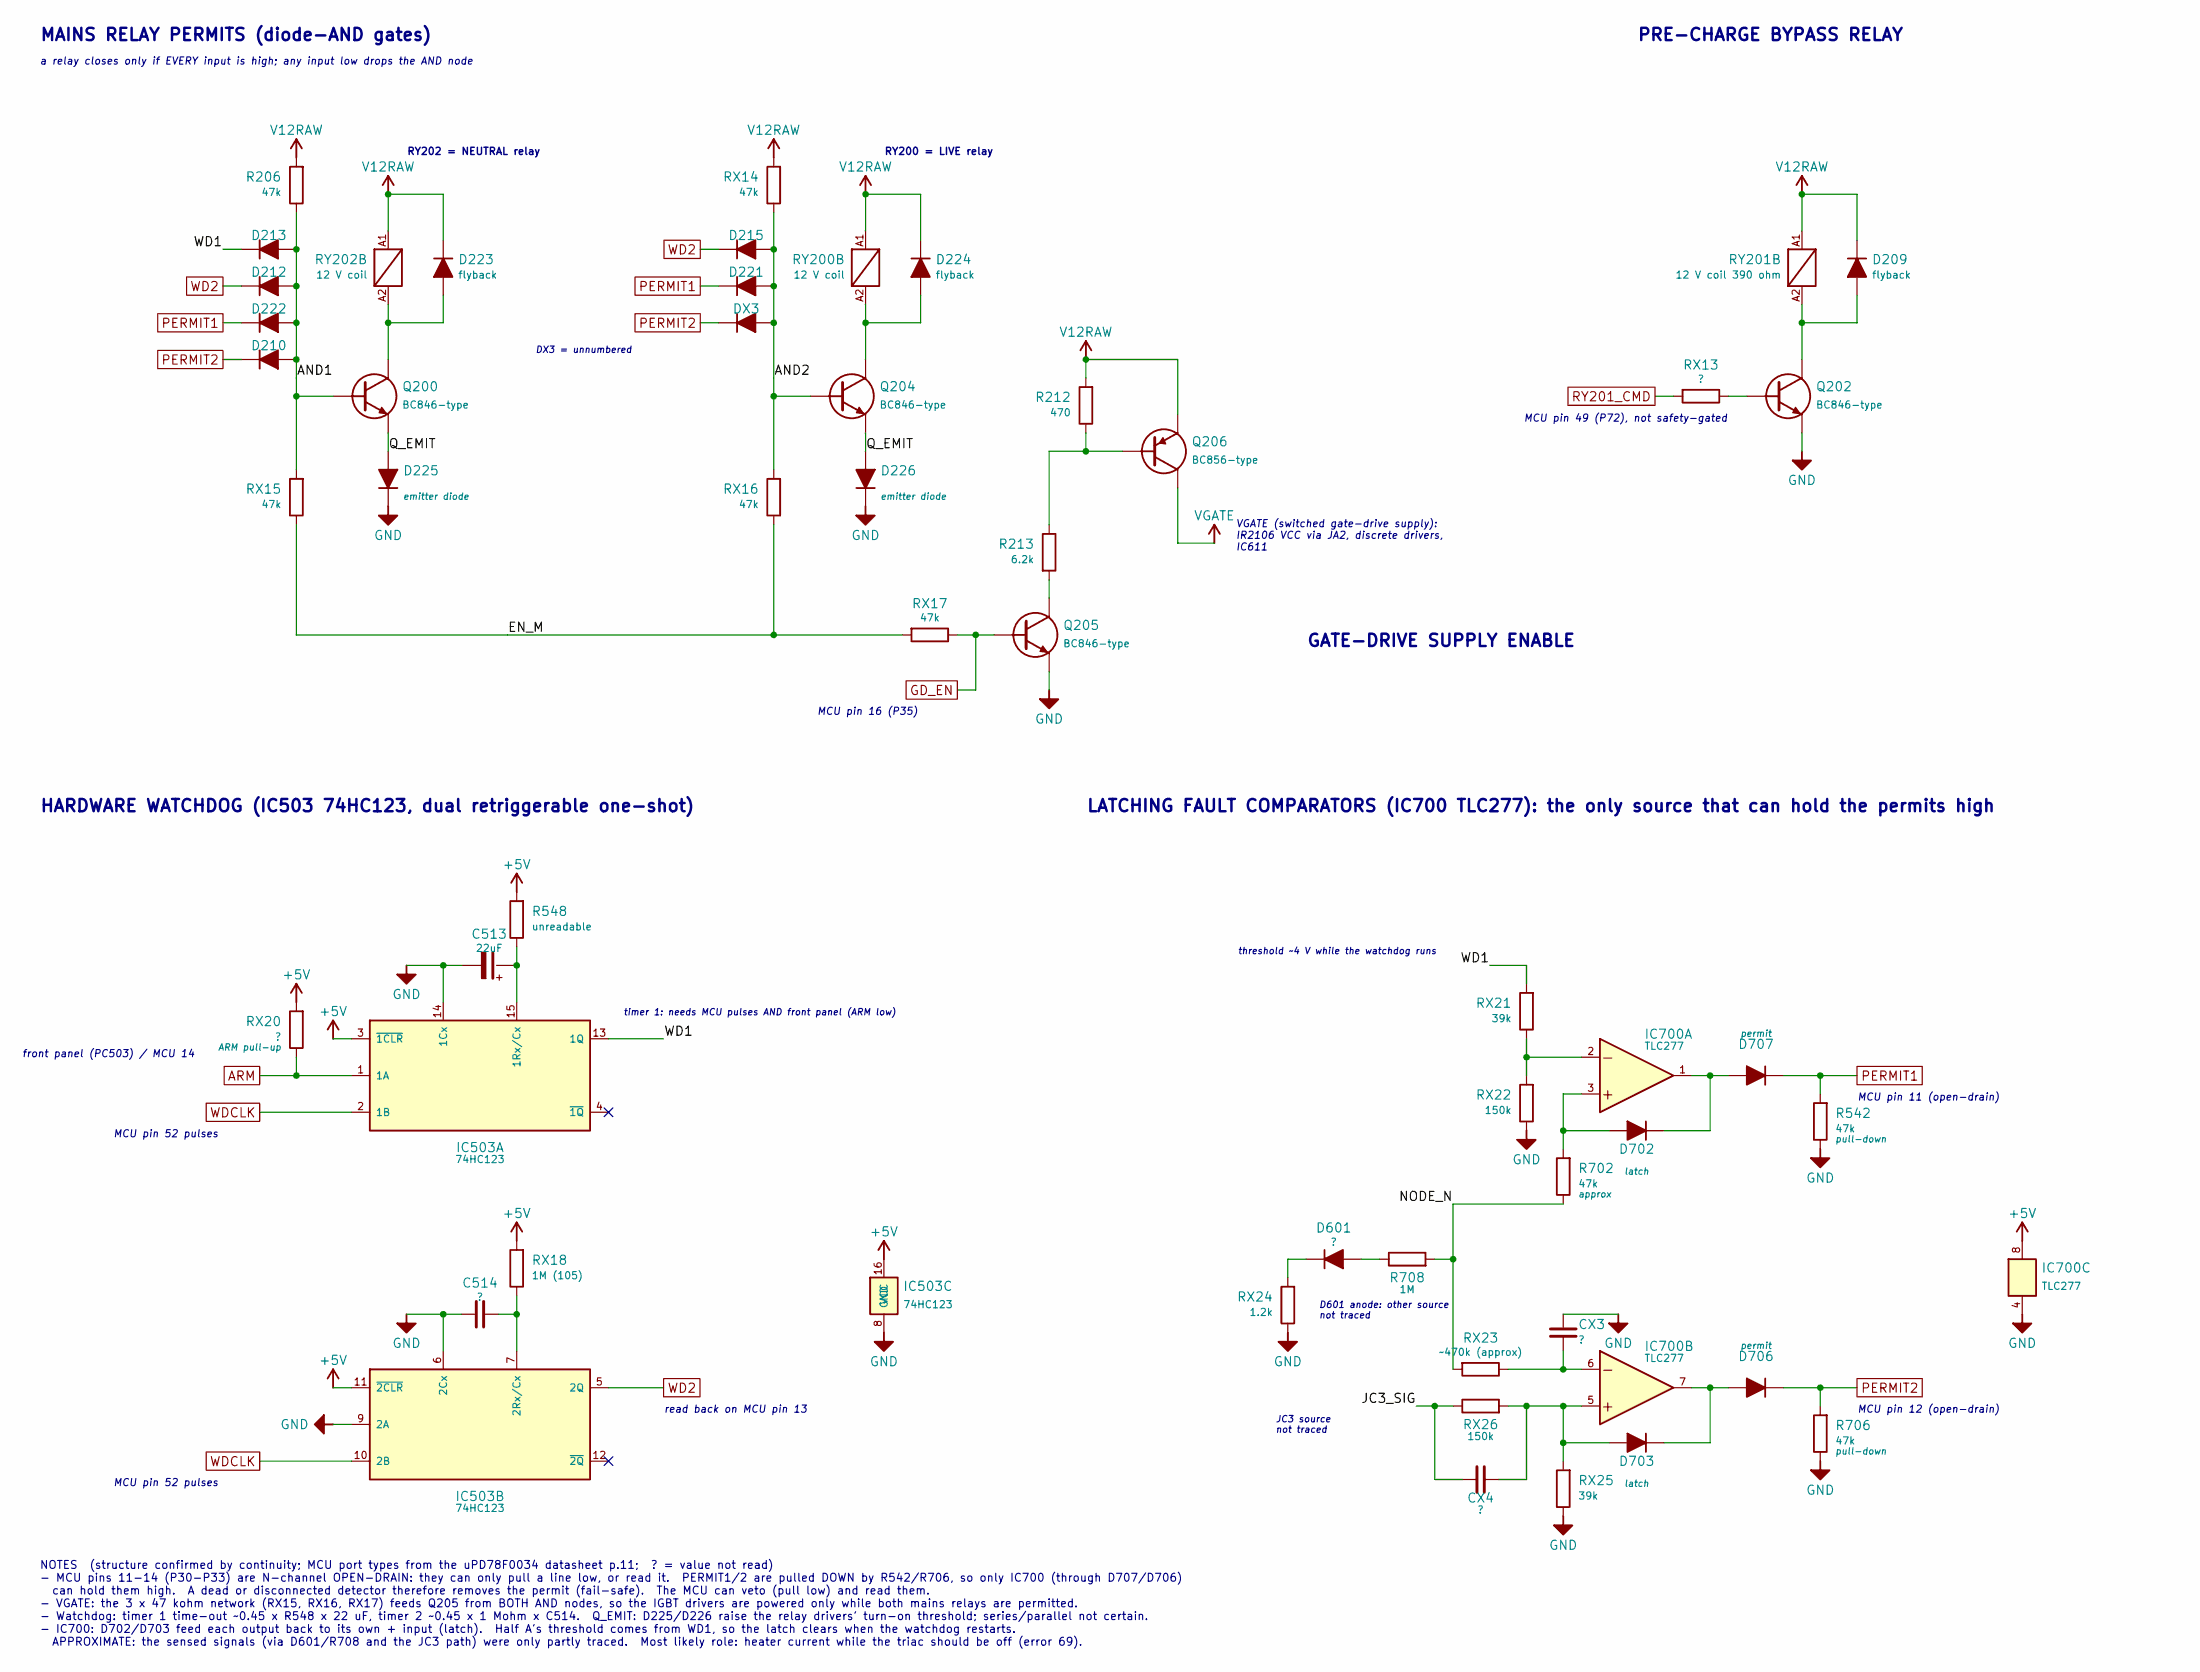
[picture p39: schematic safety_logic.kicad_sch]

Parts:
C513: 22uF
C514: ?
CX3, CX4: ?
D209, D223, D224: flyback
D210, D212, D213, D215, D221, D222, D225, D226, D702, D703, D706, D707: (no value)
D601: ?
DX3: (no value)
IC503: 74HC123
IC700: TLC277
Q200, Q202, Q204, Q205: BC846-type
Q206: BC856-type
R206, R542, R702, R706: 47k
R212: 470
R213: 6.2k
R548: unreadable
R708: 1M
RX13, RX20: ?
RX14, RX15, RX16, RX17: 47k
RX18: 1M (105)
RX21, RX25: 39k
RX22, RX26: 150k
RX23: ~470k (approx)
RX24: 1.2k
RY200, RY202: 12 V coil
RY201: 12 V coil 390 ohm

Connections:
+5V: IC503.3 (~1CLR), IC503.11 (~2CLR), IC503.16 (VCC), IC700.8 (V+), R548.1, RX18.1, RX20.1
AND1: D210.2 (A), D212.2 (A), D213.2 (A), D222.2 (A), Q200.1 (B), R206.2, RX15.1
AND2: D215.2 (A), D221.2 (A), DX3.2 (A), Q204.1 (B), RX14.2, RX16.1
ARM: IC503.1 (1A), RX20.2
EN_M: RX15.2, RX16.2, RX17.1
GD_EN: Q205.1 (B), RX17.2
GND: C513.2 (-), C514.2, CX3.2, D225.1 (K), D226.1 (K), IC503.6 (2Cx), IC503.8 (GND), IC503.9 (2A), IC503.14 (1Cx), IC700.4 (V-), Q202.2 (E), Q205.2 (E), R542.2, R706.2, RX22.2, RX24.2, RX25.2
JC3_SIG: CX4.2, RX26.2
NODE_N: R702.2, R708.1, RX23.1
unnamed: C513.1 (+), IC503.15 (1Rx/Cx), R548.2
unnamed: C514.1, IC503.7 (2Rx/Cx), RX18.2
unnamed: CX3.1, IC700.6 (-), RX23.2
unnamed: CX4.1, D703.2 (A), IC700.5 (+), RX25.1, RX26.1
unnamed: D209.2 (A), Q202.3 (C), RY201.A2
unnamed: D223.2 (A), Q200.3 (C), RY202.A2
unnamed: D224.2 (A), Q204.3 (C), RY200.A2
unnamed: D601.1 (K), RX24.1
unnamed: D601.2 (A), R708.2
unnamed: D702.1 (K), D707.2 (A), IC700.1
unnamed: D702.2 (A), IC700.3 (+), R702.1
unnamed: D703.1 (K), D706.2 (A), IC700.7
unnamed: IC700.2 (-), RX21.2, RX22.1
unnamed: Q202.1 (B), RX13.2
unnamed: Q205.3 (C), R213.1
unnamed: Q206.1 (B), R212.2, R213.2
PERMIT1: D221.1 (K), D222.1 (K), D707.1 (K), R542.1
PERMIT2: D210.1 (K), D706.1 (K), DX3.1 (K), R706.1
Q_EMIT: D225.2 (A), D226.2 (A), Q200.2 (E), Q204.2 (E)
RY201_CMD: RX13.1
V12RAW: D209.1 (K), D223.1 (K), D224.1 (K), Q206.2 (E), R206.1, R212.1, RX14.1, RY200.A1, RY201.A1, RY202.A1
VGATE: Q206.3 (C)
WD1: D213.1 (K), IC503.13 (1Q), RX21.1
WD2: D212.1 (K), D215.1 (K), IC503.5 (2Q)
WDCLK: IC503.2 (1B), IC503.10 (2B)

Notes on the sheet:
MAINS RELAY PERMITS (diode-AND gates)
a relay closes only if EVERY input is high; any input low drops the AND node
RY202 = NEUTRAL relay
RY200 = LIVE relay
DX3 = unnumbered
MCU pin 16 (P35)
VGATE (switched gate-drive supply): IR2106 VCC via JA2, discrete drivers, IC611
GATE-DRIVE SUPPLY ENABLE
PRE-CHARGE BYPASS RELAY
MCU pin 49 (P72), not safety-gated
HARDWARE WATCHDOG (IC503 74HC123, dual retriggerable one-shot)
front panel (PC503) / MCU 14
MCU pin 52 pulses
timer 1: needs MCU pulses AND front panel (ARM low)
read back on MCU pin 13
LATCHING FAULT COMPARATORS (IC700 TLC277): the only source that can hold the permits high
MCU pin 11 (open-drain)
threshold ~4 V while the watchdog runs
MCU pin 12 (open-drain)
JC3 source not traced
D601 anode: other source not traced
NOTES (structure confirmed by continuity; MCU port types from the uPD78F0034 datasheet p.11; ? = value not read) - MCU pins 11-14 (P30-P33) are N-channel OPEN-DRAIN: they can only pull a line low, or read it. PERMIT1/2 are pulled DOWN by R542/R706, so only IC700 (through D707/D706) can hold them hi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
