junado/thermomix-tm31-power-board/(commit log)

2026-11-04 TM31 power board: repair log and reverse-engineering documentation
    Documentation of a Thermomix TM31-4C (120 V) no-heat repair (cracked
    heater-triac leg) and a near-complete trace of power board NPVTM31LTA-3:
    photos, annotated maps, KiCad schematic (8 sheets) + PDF, parts and
    measurement tables, connector pinouts, safety-logic analysis,
    troubleshooting guide, unknowns, datasheet links and generator scripts.
    Claude-Session: https://claude.ai/code/session_01L83uDB3r8K2g3HfawooQdt
    [TM31_power_board.kicad_sch, analog_sense.kicad_sch, mains_heater.kicad_sch, mcu_links.kicad_sch, motor_bus.kicad_sch, motor_stage.kicad_sch, power_supply.kicad_sch, safety_logic.kicad_sch]
2026-11-04 Redraw schematic as wired circuits (rev 0.2); archive MCU datasheet
    - Schematic rev 0.2: every sheet redrawn as connected circuits (wires,
    power symbols for rails, global labels only between sheets). Relays,
    op-amps and the 74HC123 are split into units so coils and halves sit
    next to their circuits.
    - Connections verified identical to rev 0.1 by netlist comparison
    (195 components, 186 nets); tools/check_schematic.sh reruns the check.
    - Netlist export added in hardware/.
    - MCU datasheet archived unmodified in datasheets/archive/ with a
    third-party notice, SHA-256 manifest and REUSE.toml.
    Claude-Session: https://claude.ai/code/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
    [TM31_power_board.kicad_sch, analog_sense.kicad_sch, mains_heater.kicad_sch, mcu_links.kicad_sch, motor_bus.kicad_sch, motor_stage.kicad_sch, power_supply.kicad_sch, safety_logic.kicad_sch]
2026-11-04 Add self-hostable documentation website
    - website/: MkDocs Material configuration, staging script and assets.
    The site is built from the repository's own Markdown, adds photo
    galleries and a schematic viewer, and works offline and from file://
    (Mermaid and the search shim are vendored; system fonts only).
    - tools/build_site.sh builds ./site in strict mode (fails on broken links).
    - .github/workflows/pages.yml publishes the site on GitHub Pages.
    - hardware/svg/: one SVG per schematic sheet.
    - REUSE.toml: vendored JavaScript is MIT.
    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
